blackfyre/spooder/openspec/specs/parametric-reference-parts/spec.md

# parametric-reference-parts Specification

## Purpose
Parametric solids of the reference printed parts (Aecert's hexapod and LilyGO's case shell), built from named dimensions, checked against their STL meshes and exported as STEP that opens in FreeCAD and solidcraft.

## Requirements

### Requirement: Parts built from named dimensions
Each converted part SHALL be generated by code from named, documented dimensions measured from its reference STL, and built from modelling features (sketches, extrusions, holes, chamfers, fillets), so that changing a dimension and rebuilding yields the changed part. A part SHALL NOT be produced by converting the mesh's triangles into a solid: part code SHALL NOT read files, and the build SHALL fail on a file in a parts folder that imports anything outside the stated allowlist or calls a file-reading or code-loading function. Each part SHALL be built in its reference STL's own coordinate frame. The reference files SHALL stay unchanged.

#### Scenario: A dimension changes
- **WHEN** a named dimension of a part is changed and the build is run in check mode
- **THEN** the part is rebuilt with that dimension, and the gates report its deviation from the STL

#### Scenario: A part file reads a mesh
- **WHEN** a file in a parts folder imports a module outside the allowlist, imports a mesh- or file-import function, or calls `open`
- **THEN** the build fails naming the part file, and writes no files

#### Scenario: Coordinate frame kept
- **WHEN** a built part is compared with its STL
- **THEN** both are compared in the STL's coordinates, without any alignment or transform

### Requirement: Parts discovered without a registry
The build SHALL find every part from its own file in a source's parts folder, with no shared list of parts. Each discovered part file SHALL declare exactly one part, except a mirrored pair; helper files, which the build does not discover, declare none. A mirrored pair SHALL be modelled once in one file that declares both sides, the second only by naming the first and the mirror plane, so that the build makes it as the mirror of the first; each side SHALL be checked against its own STL. The build SHALL fail on a discovered file declaring no part, more than one part (other than a mirrored pair), or a second side with its own model. Adding a part SHALL need only its part file, its committed STEP output, its source README's section and a changelog entry.

#### Scenario: A part file is added
- **WHEN** a new part file is placed in a source's parts folder
- **THEN** the next build checks and exports that part without any other file being edited

#### Scenario: A mirrored pair
- **WHEN** a part file declares a left and a right side, one the mirror of the other
- **THEN** the build checks each side against its own STL and exports each side

### Requirement: Gates against the reference STL
In check mode the build SHALL check each part and report every failure by part and gate. A part SHALL pass only when:
- it is one valid, closed solid;
- its volume lies within the stated volume tolerance of its STL's;
- the symmetric surface deviation, from points on the part's surface to the STL and from points on the STL to the part, has a maximum and a 95th percentile within the stated limits, where the points on each side include every vertex of that side's mesh subdivided to a stated maximum edge length as well as points sampled by area, and the documentation states the resulting bound on the unsampled deviation;
- each face of its bounding box lies within the stated tolerance of the STL's.

The tolerances SHALL be stated in the documentation with their justification against the STL's tessellation chord error. A part that cannot meet a gate with feature-based modelling SHALL have a documented, per-part exception naming the feature and the amount; the global tolerances SHALL NOT be loosened for it.

#### Scenario: A part fails a gate
- **WHEN** any part fails any gate
- **THEN** the build names the part, the gate and the measured value against its limit, exits non-zero, and writes no files

#### Scenario: Deviation measured both ways
- **WHEN** a part lacks a feature the STL has, or has a feature the STL lacks, standing more than the maximum deviation plus the stated sampling bound off the other surface, however small its area
- **THEN** the surface deviation gate fails

#### Scenario: Documented exception
- **WHEN** a part declares an exception for one gate
- **THEN** that part is checked against the exception's limit, the build prints the exception, and every other part keeps the global limits

### Requirement: STEP export written only after re-reading
When every part passes, the build SHALL write each part as STEP into a staging folder, re-read each file there as one solid with the built part's volume and bounding box, and only then replace the committed STEP folder as a whole, so that the folder never holds a mixture of old and new files; a run interrupted during the replacement SHALL leave the old files complete, and the next build SHALL restore them before anything else. STEP files of parts that no longer exist SHALL be removed. An unchanged part SHALL write an unchanged file.

#### Scenario: Export succeeds
- **WHEN** all gates pass and every staged STEP re-reads correctly
- **THEN** the STEP folder holds exactly one file per current part

#### Scenario: Re-read fails
- **WHEN** a staged STEP does not re-read as one solid with matching volume
- **THEN** the build reports it and the committed STEP folder is left as it was

#### Scenario: Replacement fails
- **WHEN** replacing the committed STEP folder with the staged one fails part way
- **THEN** the committed STEP folder holds either all the old files or all the new ones, or is restored with all the old files by the next build

### Requirement: Import checks in FreeCAD and solidcraft
The build SHALL check that each committed STEP imports as one closed solid, with volume within the stated tolerance of the built part's, in FreeCAD run headless and in solidcraft-cli. Each import check SHALL report its result per part, with the tool's version. When a tool is not installed, its check SHALL report `SKIPPED` with the reason, and the build's summary SHALL say which checks were skipped; it SHALL NOT report a pass. A failed import check SHALL fail the build. The tool versions last checked SHALL be recorded in the documentation.

#### Scenario: Tool present
- **WHEN** FreeCAD or solidcraft-cli is installed and a STEP imports as one solid with matching volume
- **THEN** the check reports a pass for that part with the tool's version

#### Scenario: Tool absent
- **WHEN** FreeCAD or solidcraft-cli is not installed, as on CI
- **THEN** the check reports `SKIPPED` naming the missing tool, and the summary lists it as skipped, not passed

#### Scenario: Import mismatch
- **WHEN** a STEP imports as more than one solid, or as an open shell, or with a volume outside tolerance
- **THEN** the build fails naming the part, the tool and the measured value

### Requirement: Documentation of the parametric parts
The parametric parts folder SHALL carry a README stating how a part is added, the part file's contract, the gates and their tolerances, the import checks with the tool versions checked, and how to run the build. Each source SHALL carry a README stating its source repository, the reference commit, its licence (for Aecert's parts: that upstream states no licence, said plainly, and beside it that the author knows about Spooder's derived models and has raised no concerns, stated as informal and not a licence), and a parts table per group, each part with its STL, its STEP file and any gate exception.

#### Scenario: A part is listed
- **WHEN** a part's file exists in a source's parts folder
- **THEN** that source's README lists the part with its STL and STEP file

#### Scenario: An exception is documented
- **WHEN** a part declares a gate exception
- **THEN** the source README names the feature responsible and the amount by which it exceeds the global limit

#### Scenario: Author's awareness stated
- **WHEN** the Aecert source README states that upstream gives no licence
- **THEN** it states beside it that the author knows about Spooder's derived models and has raised no concerns, and that this is informal and grants no licence

### Requirement: The frame group
The Aecert source SHALL include the frame group: Frame Top, Frame Bottom, Servo Mount, Bearing Axle Mount and Hubcap, each passing the gates and exported as STEP.

#### Scenario: Frame group built
- **WHEN** the build is run
- **THEN** it checks and exports the five frame parts, each against its STL in `hardware/aecert-hexapod-v1/stl/`

#### Scenario: A frame part is missing
- **WHEN** any of the five frame parts is not declared in the Aecert source's parts folder
- **THEN** the unit tests fail naming the missing part

### Requirement: The coxa group
The Aecert source SHALL include the coxa group: Coxa Horn Connector, Coxa Horn Side, Coxa Bearing Connector and Coxa Bearing Side, each modelled from features with named, sourced dimensions in its STL's own coordinates, each passing the gates under the global limits (or a documented per-part exception where the STL's own chord error exceeds 0.15 mm, or for a named feature that feature-based modelling cannot match, with its size), and each exported as STEP that passes the FreeCAD and solidcraft import checks where the tool is installed. The source README SHALL compare the built parts with the coxa link geometry that `hardware/aecert-hexapod-v1/README.md` records (the tongues' insert holes 21.5 mm from the coxa axis, the 8.05 mm ring, the ears 30.10 mm either side of the 28.5 mm hole pair's middle, the 68.25 × 48 mm side plates), giving for each value the recorded value and the model's, and state each disagreement. The unit tests SHALL check that the four coxa parts are declared and that the model's values in that comparison match the built solids.

#### Scenario: Coxa group built
- **WHEN** the build is run
- **THEN** it checks and exports the four coxa parts, each against its STL in `hardware/aecert-hexapod-v1/stl/`, and each STEP file passes the FreeCAD and solidcraft import checks where the tool is installed, and reports `SKIPPED` where it is not

#### Scenario: A coxa part is missing
- **WHEN** any of the four coxa parts is not declared in the Aecert source's parts folder
- **THEN** the unit tests fail naming the missing part

#### Scenario: Coxa comparison matches the built parts
- **WHEN** the unit tests build the four coxa parts
- **THEN** each value of the recorded coxa link geometry, measured on the built solids, matches the model's value that the source README's coxa comparison states to 0.01 mm, the comparison's recorded values match those in `hardware/aecert-hexapod-v1/README.md`, each difference above 0.05 mm is marked as a disagreement and no other is, and a part changed so that a compared value moves fails the test

#### Scenario: Recorded coxa geometry compared
- **WHEN** a value of the coxa link geometry recorded in `hardware/aecert-hexapod-v1/README.md` differs from the built part's by more than 0.05 mm
- **THEN** the source README marks it as a disagreement, with the recorded value, the model's value and the part

### Requirement: The femur group
The Aecert source SHALL include the femur group: Femur Horn Side, Femur Bearing Side and Femur Support, each built from features in its STL's own coordinates, passing the gates (with only documented per-part exceptions) and exported as STEP. The femur's axis-to-axis length, the distance between the two bore axes of each femur side plate, SHALL be one named constant from which both side plates place their bores, and the unit tests SHALL check it against the bore axes found on the built solids.

#### Scenario: Femur group built
- **WHEN** the build is run
- **THEN** it checks and exports Femur Horn Side, Femur Bearing Side and Femur Support, each against its STL in `hardware/aecert-hexapod-v1/stl/`, and each STEP file passes the FreeCAD and solidcraft import checks where the tool is installed, and reports `SKIPPED` where it is not

#### Scenario: A femur part is missing
- **WHEN** any of the three femur parts is not declared in the Aecert source's parts folder
- **THEN** the unit tests fail naming the missing part

#### Scenario: Axis-to-axis length checked
- **WHEN** the unit tests build Femur Horn Side and Femur Bearing Side
- **THEN** each side's two bore axes, found from the solid's cylindrical faces, lie the named axis-to-axis length apart, and a bore placed elsewhere fails the test

#### Scenario: Axis-to-axis length changed
- **WHEN** the unit tests rebuild Femur Horn Side and Femur Bearing Side with the named axis-to-axis length changed
- **THEN** both sides' bore axes lie the changed length apart, and a side that does not place its bores from the named length fails the test

### Requirement: The feet group
The Aecert source SHALL include the feet group: Foot Left, Foot Right, Foot Shaft and Foot Tip, each built from named dimensions in its STL's coordinates, passing the gates (the global limits, or a documented per-part exception) and exported as STEP. The serpentine flexure in Foot Left and Foot Right SHALL be modelled from named dimensions of its path and beam widths, shared by both feet, so that changing one and rebuilding changes the spring of both. Foot Right SHALL be built from Foot Left's model, not modelled separately: since its STL is Foot Left's mirror image moved 1.069 mm along y, which a mirror plane cannot express, Foot Right SHALL be a part file of its own whose build mirrors Foot Left's solid and moves it, rather than the second side of a mirrored pair.

#### Scenario: Feet group built
- **WHEN** the build is run
- **THEN** it checks and exports Foot Left, Foot Right, Foot Shaft and Foot Tip, each against its STL in `hardware/aecert-hexapod-v1/stl/`, and each STEP file imports as one closed solid in FreeCAD and solidcraft

#### Scenario: A foot part is missing
- **WHEN** any of the four foot parts is not declared in the Aecert source's parts folder
- **THEN** the unit tests fail naming the missing part

#### Scenario: The flexure is retuned
- **WHEN** a flexure beam width in the shared foot model is raised by 0.3 mm and both feet are rebuilt
- **THEN** Foot Left and Foot Right both differ from their unchanged builds, and each fails its volume or surface deviation gate against its STL

#### Scenario: A foot STL's chord error is too coarse
- **WHEN** a foot part's STL chord error, as `chord_error.measure` gives it, exceeds 0.15 mm
- **THEN** that part declares a `deviation_max` exception naming the feature, with the limit at the chord error plus 0.05 mm rounded up to 0.01 mm, and the source README's row for it gives the feature, the limit and the amount over the global limit

#### Scenario: A foot feature is freeform
- **WHEN** a foot part has a freeform feature that feature-based modelling cannot match
- **THEN** that part declares an exception for the failing gate only, whose reason starts with "freeform" and whose limit exceeds the global limit, and the source README's row for it gives the feature, the limit and the amount over the global limit

#### Scenario: Other foot parts keep the global limits
- **WHEN** a foot part's chord error is at most 0.15 mm and it has no freeform feature
- **THEN** it declares no exception
