blackfyre/spooder/openspec/specs/gamepad-control/spec.md

# gamepad-control Specification

## Purpose
How the gamepad bridge turns a Bluetooth gamepad's input into the commands it sends the robot.

## Requirements

### Requirement: Stick modes
The bridge SHALL offer two stick modes, steer and crab, toggled by `b` (one toggle per press) and kept across a controller reconnect like the other settings. Steer SHALL be the default. This requirement supersedes the stick rows of the input mapping table.
- In steer mode, left stick Y SHALL set the forward or backward translate, left stick X SHALL steer, and the translate's sideways part SHALL be zero. While the left stick points backward by more than 10 %, the robot SHALL reverse and steering SHALL be mirrored as a car's is: steering left while reversing turns the body clockwise. Between 0 and 10 % backward there SHALL be no reverse and no mirroring, so that a stick held sideways turns the body on the spot without flipping direction.
- In crab mode, the left stick SHALL set the translate vector and the right stick X the rotate amount, as before.
- In both modes, right stick X SHALL add to the rotate amount, and the sum SHALL be clamped to −100..100. A stick pushed right SHALL turn the body clockwise, and left anticlockwise.
- The status screen SHALL show the stick mode.

#### Scenario: Steering while walking
- **WHEN** steer mode is on and the left stick points forward and to the left
- **THEN** the command carries a forward translate with no sideways part and a rotate amount that turns the body anticlockwise

#### Scenario: Steering while reversing
- **WHEN** steer mode is on and the left stick points backward and to the left
- **THEN** the command carries a backward translate and a rotate amount that turns the body clockwise

#### Scenario: Crab mode keeps the old layout
- **WHEN** crab mode is on and the left stick points to the right
- **THEN** the command carries a sideways translate and no rotation

### Requirement: Supported controllers
The bridge SHALL accept one gamepad at a time through Bluepad32, including Bluetooth Classic gamepads such as DualShock 4, DualSense, Switch Pro and 8BitDo pads. A second gamepad SHALL be refused while one is connected.

#### Scenario: Second gamepad
- **WHEN** a gamepad is connected and another tries to connect
- **THEN** the second gamepad is refused and the first keeps control

### Requirement: Input mapping
The bridge SHALL map gamepad input to the desired movement state as follows. Button names are Bluepad32's.

| Input | Effect |
|---|---|
| Left stick | Translate vector, scaled to −100..100 per axis, magnitude clamped to 100 |
| Right stick X | Rotate amount, −100..100; right stick Y unused |
| `miscHome` (press) | Toggle requested mode between Stand and Walk |
| `y` (press) | Toggle Sleep. Leaving Sleep returns to the mode requested before it |
| `miscBack` + `miscHome` held 1 s | Toggle Calibrate. Leaving it returns to Stand |
| `r1` / `l1` (press) | Next / previous gait, wrapping around |
| D-pad up / down (press) | Body height +10 / −10, within 0..100 |
| D-pad right / left (press) | Speed +10 / −10, within 0..100 |
| `x` (press) | Toggle stride mode between dynamic and fixed |
| `thumbL` + `thumbR` held 1 s | Fault-clear request |

Toggles and steps SHALL act once per press. Holding a button SHALL NOT repeat it.

#### Scenario: Gait selection wraps
- **WHEN** the last gait is selected and `r1` is pressed
- **THEN** the first gait is selected

#### Scenario: Calibrate needs a deliberate hold
- **WHEN** `miscBack` and `miscHome` are pressed together and released after 0.5 s
- **THEN** Calibrate is not toggled

### Requirement: Stick dead zone
Stick deflections within a radial dead zone of 8 % of full scale SHALL be reported as zero. Outside the dead zone, output SHALL rise continuously from zero, with no jump at the edge.

#### Scenario: Drifting stick
- **WHEN** the left stick rests at 5 % deflection
- **THEN** the translate vector is zero

#### Scenario: Continuous beyond the dead zone
- **WHEN** the left stick moves from 7 % to 10 % deflection
- **THEN** the translate magnitude rises from zero without a step

### Requirement: Controller connection
While no gamepad is connected, the bridge SHALL request Sleep with zero translate and rotate, and report that no controller is connected. When a gamepad connects, the requested mode SHALL start as Stand, and the height, speed, gait and stride settings SHALL be kept from before.

#### Scenario: Gamepad disconnects while walking
- **WHEN** the gamepad disconnects while the robot is walking
- **THEN** the bridge's next command frame requests Sleep with zero input

#### Scenario: Reconnect
- **WHEN** a gamepad reconnects
- **THEN** the requested mode is Stand and the previous height, speed and gait are kept

### Requirement: Bridge emergency-stop button
The bridge's GPIO35 button SHALL toggle emergency stop. While emergency stop is active, the bridge SHALL signal it in every command frame and show it on the screen.

#### Scenario: Emergency stop from the bridge
- **WHEN** the GPIO35 button is pressed
- **THEN** every subsequent command frame signals emergency stop until the button is pressed again

### Requirement: Rumble feedback
The bridge SHALL rumble the connected gamepad when a protection fault newly latches on the robot, when its own emergency stop switches on or off, when the robot link is lost or regained while a gamepad is connected, and when a gesture request is not acted on within 0.6 s, with a distinct pattern per event. Faults and stops present when the gamepad connects SHALL NOT rumble. A more important event SHALL replace a lighter rumble in progress, a lighter event during a more important rumble SHALL play after it, and the same event SHALL NOT repeat within 1 s.

#### Scenario: Fault while driving
- **WHEN** the robot latches an overcurrent fault while the gamepad drives it
- **THEN** the gamepad rumbles long and strong once

#### Scenario: Existing fault on connect
- **WHEN** a gamepad connects while a fault is already latched
- **THEN** the gamepad does not rumble for it

#### Scenario: Refused gesture
- **WHEN** a gesture is requested while the robot walks
- **THEN** the gamepad gives a light tap about 0.6 s later
