blackfyre/spooder/.archify/architecture-spooder-system-20261018-171500/spooder-system.html

Dark

Style

Visual identitySto cycle

ClassicStable technical default Signal FlowMotion-forward presentation BlueprintEngineering review EditorialPublication and launch notes

Live Present

Export

Export diagramPortable, clean outputs

E

Share Route Share Card1200×630 PNG Reach Share Card1200×630 PNG Copy diagramPNG to clipboard

Image PNGLossless image JPEGCompact image WebPModern image

Vector & motion SVG · AutoMatches host theme SVG · LightAlways light SVG · DarkAlways dark WebM6s motion

# Spooder: robot, gamepad bridge, desktop tools and virtual robot

Diagram guide Explore this system ×

Inspecting compiled semantics

01 Find any nodeSearch labels, responsibilities, kinds, and stable IDs. / 02 Trace a routeAsk how two semantic nodes connect in authored direction. R 03 See the whole systemOpen Semantic Radar with a live viewport and stable nodes. M 04 Compare semantic kindsCount roles, reveal their traffic, and compare direct authored links. L 05 Enter Presentation StageGive the live diagram the viewport without changing export. F

E ExportT ThemeS Style0 Reset+ Zoom in- Zoom outEsc Close

Find Archify useful? A star on GitHub helpsStar ↗ (https://github.com/tt-a1i/archify)

Find a node ×

⌕ /

No matching nodes

Semantic passport

Verified source

Authored reach

Upstream0 Downstream0

× Copy link Relations

Path Click where the path starts Find start Copy link Clear

Click two nodes on the diagram

← ▶ Journey → Overview

Click a start, then an end. Paths follow the arrows.

Semantic lens Compare system roles ×

Choose up to two semantic kinds. One reveals its real traffic; two compare only direct authored relationships.

Choose a kind to inspect its nodes and touching relationships.

Copy link Clear

Semantic radar Building overview Open radar ×

Click nodeDrag to pan

Semantic radar needs more MAP space.

Notes & index

ROUTE MAP LENS 100%

### How to read

- Built and host-tested at 1c5d910; bring-up on hardware in progress
- Tagged "planned": suspended sensor work
- Bridge: Bluetooth in normal mode, WiFi only in setup mode
- Virtual robot: the Servo 2040's robot_tick on the host, for desktop-sim and e2e

### Safety rules

- Input, then protection, every 20 ms tick
- E-stop from either link latches; clear only from the source in control
- Both links claiming control: conflict, robot sleeps
- Calibration only in Calibrate, ±30° of defaults, 60°/s; coxas shown from centre

### Link protocol v2

- Commands 50 Hz, telemetry 10 Hz, CRC-16 frames
- Pose 10 Hz, USB only: command, servo angle and pulse per joint
- Calibration sets resent until a report confirms them
- Golden vectors shared by the C++ and Go tests
