blackfyre/spooder/.archify/architecture-spooder-planned-20261017-061917/spooder-planned.html

Dark

Style

Visual identitySto cycle

ClassicStable technical default Signal FlowMotion-forward presentation BlueprintEngineering review EditorialPublication and launch notes

Live Present

Export

Export diagramPortable, clean outputs

E

Share Route Share Card1200×630 PNG Reach Share Card1200×630 PNG Copy diagramPNG to clipboard

Image PNGLossless image JPEGCompact image WebPModern image

Vector & motion SVG · AutoMatches host theme SVG · LightAlways light SVG · DarkAlways dark WebM6s motion

# Spooder: built firmware and planned bridge and sensors

Diagram guide Explore this system ×

Inspecting compiled semantics

01 Find any nodeSearch labels, responsibilities, kinds, and stable IDs. / 02 Trace a routeAsk how two semantic nodes connect in authored direction. R 03 See the whole systemOpen Semantic Radar with a live viewport and stable nodes. M 04 Compare semantic kindsCount roles, reveal their traffic, and compare direct authored links. L 05 Enter Presentation StageGive the live diagram the viewport without changing export. F

E ExportT ThemeS Style0 Reset+ Zoom in- Zoom outEsc Close

Find Archify useful? A star on GitHub helpsStar ↗ (https://github.com/tt-a1i/archify)

Find a node ×

⌕ /

No matching nodes

Semantic passport

Verified source

Authored reach

Upstream0 Downstream0

× Copy link Relations

Path Click where the path starts Find start Copy link Clear

Click two nodes on the diagram

← ▶ Journey → Overview

Click a start, then an end. Paths follow the arrows.

Semantic lens Compare system roles ×

Choose up to two semantic kinds. One reveals its real traffic; two compare only direct authored relationships.

Choose a kind to inspect its nodes and touching relationships.

Copy link Clear

Semantic radar Building overview Open radar ×

Click nodeDrag to pan

Semantic radar needs more MAP space.

Notes & index

ROUTE MAP LENS 100%

### How to read

- Tagged "planned" and dashed: designed in OpenSpec, not built yet
- Everything else is built and host-tested at commit 61f6b99

### Protection rules

- Output only after 500 ms of valid supply
- Overcurrent, brown-out, overvoltage: output cut at once
- Sustained current, undervoltage: Sleep
- After any fault nothing moves until a new request

### Planned link and sensors

- Bridge replaces the serial hook; frames carry desired state, not events
- Robot sleeps if no valid frame arrives for 1 s
- Sensors read on core 1, handed to core 0 by seqlock; telemetry only for now
