blackfyre/spooder/openspec/specs/static-checks/spec.md

# static-checks Specification

## Purpose
Static checks of Spooder's own C++ and Go: a formatting check of the C++, clang-tidy on the hardware-free core, and staticcheck on the desktop calibrator, all with pinned tools and part of the verification gates.

## Requirements

### Requirement: C++ formatting check
The repository SHALL have a `.clang-format` at its root, and `mise run lint` SHALL fail when any C++ source or header, tracked or untracked but not git-ignored, in Spooder's own directories (`core/`, `firmware/servo2040/src/`, `firmware/bridge/main/`, `test/`, `tools/virtual-robot/`, `tools/bridge-screenshots/`) differs from its clang-format output, naming each such file. The check SHALL NOT cover `external/`, `managed_components/`, the generated fonts in `firmware/bridge/main/fonts/`, `test/golden/` or `core/movement/calibration_defaults.cpp`, and SHALL NOT modify any file.

#### Scenario: Unformatted file
- **WHEN** a C++ file in a checked directory is not in clang-format's layout
- **THEN** `mise run lint` exits non-zero and names the file, and the file is unchanged

#### Scenario: New file not yet staged
- **WHEN** an untracked, not git-ignored C++ file in a checked directory is not in clang-format's layout
- **THEN** `mise run lint` exits non-zero and names the file

#### Scenario: Excluded files
- **WHEN** a file under `external/`, `managed_components/`, `firmware/bridge/main/fonts/` or `test/golden/`, or `core/movement/calibration_defaults.cpp`, is not in clang-format's layout
- **THEN** `mise run lint` does not report it

#### Scenario: Exported calibration stays valid
- **WHEN** the desktop calibrator exports `core/movement/calibration_defaults.cpp`
- **THEN** `mise run lint` still passes without reformatting the export

### Requirement: Static analysis of the core
`mise run lint` SHALL run clang-tidy, with the checks configured in a root `.clang-tidy`, on every `core/` source file in the host compile database, reporting findings in `core/` headers too. The check set SHALL include `bugprone-*` and narrowing conversions, and every enabled check's finding SHALL fail the task. A finding SHALL be fixed, or suppressed at the line or in the configuration with a comment giving the reason.

#### Scenario: New finding
- **WHEN** a change to `core/` introduces a finding of an enabled check, such as a narrowing conversion from `float` to `int`
- **THEN** `mise run lint` exits non-zero and reports the file, line and check

#### Scenario: Finding in a core header
- **WHEN** a header in `core/` included by an analysed source contains a finding of an enabled check
- **THEN** `mise run lint` exits non-zero and reports the header, line and check

#### Scenario: Every core source analysed
- **WHEN** `mise run lint` runs
- **THEN** clang-tidy analyses every source listed in the `native` environment's `build_src_filter`, from a compile database written in that run

#### Scenario: Suppressed finding
- **WHEN** a finding is suppressed with `NOLINT` or `NOLINTNEXTLINE` naming the check
- **THEN** the suppression carries a comment giving the reason

### Requirement: Static analysis of the desktop calibrator
`mise run desktop-test` SHALL run staticcheck on every package of `desktop/`, after `gofmt` and `go vet` and before `go test`, and SHALL fail on any finding. staticcheck SHALL be pinned by a `tool` directive in `desktop/go.mod`, with its modules' checksums in `desktop/go.sum`.

#### Scenario: Go finding
- **WHEN** a desktop package has a staticcheck finding
- **THEN** `mise run desktop-test` exits non-zero and reports it

#### Scenario: Pinned analyser
- **WHEN** `mise run desktop-test` runs on a clean checkout
- **THEN** it runs the staticcheck version recorded in `desktop/go.mod` and `desktop/go.sum`, without resolving any other version

### Requirement: Pinned C++ tools
clang-format and clang-tidy SHALL be pinned to exact versions in `mise.toml`, and `mise run lint` SHALL use those versions.

#### Scenario: Tool versions
- **WHEN** `mise run lint` runs after `mise install`
- **THEN** it uses the clang-format and clang-tidy versions pinned in `mise.toml`

### Requirement: Checks in the gates
`mise run lint` SHALL be one of the verification gates listed in the root `CLAUDE.md`, and CI SHALL run it, and `mise run desktop-test` with staticcheck, on every push to `main` and `deliver/*` and on every pull request.

#### Scenario: CI
- **WHEN** a commit with an unformatted C++ file, a clang-tidy finding in `core/` or a staticcheck finding in `desktop/` is pushed to a `deliver/*` branch
- **THEN** the CI run fails
