blackfyre/spooder/openspec/changes/firmware-build-identity/proposal.md

## Why

Nothing the robot or the bridge prints says which build is running. A board flashed from an old checkout, from the other side of a protocol change, or with uncommitted edits looks the same as a current one; the only sign of a mismatched pair is a link that looks lost. Each firmware should name its build where the operator already looks: the robot's USB console and the bridge's console and screen.

## What Changes
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
