blackfyre/spooder/openspec/changes/harden-host-tests/design.md

# Design

## Context

The host tests are PlatformIO's `native` env in the root `platformio.ini` (`test_build_src = yes`, `src_dir = core`), run by `mise run test` with `pio test -e native` and then the bridge build-check test. `build_src_filter` lists the 25 `core/` sources one by one; today it matches `find core -name '*.cpp'` exactly. CI runs `mise run test` on `ubuntu-24.04`, whose GCC 13 ships the ASan
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
