blackfyre/spooder/docs/images/charts-light.png

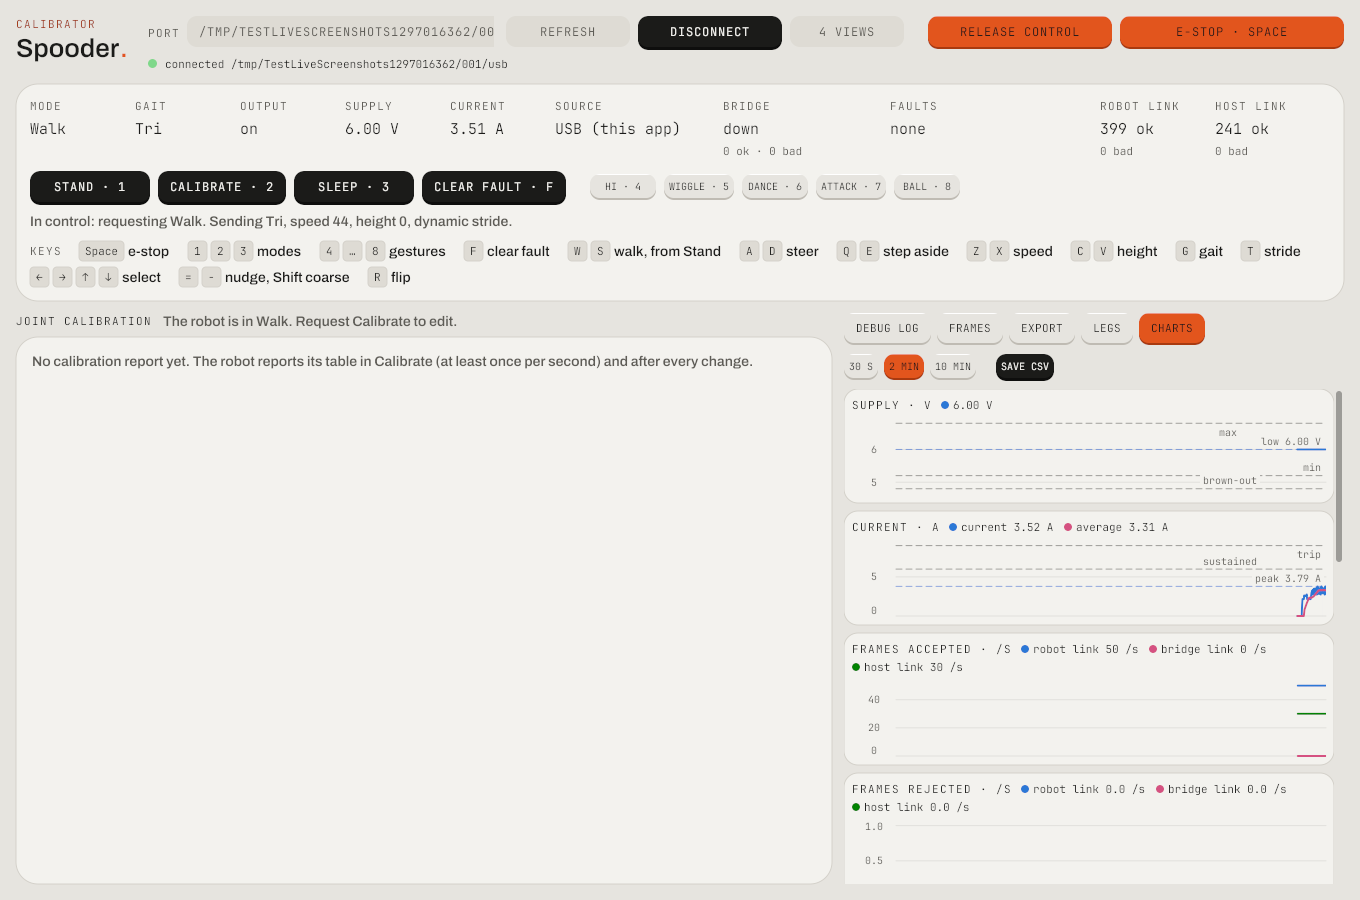
docs/images/charts-light.png
