blackfyre/spooder/docs/images/estop-light.png

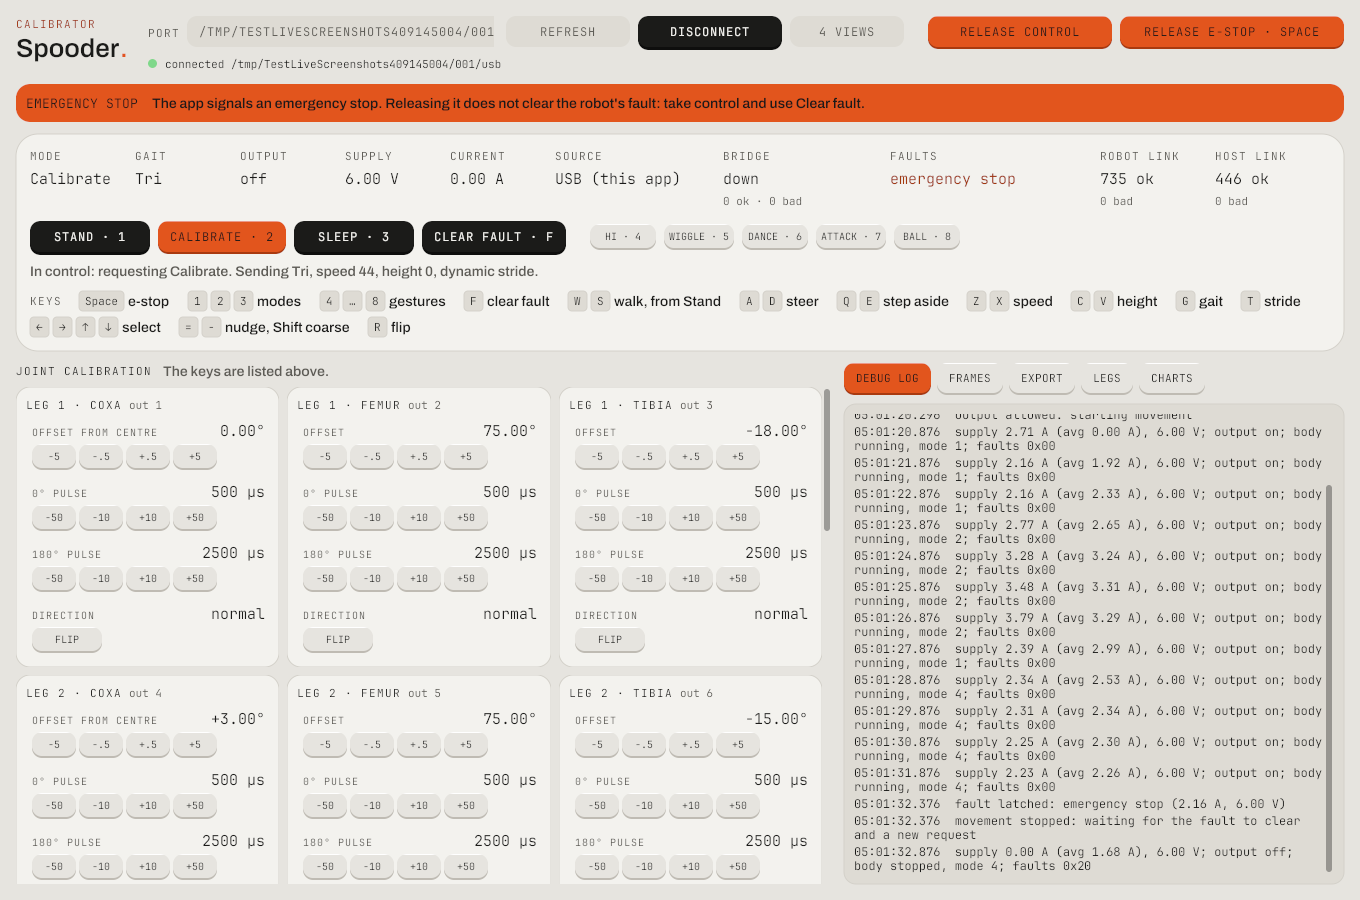
docs/images/estop-light.png
