blackfyre/spooder/docs/images/four-views-light.png

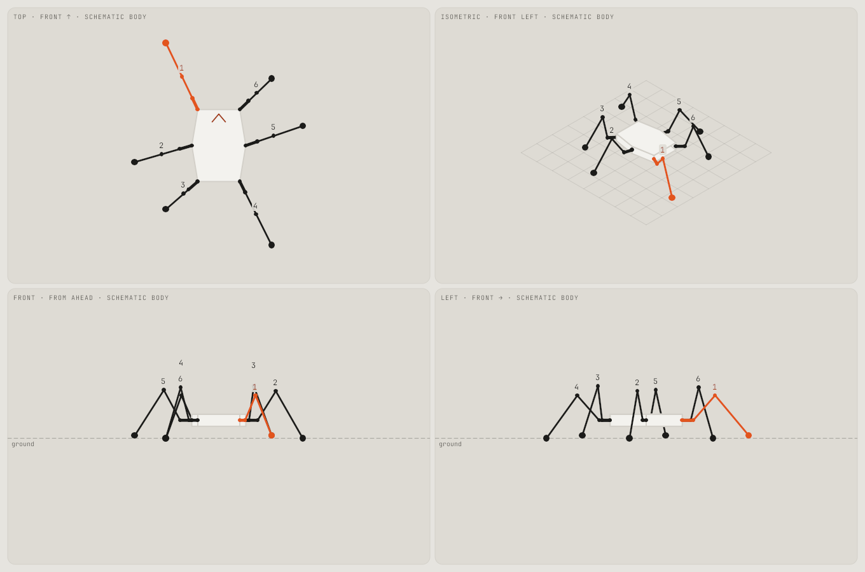
docs/images/four-views-light.png
