blackfyre/spooder/docs/images/walking-legs-light.png

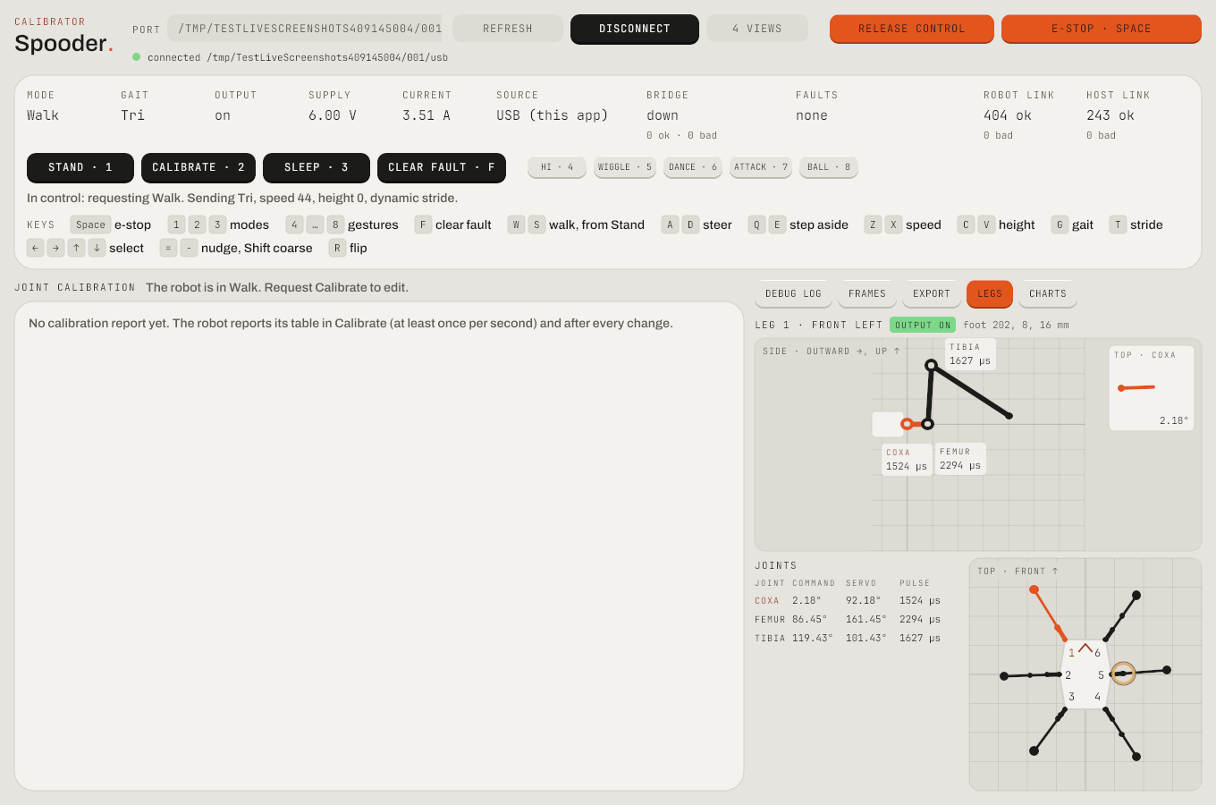
docs/images/walking-legs-light.png
