blackfyre/spooder/hardware/pimoroni-servo2040/servo-2040-drawing.png

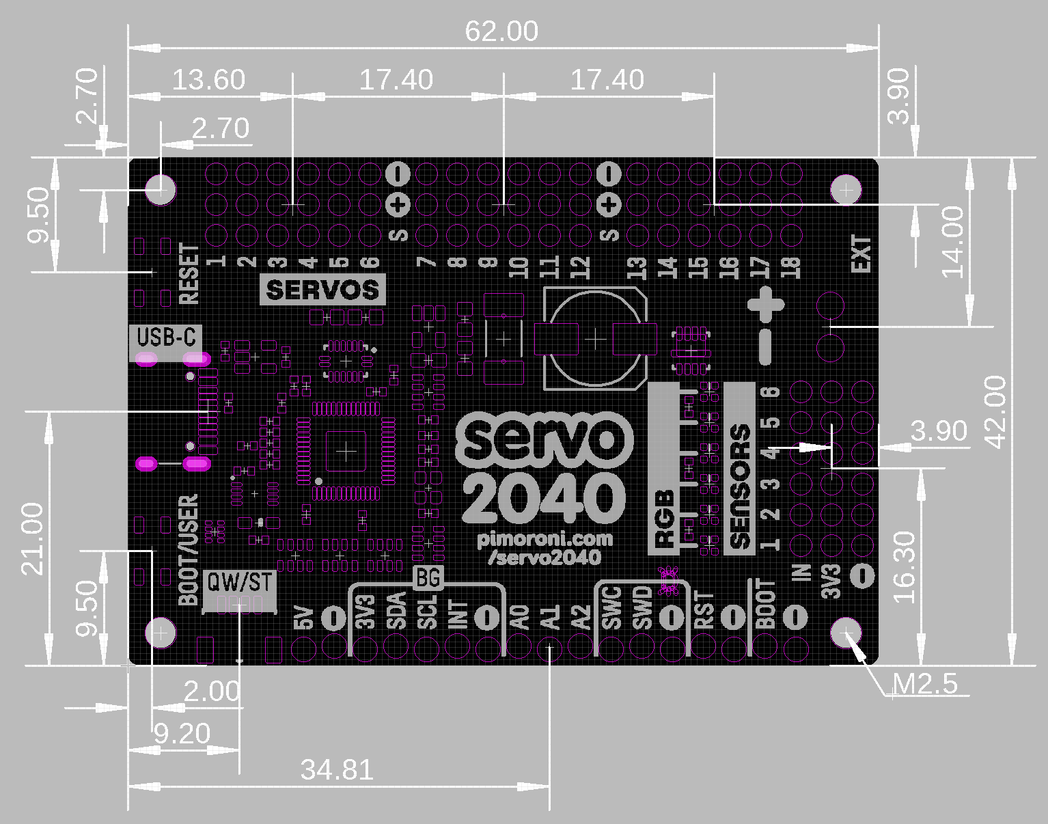
hardware/pimoroni-servo2040/servo-2040-drawing.png
