blackfyre/spooder/hardware/spooder-electronics-mount/images/closed.png

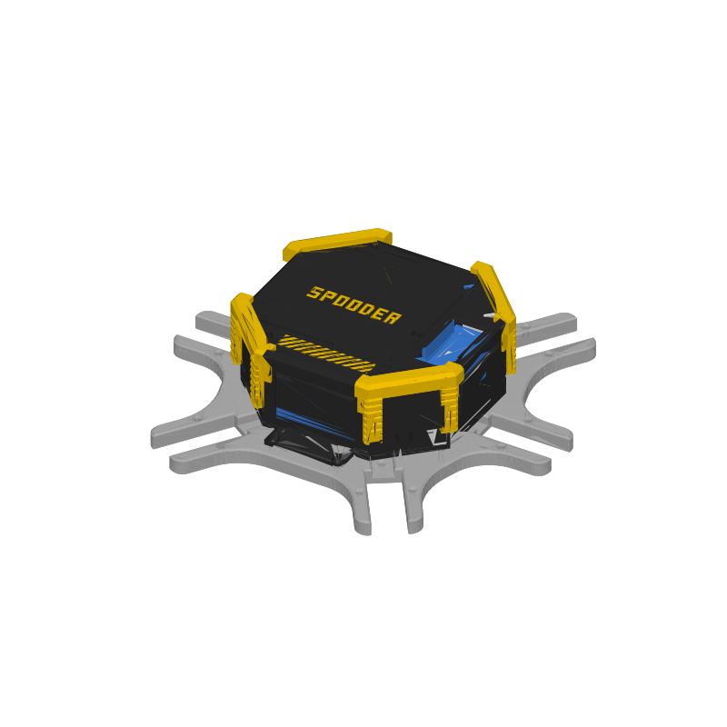
hardware/spooder-electronics-mount/images/closed.png
