blackfyre/spooder/hardware/spooder-electronics-mount/images/top.png

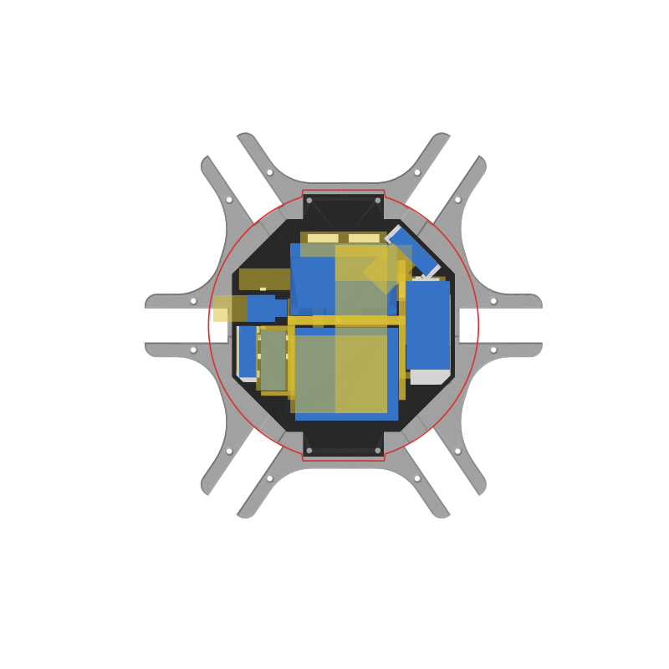
hardware/spooder-electronics-mount/images/top.png
