blackfyre/spooder/openspec/changes/parametric-femur-parts/tasks.md

# Tasks

## 1. Femur group

- [x] 1.1 Measure Femur Horn Side and Femur Bearing Side with trimesh (sections, probes, circle fits) and model them in `aecert-hexapod-v1/parts/femur_horn_side.py` and `femur_bearing_side.py`, with the shared outline, slots, middle hole and `AXIS_TO_AXIS` (110.000 mm, citing the 108 in `hardware/aecert-hexapod-v1/README.md`; design: "The axis-to-axis length") in `parts/_femur.py`. Verify `uv run --locked --quiet --script build.py --check` passes both against their STLs, and `build.py --chord-error` prints each one's chord error (an exception declared for any above 0.15 mm).
- [x] 1.2 Measure and model Femur Support in `aecert-hexapod-v1/parts/femur_support.py`, its widening outline from features, with an exception for that gate only if features cannot meet it (design: "Exceptions"). Verify `build.py --check` passes it (with any declared exception printed) and `build.py --chord-error` prints its chord error.
- [x] 1.3 Add `hardware/parametric-reference-parts/test_femur.py`: the three femur part files declare exactly the three femur parts, failing naming a missing one; each side's two bore axes, found from the built solid's cylindrical faces, lie `AXIS_TO_AXIS` apart to 0.01 mm; rebuilt with `AXIS_TO_AXIS` raised by 1 mm, both sides' axes lie the raised length apart (design: "The axis-to-axis length"). Verify `build.py --test` passes, and, with each temporary edit reverted after its run, fails when one side's second bore is offset by 0.5 mm from `AXIS_TO_AXIS`, fails when one side places its second bore at a literal 110.0 instead of `AXIS_TO_AXIS`, and fails naming Femur Support when its part file's declaration is renamed.
- [x] 1.4 Export the three parts to `aecert-hexapod-v1/step/` and commit them with their part files. Verify, locally with FreeCAD and solidcraft-cli installed, `mise run cad-reference` passes with every FreeCAD and solidcraft import check `PASS` for the three femur parts (on CI, where they are absent, the checks report `SKIPPED`), and a second run leaves `git status` clean.

## 2. Documentation

- [ ] 2.1 Add the femur group's section to `aecert-hexapod-v1/README.md` (the parts table with part file, STL, STEP, measured volume, maximum deviation, 95th percentile and exception; the axis-to-axis length and its difference from `hardware/aecert-hexapod-v1/README.md`'s 108; each exception's feature and amount over the global limit), remove the femur line from "Groups still to model", and add one line to `CHANGELOG.md` under Unreleased. Verify every femur part declared in `parts/` and every femur file in `step/` appears in the femur table, `grep -c 'Femur' CHANGELOG.md` rises by exactly one line, and `openspec validate parametric-femur-parts` passes.
