blackfyre/spooder/openspec/changes/parametric-coxa-parts/tasks.md

# Tasks

## 1. Coxa group

- [x] 1.1 Measure each coxa STL's chord error with `uv run --locked --quiet --script build.py --chord-error`, and record it per part for the source README; plan a per-part exception (limit: the chord error plus 0.05 mm) for any part above 0.15 mm. Verify the command prints a chord error for each of the four coxa parts and the recorded values match its output.
- [x] 1.2 Model Coxa Horn Side and Coxa Bearing Side in `aecert-hexapod-v1/parts/` (`coxa_horn_side.py`, `coxa_bearing_side.py`, shared shapes in `_coxa.py`), each from named constants measured with trimesh (sections, probes, circle fits), each comment giving its source, in the STL's own coordinates, each declaring one part. Verify `uv run --locked --quiet --script build.py --check` passes both under the global limits, or under an exception that names its feature and size and that the source README records.
- [x] 1.3 Model Coxa Horn Connector and Coxa Bearing Connector the same way (`coxa_horn_connector.py`, `coxa_bearing_connector.py`). Verify `uv run --locked --quiet --script build.py --check` passes all four coxa parts and the five frame parts, and `git diff --name-only main` lists no file of the shared tooling (`build.py`, `discovery.py`, `gates.py`, `export.py`, `import_check.py`, `freecad_import.py`, `test_build.py`, `../README.md`).
- [x] 1.4 Add `hardware/parametric-reference-parts/test_coxa.py` (design: "Checking the recorded coxa link geometry"): the four coxa part files declare exactly the four coxa parts with their STLs, one assertion per part whose message names it; and, on the built solids, each tongue's insert hole distance from the coxa axis (21.5 mm), the ring's height (8.05 mm) and the hole's height in it (4.025 mm), each ear hole's distance from the middle of the side plate's hole pair (30.10 mm) and the pair's spacing (28.5 mm), and the side plates' outline (68.25 × 48 mm), each found from the solid's faces and compared to 0.01 mm with the model's value in the coxa comparison table of `aecert-hexapod-v1/README.md`; the table's recorded column checked against the recorded values held as named constants in `test_coxa.py` (each citing `hardware/aecert-hexapod-v1/README.md`), and its `disagrees` marker present exactly where the two differ by more than 0.05 mm. Write that table (recorded value, model's value, part, `disagrees`) in the README's coxa section. Verify `uv run --locked --quiet --script build.py --test` passes, and, with each temporary edit reverted after its run, fails when a connector's insert hole is moved 0.5 mm along the tongue, fails when one model value in the table is changed by 0.1 mm, fails when one recorded value in the table is changed by 0.1 mm, fails when a `disagrees` marker is removed or added against the 0.05 mm threshold, and fails naming Coxa Bearing Side when its part file's declaration is renamed.
- [x] 1.5 Export the four parts with `mise run cad-reference` and commit the part files with `step/Coxa Horn Connector.step`, `step/Coxa Horn Side.step`, `step/Coxa Bearing Connector.step` and `step/Coxa Bearing Side.step`. Verify, locally with FreeCAD and solidcraft-cli installed, `mise run cad-reference` passes with every FreeCAD and solidcraft import check of the coxa parts reporting `PASS` (on CI, where they are absent, the checks report `SKIPPED`), and a second run leaves `git status --porcelain` empty.

## 2. Documentation

- [ ] 2.1 In `aecert-hexapod-v1/README.md`: add, beside the sentence that upstream states no licence, that the author knows about Spooder's derived models and has raised no concerns (informal, not a licence); complete the "Coxa group" section with the frame section's table (part file, STL, STEP, volume, maximum deviation, 95th percentile, exception) from the `--check` run, the chord errors and any exception with its feature and amount, beside the comparison table from 1.4; remove the coxa line from "Groups still to model". Add one line to `CHANGELOG.md` under Unreleased. Verify `grep -c '^| Coxa ' aecert-hexapod-v1/README.md` prints 4, `sed -n '/^## Groups still to model/,$p' aecert-hexapod-v1/README.md | grep -c 'Coxa'` prints 0, `grep 'upstream states no licence' aecert-hexapod-v1/README.md | grep 'no concerns' | grep -c 'grants no licence'` prints 1 (the awareness on the licence line, stated as granting no licence), `git diff main -- CHANGELOG.md | grep -c '^+- '` prints 1, and `openspec validate parametric-coxa-parts` passes.
