blackfyre/spooder/hardware/aecert-hexapod-v1/stl/All Parts.3mf

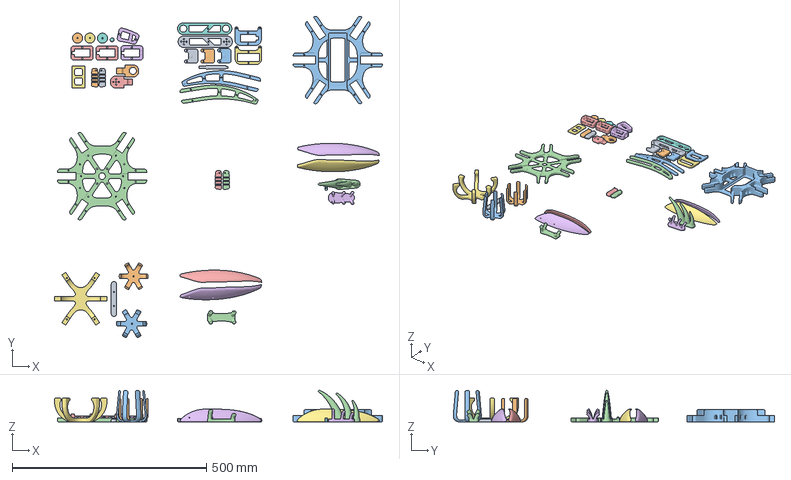
[picture p31: CAD file, 2026-10-22]
hardware/aecert-hexapod-v1/stl/All Parts.3mf
844.9 x 827.6 x 81.2 mm
Bearing Axle Mount.stl x 3
Coxa Bearing Connector.stl
Coxa Bearing Side.stl
Spikes.stl
Coxa Horn Connector.stl
Armor Attachment Base.stl
Coxa Horn Side.stl
Femur Bearing Side.stl
Femur Horn Side.stl
Hubcap.stl x 3
Tibia Right.stl
Tibia Left.stl
Servo Mount.stl x 3
Tibia Support.stl
Femur Support.stl
Foot Tip.stl
Foot Left.stl x 2
Foot Right.stl x 2
Frame Bottom.stl
Frame Top.stl
Foot Shaft.stl
Armor Plate Left.stl
Armor Plate Right.stl
Attachment Peg.stl
Cup Holder Mount.stl
Cup Holder.stl
Cup Holder V2.stl
Armor Attachment Base V2.stl
Armor Plate Left V2.stl
Armor Plate Right V2.stl
Roll Cage - Screws.stl
