blackfyre/spooder/hardware/parametric-reference-parts/aecert-hexapod-v1/step/Foot Shaft.step

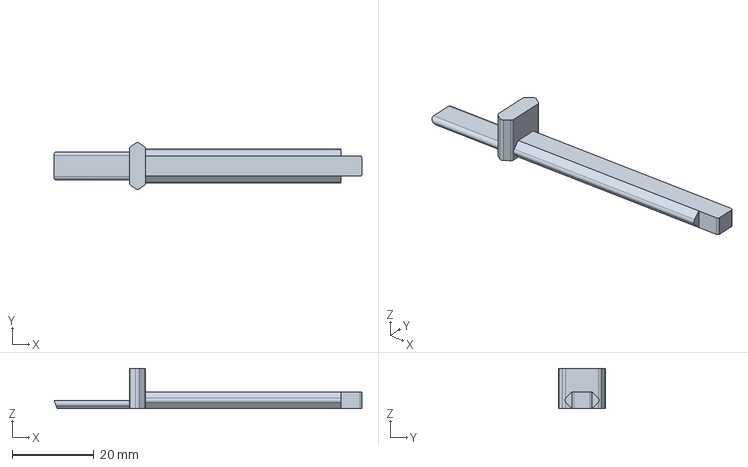
[picture p32: CAD file, 2026-11-11]
hardware/parametric-reference-parts/aecert-hexapod-v1/step/Foot Shaft.step
75.3 x 11.4 x 9.79 mm
