blackfyre/spooder/hardware/spooder-electronics-mount/step/cover.step

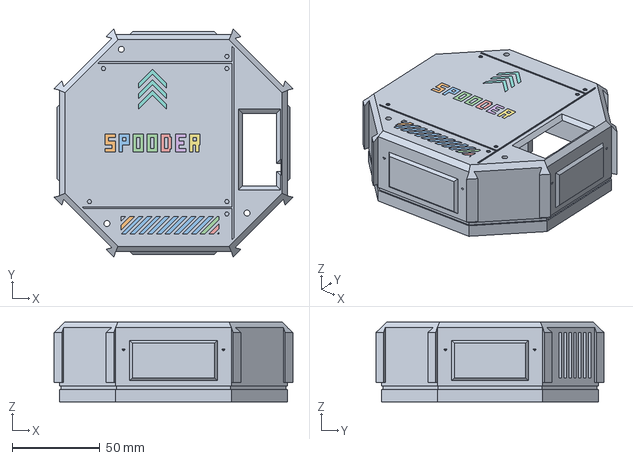
[picture p33: CAD file, 2026-10-24]
hardware/spooder-electronics-mount/step/cover.step
136.5 x 130.5 x 45.6 mm
