blackfyre/spooder/hardware/aecert-hexapod-v1/stl/Leg Parts B.stl

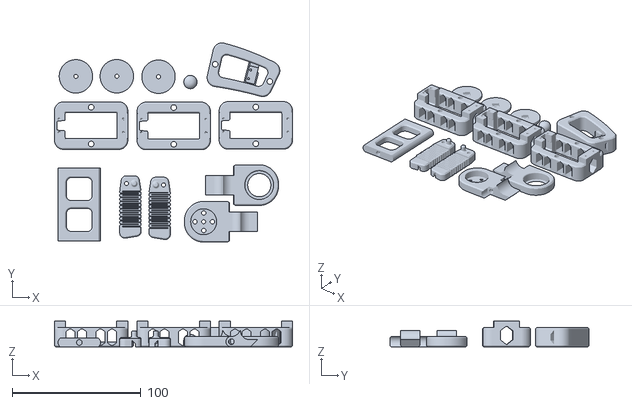
[picture p34: CAD file, 2026-10-22]
hardware/aecert-hexapod-v1/stl/Leg Parts B.stl
185.0 x 154.8 x 20.0
