blackfyre/spooder/hardware/parametric-reference-parts/aecert-hexapod-v1/step/Foot Right.step

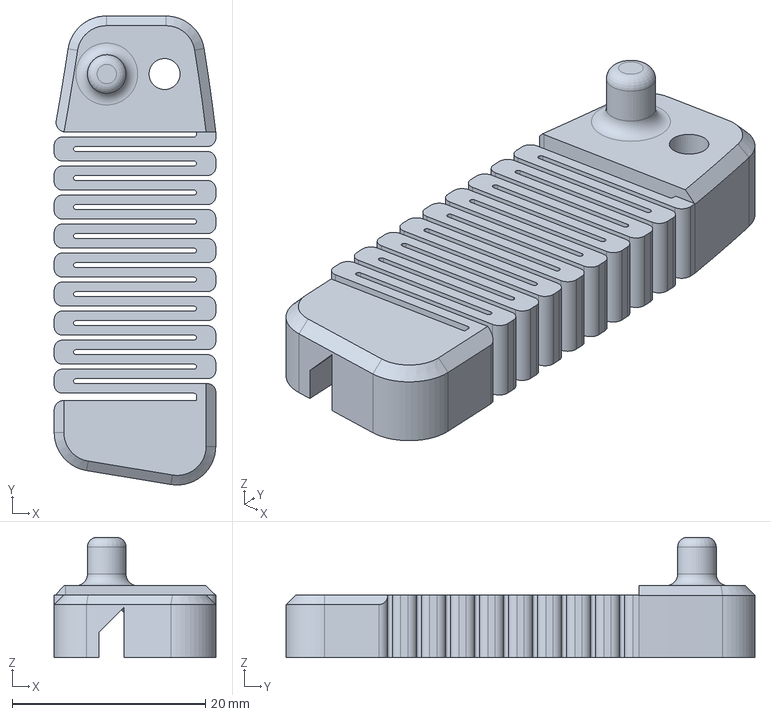
[picture p35: CAD file, 2026-11-11]
hardware/parametric-reference-parts/aecert-hexapod-v1/step/Foot Right.step
16.7 x 48.5 x 12.4 mm
