blackfyre/spooder/hardware/spooder-electronics-mount/step/bumper.step

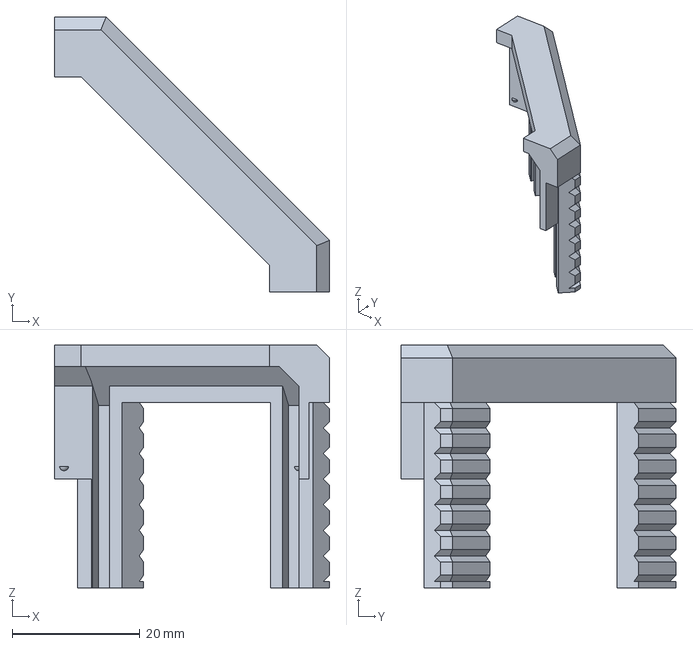
[picture p36: CAD file, 2026-10-24]
hardware/spooder-electronics-mount/step/bumper.step
43.0 x 43.0 x 37.9 mm
