blackfyre/spooder/hardware/spooder-electronics-mount/step/t-display-holder.step

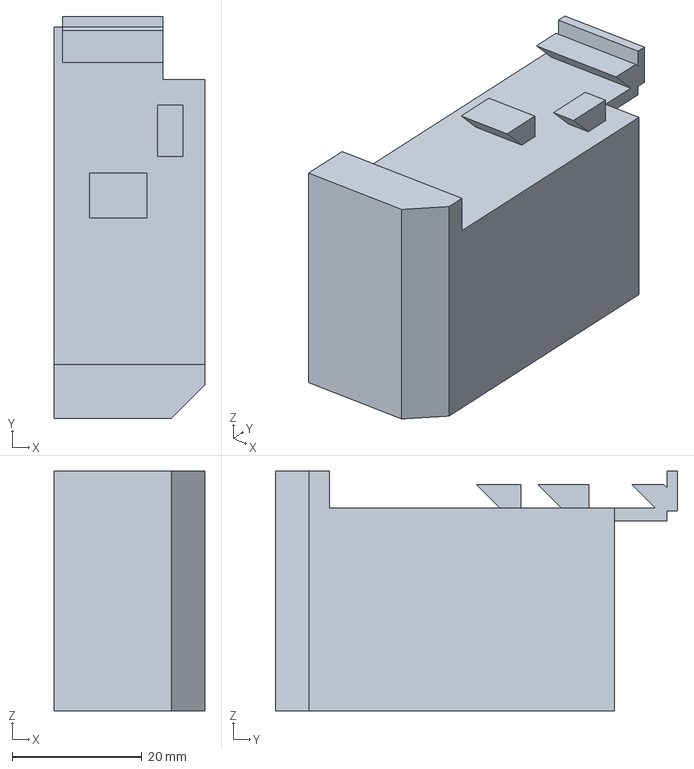
[picture p37: CAD file, 2026-10-24]
hardware/spooder-electronics-mount/step/t-display-holder.step
23.3 x 62.0 x 37.0 mm
