blackfyre/spooder/hardware/parametric-reference-parts/aecert-hexapod-v1/step/Foot Tip.step

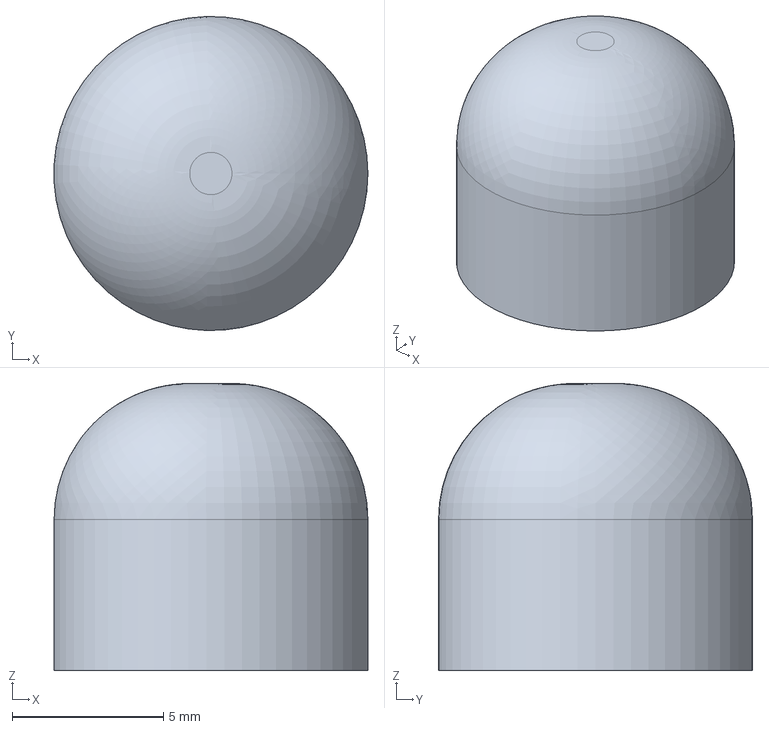
[picture p38: CAD file, 2026-11-11]
hardware/parametric-reference-parts/aecert-hexapod-v1/step/Foot Tip.step
10.4 x 10.4 x 9.50 mm
