blackfyre/spooder/hardware/spooder-electronics-mount/step/exhaust-fan-holder-right.step

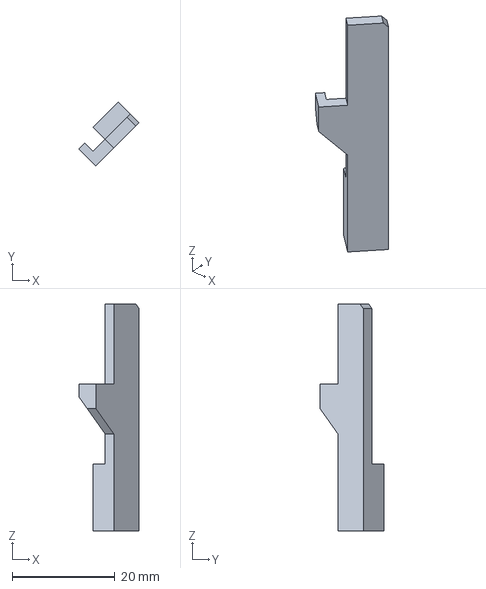
[picture p39: CAD file, 2026-10-24]
hardware/spooder-electronics-mount/step/exhaust-fan-holder-right.step
11.7 x 12.4 x 44.2 mm
