blackfyre/spooder/hardware/parametric-reference-parts/aecert-hexapod-v1/step/Femur Support.step

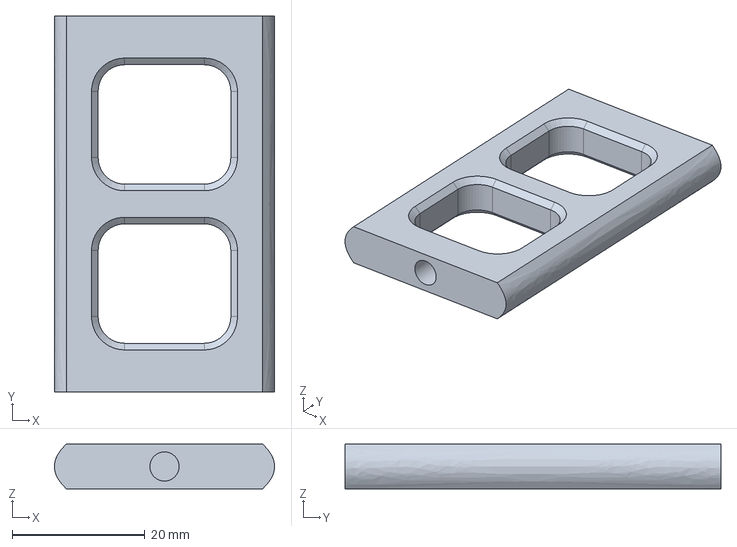
[picture p40: CAD file, 2026-11-11]
hardware/parametric-reference-parts/aecert-hexapod-v1/step/Femur Support.step
33.2 x 56.7 x 6.77 mm
