blackfyre/spooder/hardware/spooder-electronics-mount/step/exhaust-fan-holder-left.step

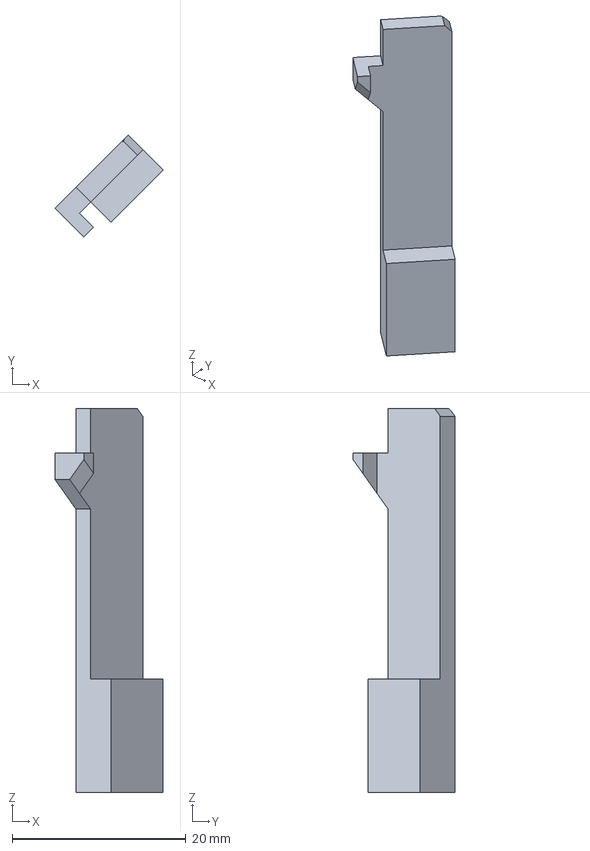
[picture p41: CAD file, 2026-10-24]
hardware/spooder-electronics-mount/step/exhaust-fan-holder-left.step
12.4 x 11.7 x 44.2 mm
