blackfyre/spooder/hardware/parametric-reference-parts/aecert-hexapod-v1/step/Femur Bearing Side.step

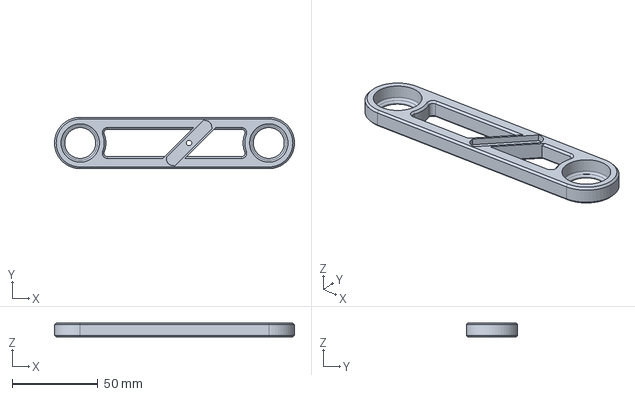
[picture p42: CAD file, 2026-11-11]
hardware/parametric-reference-parts/aecert-hexapod-v1/step/Femur Bearing Side.step
140.0 x 30.0 x 8.35 mm
