blackfyre/spooder/hardware/spooder-electronics-mount/step/intake-fan-holder.step

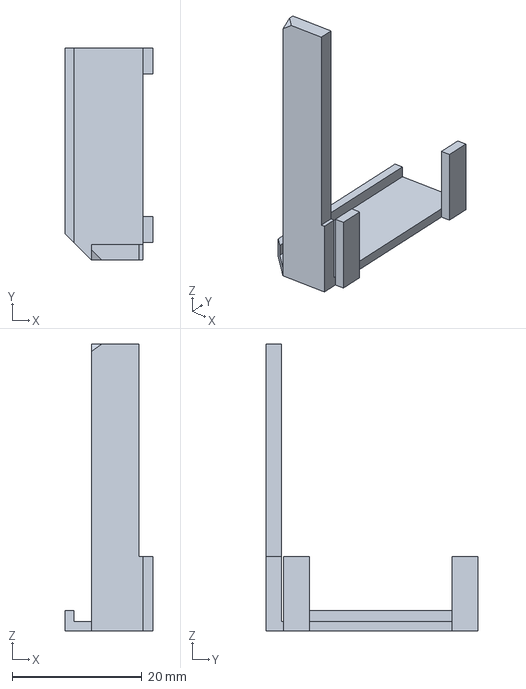
[picture p43: CAD file, 2026-10-24]
hardware/spooder-electronics-mount/step/intake-fan-holder.step
13.5 x 32.7 x 44.2 mm
