blackfyre/spooder/hardware/spooder-electronics-mount/step/imu-pad.step

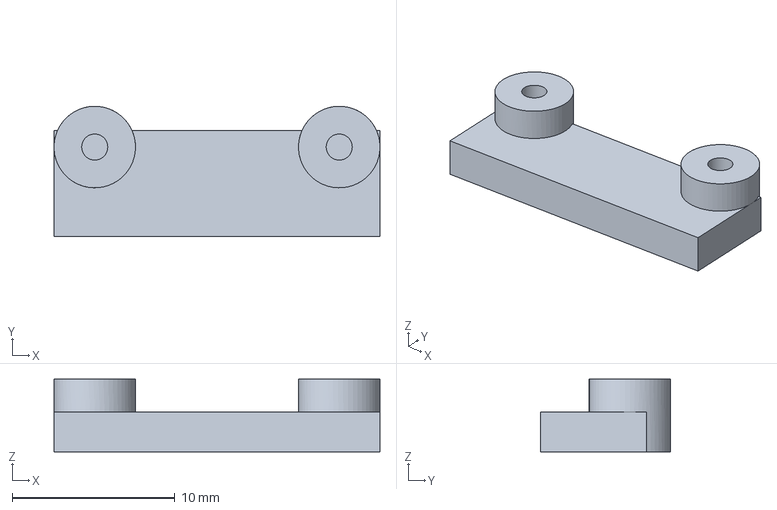
[picture p45: CAD file, 2026-10-24]
hardware/spooder-electronics-mount/step/imu-pad.step
20.0 x 8.00 x 4.45 mm
