blackfyre/spooder/hardware/spooder-electronics-mount/step/lm2596-standoff.step

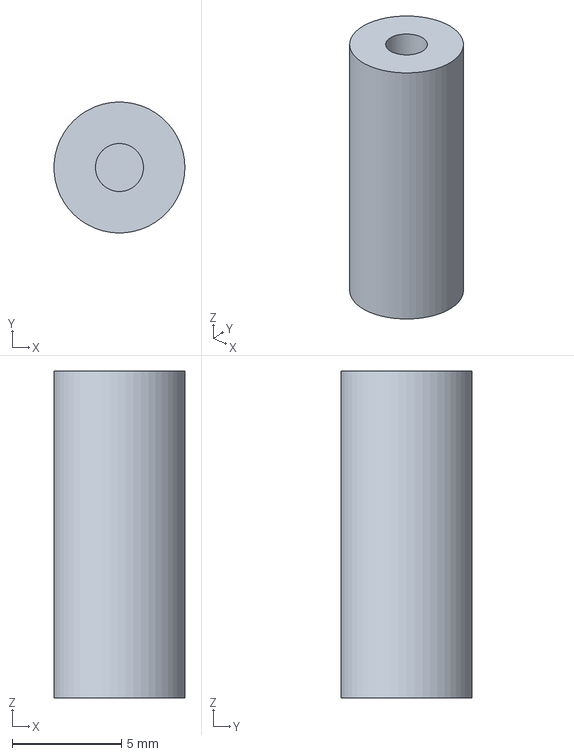
[picture p47: CAD file, 2026-10-24]
hardware/spooder-electronics-mount/step/lm2596-standoff.step
5.99 x 6.00 x 15.0 mm
