blackfyre/spooder/hardware/parametric-reference-parts/aecert-hexapod-v1/step/Coxa Bearing Connector.step

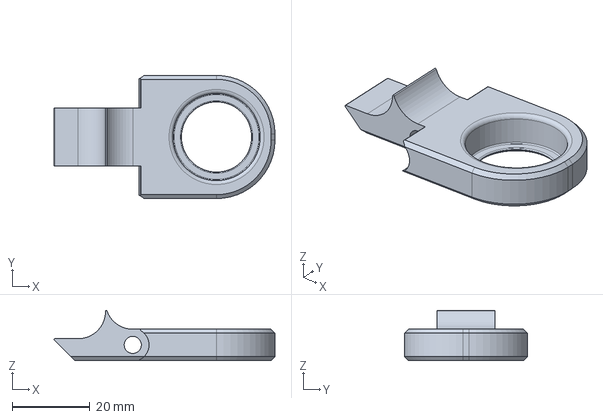
[picture p48: CAD file, 2026-11-11]
hardware/parametric-reference-parts/aecert-hexapod-v1/step/Coxa Bearing Connector.step
56.7 x 31.6 x 12.9 mm
