blackfyre/spooder/hardware/spooder-electronics-mount/step/deck.step

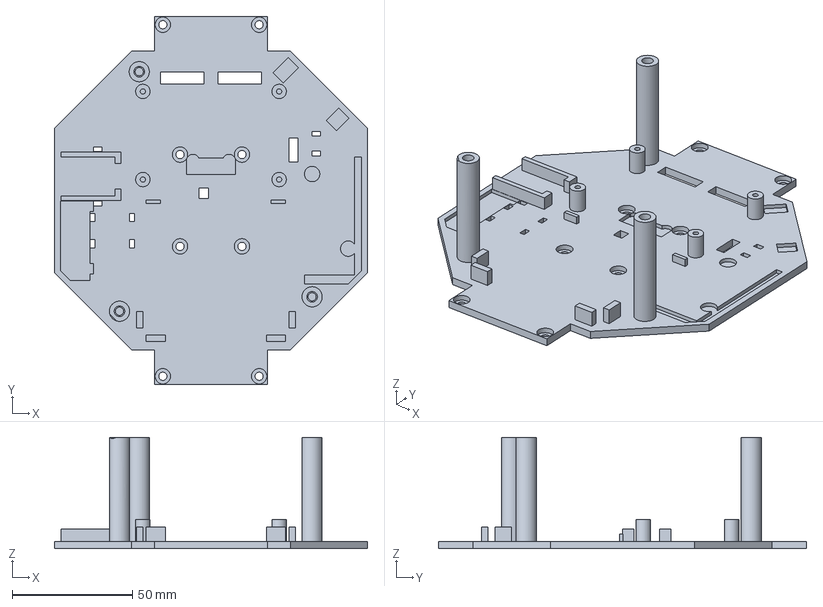
[picture p49: CAD file, 2026-10-24]
hardware/spooder-electronics-mount/step/deck.step
130.0 x 153.0 x 46.2 mm
