blackfyre/spooder/hardware/spooder-electronics-mount/step/spacer.step

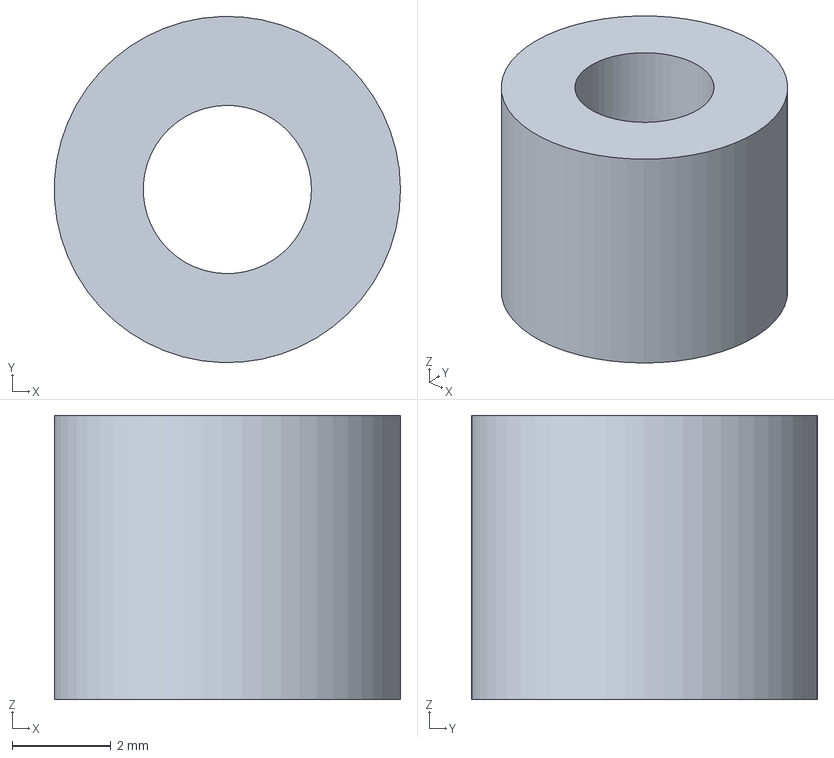
[picture p51: CAD file, 2026-10-24]
hardware/spooder-electronics-mount/step/spacer.step
6.99 x 7.00 x 5.75 mm
