blackfyre/spooder/hardware/parametric-reference-parts/aecert-hexapod-v1/step/Coxa Bearing Side.step

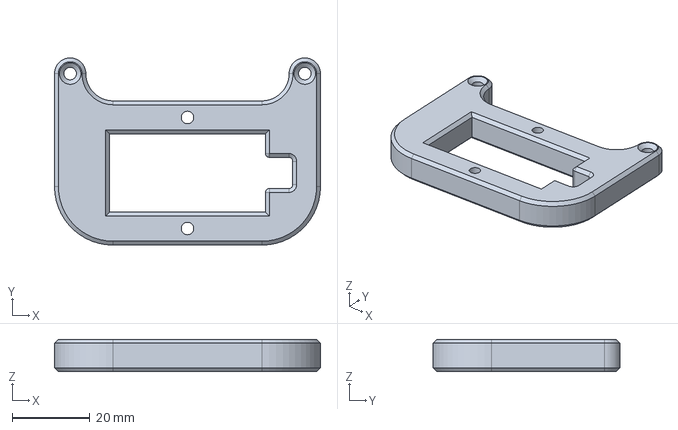
[picture p52: CAD file, 2026-11-11]
hardware/parametric-reference-parts/aecert-hexapod-v1/step/Coxa Bearing Side.step
68.2 x 48.0 x 8.30 mm
