blackfyre/spooder/hardware/parametric-reference-parts/aecert-hexapod-v1/step/Bearing Axle Mount.step

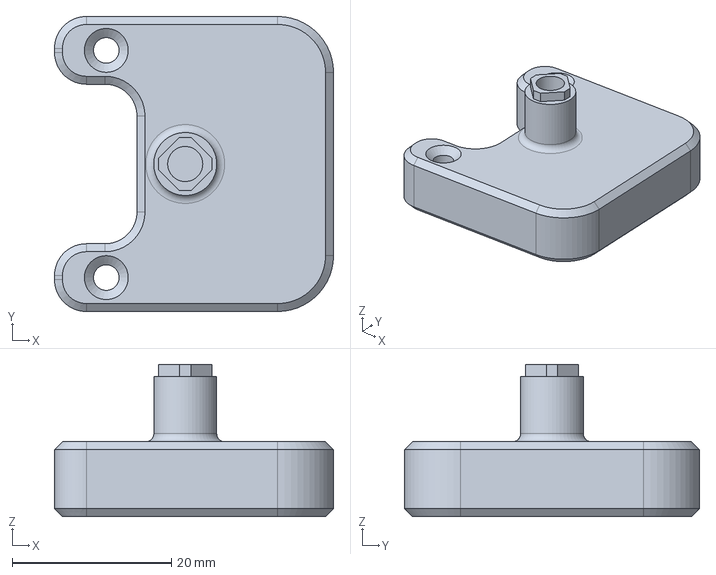
[picture p53: CAD file, 2026-11-10]
hardware/parametric-reference-parts/aecert-hexapod-v1/step/Bearing Axle Mount.step
35.0 x 37.0 x 19.1 mm
