blackfyre/spooder/hardware/parametric-reference-parts/aecert-hexapod-v1/step/Frame Top.step

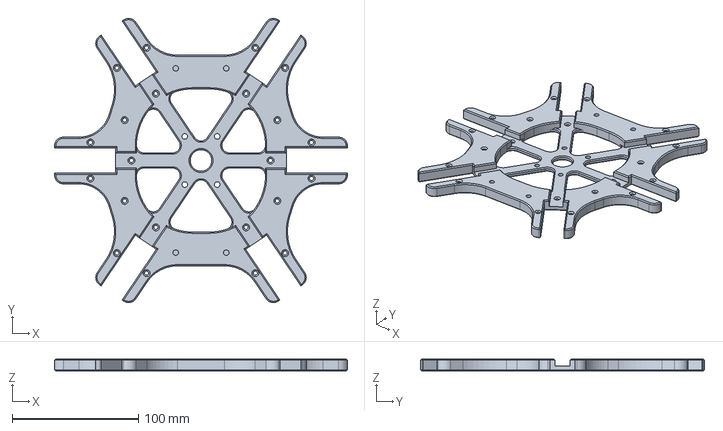
[picture p54: CAD file, 2026-11-10]
hardware/parametric-reference-parts/aecert-hexapod-v1/step/Frame Top.step
232.2 x 225.2 x 9.75 mm
