blackfyre/spooder/hardware/parametric-reference-parts/aecert-hexapod-v1/step/Hubcap.step

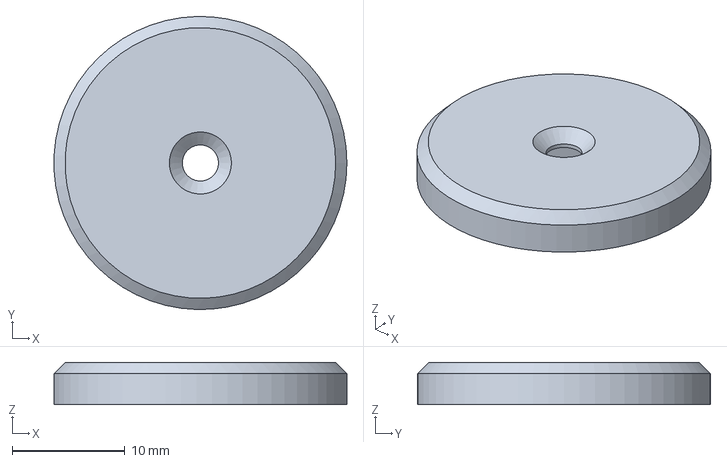
[picture p55: CAD file, 2026-11-10]
hardware/parametric-reference-parts/aecert-hexapod-v1/step/Hubcap.step
26.0 x 26.0 x 3.75 mm
