blackfyre/spooder/hardware/parametric-reference-parts/aecert-hexapod-v1/step/Frame Bottom.step

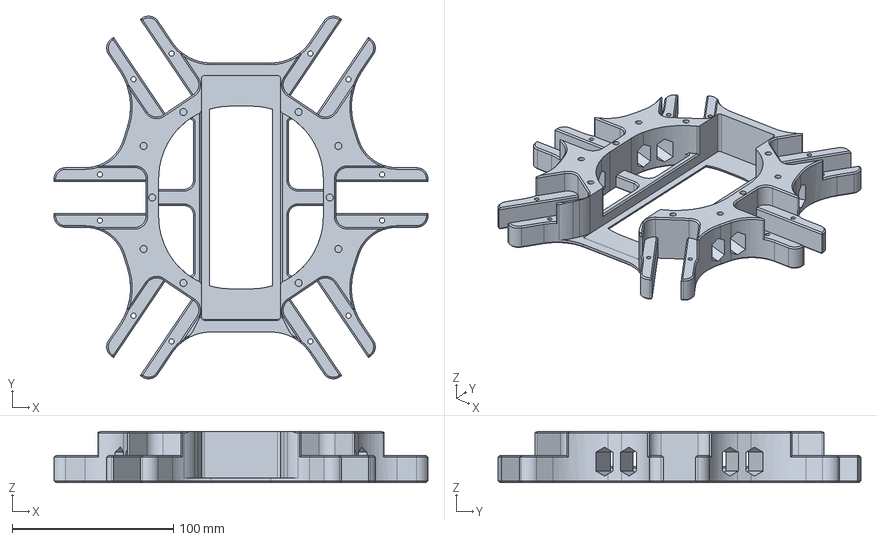
[picture p56: CAD file, 2026-11-10]
hardware/parametric-reference-parts/aecert-hexapod-v1/step/Frame Bottom.step
232.2 x 225.2 x 31.8 mm
