blackfyre/spooder/hardware/parametric-reference-parts/aecert-hexapod-v1/step/Servo Mount.step

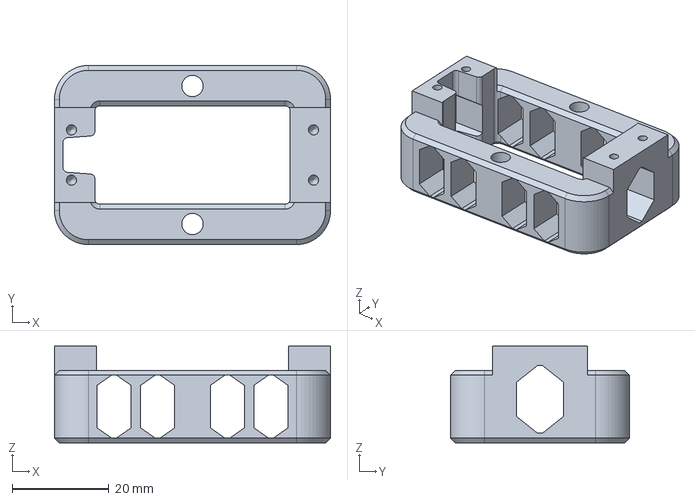
[picture p57: CAD file, 2026-11-10]
hardware/parametric-reference-parts/aecert-hexapod-v1/step/Servo Mount.step
57.0 x 37.0 x 20.0 mm
