blackfyre/spooder/(list of files, cad)

Other CAD files:
hardware/parametric-reference-parts/aecert-hexapod-v1/step/Foot Left.step
hardware/spooder-electronics-mount/print/bumper.stl
hardware/spooder-electronics-mount/print/cover.3mf
hardware/spooder-electronics-mount/print/deck.stl
hardware/spooder-electronics-mount/print/exhaust-fan-holder-left.stl
hardware/spooder-electronics-mount/print/exhaust-fan-holder-right.stl
hardware/spooder-electronics-mount/print/imu-pad.stl
hardware/spooder-electronics-mount/print/intake-fan-holder.stl
hardware/spooder-electronics-mount/print/lm2596-standoff.stl
hardware/spooder-electronics-mount/print/spacer.stl
hardware/spooder-electronics-mount/print/t-display-holder.stl
