blackfyre/spooder/openspec/changes/firmware-build-identity/tasks.md

## 1. Identity and banner text

- [x] 1.1 Add `cmake/build_identity.cmake` (script mode, the repository root and the output path as `-D` variables: `git describe --always --dirty --abbrev=12`, `unknown` on any failure, `\` and `"` escaped for the C++ literal, the generated source rewritten only when its content changes). Verify with `cmake -P` against disposable fixture repositories in a scratch directory, never the delivery branch: a clean fixture (no `-dirty`); the same after editing a tracked file (`-dirty`); the same after a new commit (the new hash); a directory that is not a checkout (`unknown`); `PATH` without `git` (`unknown`); a fixture with an annotated tag `v"1` (the generated source compiles with `c++ -c` and holds the escaped describe output); and two runs with no change between them (the file's modification time unchanged).
- [x] 1.2 Add `core/identity/build_identity.{h,cpp}` (`banner` and `fit`, the `ID` declaration) and list it in the root `platformio.ini`; verify with a new `test/test_build_identity` covering the banner form, an empty and a null id (`unknown`), non-printable bytes including 0xA5 (`?`), the 40-character cut and `fit` keeping the end (`..` followed by the last characters, including `-dirty`).

## 2. Robot and virtual robot

- [x] 2.1 In `core/robot/robot_tick`, take the identity in `init` (defaulting to `"unknown"`), add `Inputs::usbConnected`, and log the banner on the first tick (before the servo profile line) and on each tick where `usbConnected` is true after a false tick, as the first line of that tick. Verify with `test/test_robot_tick` via `mise run test`: banner then profile line on the first tick; one banner when connected from the first tick; none while connected for many ticks; one again after a false tick then a true tick; and the banner first when the same tick also logs another line (a latched fault).
- [x] 2.2 Wire the generated source into `firmware/servo2040/CMakeLists.txt` and pass the identity and `stdio_usb_connected()` from `main.cpp`. Verify, from a committed tree, that `mise run build` and `mise run build --serial` pass; that a second build with no change compiles no source (Ninja's output lists no `.obj`/`.o` step); that `strings build/servo2040/spooder.elf` shows the current describe output; and that after a temporary edit of a tracked file (restored afterwards) a rebuild without reconfiguring shows the `-dirty` identity and compiles only the generated source.
- [x] 2.3 Wire it into `tools/virtual-robot/CMakeLists.txt` and pass the identity and `board.usb.connected()` from its `main.cpp`. Add a desktop e2e test that opens the virtual robot's USB terminal and finds the `spooder robot: build ` line with an identity equal to `git describe --always --dirty --abbrev=12` of the checkout (which `mise run e2e` has just built from), after the banner's rules (bytes outside printable ASCII as `?`, cut at 40 characters), and finds it again after `unplug` and `plug`. Verify that `mise run virtual-robot` passes, the same no-change and dirty-tree rebuild checks as 2.2 hold, and `mise run e2e` passes.

## 3. Bridge

- [x] 3.1 Wire the generated source into `firmware/bridge/main/CMakeLists.txt` and add `build_identity.cpp` there; print `spooder bridge: build <id>` first in `setup()` and in `setup_mode_start`; have `display::setup` take the build line and queue `Build <fitted id>` before `Boot`. Verify, from a committed tree, that `mise run build-bridge` passes and the size check still passes; that a second build with no change compiles no source; and that after a temporary edit of a tracked file (restored afterwards) a rebuild puts the `-dirty` identity in the image (`strings` on the built `.elf`).

## 4. Documentation and gates

- [x] 4.1 Update the `spooder-hardware-check` skill (the robot banner on connect, the bridge console line and the start-up log line), `core/CLAUDE.md` (the new module) and `CHANGELOG.md` under Unreleased. Verify by reading them against the spec deltas.
- [x] 4.2 Run the gates: `mise run test`, `mise run build` with and without `--serial`, `mise run build-bridge`, `mise run desktop-test`, `mise run desktop-build` and `mise run e2e`. Verify that all pass.

## 5. On the boards

- [x] 5.1 Flash the robot (`mise run upload`), noting `git describe --always --dirty --abbrev=12` at build time. Verify that `mise run monitor`, opened after boot, shows `spooder robot: build <id>` with that identity (after the banner's `?` replacement and 40-character cut) as the first robot text after its own connection line, and again after closing it and reopening it more than a second later.
  - Done 2026-11-06: built from a clean worktree at 11ca2a0 (`git describe --always --abbrev=12`: `11ca2a01267e`) and flashed with `mise run upload`; `mise run monitor` showed `spooder robot: build 11ca2a01267e` as the first robot text after its connection line, and again when reopened 6 s later.
- [ ] 5.2 Flash the bridge (`mise run upload-bridge`), noting the identity at build time. Open `mise run monitor-bridge` before resetting the bridge; verify that the console shows `spooder bridge: build <id>` with that identity (after the same rules), that the first start-up log line on the screen is `Build <id>` (or `Build ..` and its end when longer than 22 characters), and that after a restart into setup mode the console shows the build line before `spooder bridge: setup mode (Bluetooth off)`.
