blackfyre/spooder/hardware/spooder-electronics-mount/images/print/bumper.png

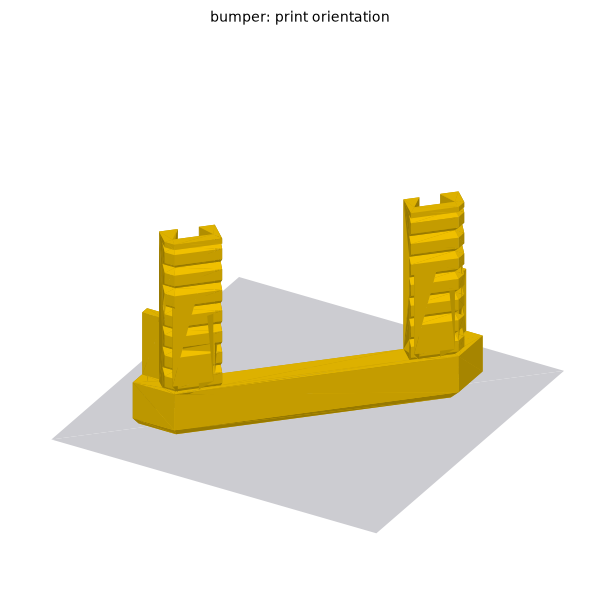
hardware/spooder-electronics-mount/images/print/bumper.png
