blackfyre/spooder/hardware/spooder-electronics-mount/images/print/cover.png

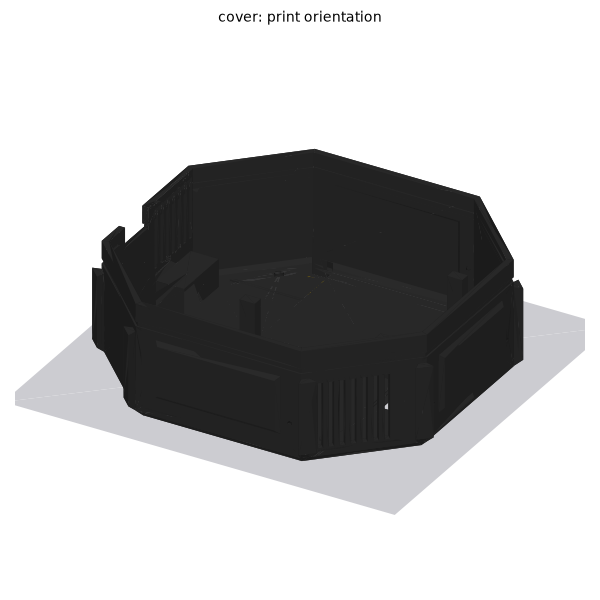
hardware/spooder-electronics-mount/images/print/cover.png
