blackfyre/spooder/hardware/spooder-electronics-mount/images/print/deck.png

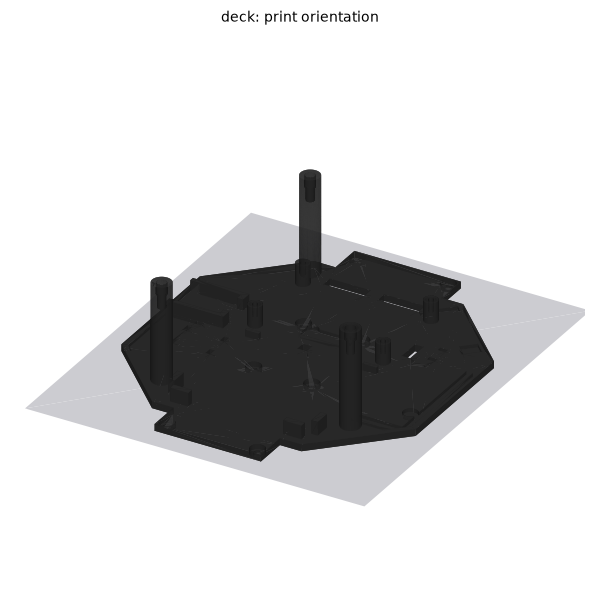
hardware/spooder-electronics-mount/images/print/deck.png
