blackfyre/spooder/hardware/spooder-electronics-mount/images/print/exhaust-fan-holder-left.png

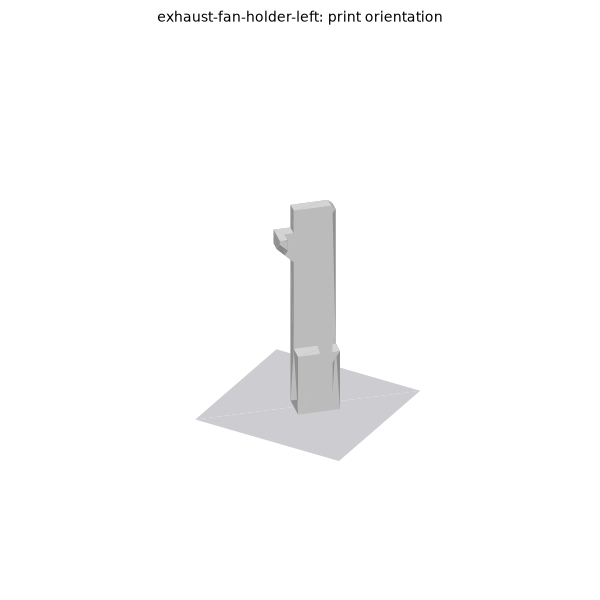
hardware/spooder-electronics-mount/images/print/exhaust-fan-holder-left.png
