blackfyre/spooder/hardware/spooder-electronics-mount/images/print/imu-pad.png

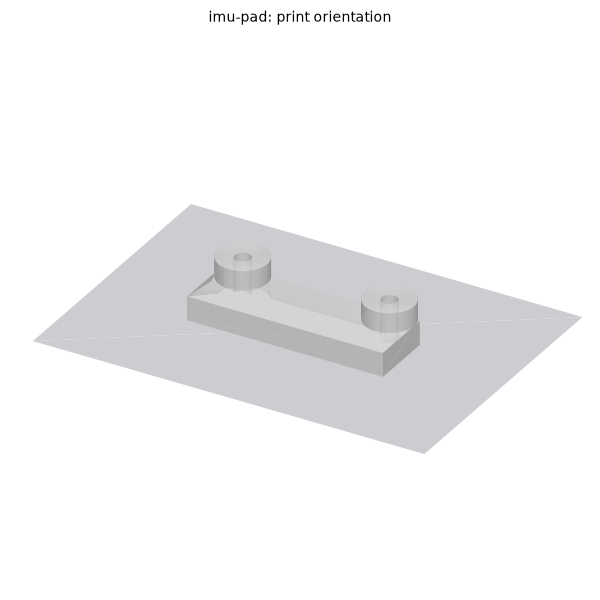
hardware/spooder-electronics-mount/images/print/imu-pad.png
