blackfyre/spooder/hardware/spooder-electronics-mount/images/print/intake-fan-holder.png

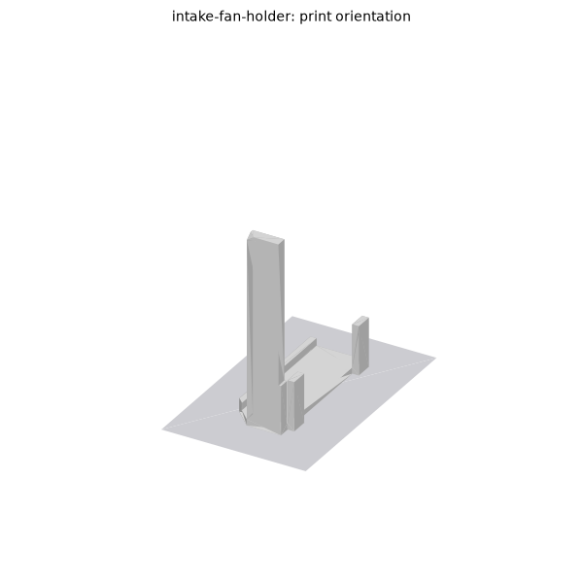
hardware/spooder-electronics-mount/images/print/intake-fan-holder.png
