blackfyre/spooder/hardware/spooder-electronics-mount/images/print/lm2596-standoff.png

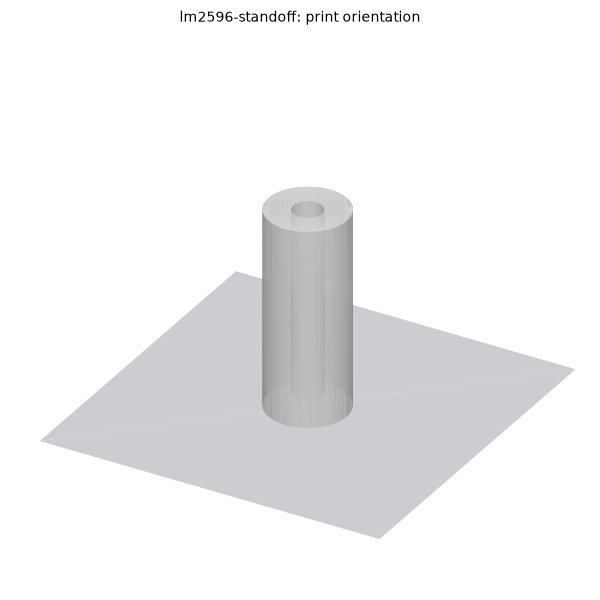
hardware/spooder-electronics-mount/images/print/lm2596-standoff.png
