blackfyre/spooder/hardware/spooder-electronics-mount/images/print/spacer.png

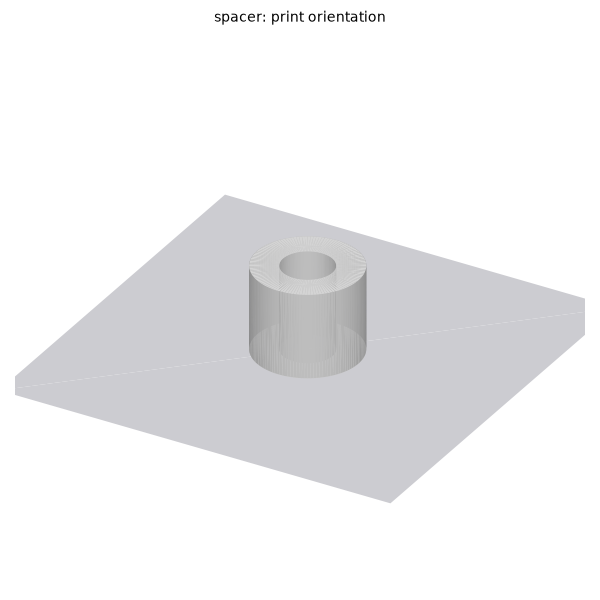
hardware/spooder-electronics-mount/images/print/spacer.png
