blackfyre/spooder/test/golden/gamepad_mapping.txt

# Spooder gamepad mapping: golden steps.
# Written by hand (add-handheld-controller, design D2), never generated.
# test/test_gamepad_mapping_golden runs core/gamepad_mapping over it, and
# desktop/handheld/internal/padmap its Go port, so the two stay in step.
# A mismatch is fixed in the code, not by editing an expected value to match.
#
# "reset <name>" starts a sequence with a fresh Mapper. Each step line is one
# pad sample and the desired state update() returns for it, fields separated
# by single spaces:
#   <t_ms> <connected> <axisX> <axisY> <axisRX> <axisRY> <buttons> <dpad> <misc>
#     = <mode> <translateX> <translateY> <rotate> <height> <speed> <gait>
#       <stride> <stickMode> <controllerConnected> <clearCounter>
#       <modeRequestCounter> <gesture> <gestureRequestCounter>
# (on one line). Axes are Bluepad32 units (Y negative for up). Buttons are
# '+'-joined names from A B X Y L1 R1 L2 R2 THUMB_L THUMB_R, the D-pad from
# UP DOWN RIGHT LEFT, misc from HOME BACK; '-' is none. Connected is 0 or 1.
# Mode is Stand, Walk, Sleep or Calibrate; stride Dynamic or Fixed; stick
# mode Steer or Crab; gesture the protocol GESTURE_* id.
# Lines starting with # are comments.

# Stand and Walk on Home, once per press; Sleep on Y returns to the mode
# requested before it; Home while sleeping changes only that mode.
reset modes
1000 1 0 0 0 0 - - - = Stand 0 0 0 0 44 1 Dynamic Steer 1 0 0 0 0
1020 1 0 0 0 0 - - HOME = Walk 0 0 0 0 44 1 Dynamic Steer 1 0 1 0 0
1040 1 0 0 0 0 - - HOME = Walk 0 0 0 0 44 1 Dynamic Steer 1 0 1 0 0
1060 1 0 0 0 0 - - - = Walk 0 0 0 0 44 1 Dynamic Steer 1 0 1 0 0
1080 1 0 0 0 0 - - HOME = Stand 0 0 0 0 44 1 Dynamic Steer 1 0 2 0 0
1100 1 0 0 0 0 - - - = Stand 0 0 0 0 44 1 Dynamic Steer 1 0 2 0 0
1120 1 0 0 0 0 - - HOME = Walk 0 0 0 0 44 1 Dynamic Steer 1 0 3 0 0
1140 1 0 0 0 0 - - - = Walk 0 0 0 0 44 1 Dynamic Steer 1 0 3 0 0
1160 1 0 0 0 0 Y - - = Sleep 0 0 0 0 44 1 Dynamic Steer 1 0 4 0 0
1180 1 0 0 0 0 Y - - = Sleep 0 0 0 0 44 1 Dynamic Steer 1 0 4 0 0
1200 1 0 0 0 0 - - - = Sleep 0 0 0 0 44 1 Dynamic Steer 1 0 4 0 0
1220 1 0 0 0 0 Y - - = Walk 0 0 0 0 44 1 Dynamic Steer 1 0 5 0 0
1240 1 0 0 0 0 - - - = Walk 0 0 0 0 44 1 Dynamic Steer 1 0 5 0 0
1260 1 0 0 0 0 Y - - = Sleep 0 0 0 0 44 1 Dynamic Steer 1 0 6 0 0
1280 1 0 0 0 0 - - - = Sleep 0 0 0 0 44 1 Dynamic Steer 1 0 6 0 0
1300 1 0 0 0 0 - - HOME = Sleep 0 0 0 0 44 1 Dynamic Steer 1 0 7 0 0
1320 1 0 0 0 0 - - - = Sleep 0 0 0 0 44 1 Dynamic Steer 1 0 7 0 0
1340 1 0 0 0 0 Y - - = Stand 0 0 0 0 44 1 Dynamic Steer 1 0 8 0 0
1360 1 0 0 0 0 - - - = Stand 0 0 0 0 44 1 Dynamic Steer 1 0 8 0 0

# Calibrate needs Back + Home held 1 s: released after 0.5 s it does not
# toggle; held on it toggles once. Y from Calibrate sleeps, leaving Sleep
# returns to Stand; Home leaves Calibrate for Stand.
reset calibrate_combo
1000 1 0 0 0 0 - - - = Stand 0 0 0 0 44 1 Dynamic Steer 1 0 0 0 0
1020 1 0 0 0 0 - - HOME+BACK = Stand 0 0 0 0 44 1 Dynamic Steer 1 0 0 0 0
1520 1 0 0 0 0 - - HOME+BACK = Stand 0 0 0 0 44 1 Dynamic Steer 1 0 0 0 0
1540 1 0 0 0 0 - - - = Stand 0 0 0 0 44 1 Dynamic Steer 1 0 0 0 0
1560 1 0 0 0 0 - - HOME+BACK = Stand 0 0 0 0 44 1 Dynamic Steer 1 0 0 0 0
2540 1 0 0 0 0 - - HOME+BACK = Stand 0 0 0 0 44 1 Dynamic Steer 1 0 0 0 0
2560 1 0 0 0 0 - - HOME+BACK = Calibrate 0 0 0 0 44 1 Dynamic Steer 1 0 1 0 0
2580 1 0 0 0 0 - - HOME+BACK = Calibrate 0 0 0 0 44 1 Dynamic Steer 1 0 1 0 0
3580 1 0 0 0 0 - - HOME+BACK = Calibrate 0 0 0 0 44 1 Dynamic Steer 1 0 1 0 0
3600 1 0 0 0 0 - - - = Calibrate 0 0 0 0 44 1 Dynamic Steer 1 0 1 0 0
3620 1 0 0 0 0 Y - - = Sleep 0 0 0 0 44 1 Dynamic Steer 1 0 2 0 0
3640 1 0 0 0 0 - - - = Sleep 0 0 0 0 44 1 Dynamic Steer 1 0 2 0 0
3660 1 0 0 0 0 Y - - = Stand 0 0 0 0 44 1 Dynamic Steer 1 0 3 0 0
3680 1 0 0 0 0 - - - = Stand 0 0 0 0 44 1 Dynamic Steer 1 0 3 0 0
3700 1 0 0 0 0 - - HOME+BACK = Stand 0 0 0 0 44 1 Dynamic Steer 1 0 3 0 0
4700 1 0 0 0 0 - - HOME+BACK = Calibrate 0 0 0 0 44 1 Dynamic Steer 1 0 4 0 0
4720 1 0 0 0 0 - - - = Calibrate 0 0 0 0 44 1 Dynamic Steer 1 0 4 0 0
4740 1 0 0 0 0 - - HOME = Stand 0 0 0 0 44 1 Dynamic Steer 1 0 5 0 0
4760 1 0 0 0 0 - - - = Stand 0 0 0 0 44 1 Dynamic Steer 1 0 5 0 0

# Fault clear needs both thumbs held 1 s, once per hold; 0.5 s does nothing,
# nor does one thumb.
reset clear_combo
1000 1 0 0 0 0 - - - = Stand 0 0 0 0 44 1 Dynamic Steer 1 0 0 0 0
1020 1 0 0 0 0 THUMB_L+THUMB_R - - = Stand 0 0 0 0 44 1 Dynamic Steer 1 0 0 0 0
1520 1 0 0 0 0 THUMB_L+THUMB_R - - = Stand 0 0 0 0 44 1 Dynamic Steer 1 0 0 0 0
1540 1 0 0 0 0 - - - = Stand 0 0 0 0 44 1 Dynamic Steer 1 0 0 0 0
1560 1 0 0 0 0 THUMB_L+THUMB_R - - = Stand 0 0 0 0 44 1 Dynamic Steer 1 0 0 0 0
2540 1 0 0 0 0 THUMB_L+THUMB_R - - = Stand 0 0 0 0 44 1 Dynamic Steer 1 0 0 0 0
2560 1 0 0 0 0 THUMB_L+THUMB_R - - = Stand 0 0 0 0 44 1 Dynamic Steer 1 1 0 0 0
2580 1 0 0 0 0 THUMB_L+THUMB_R - - = Stand 0 0 0 0 44 1 Dynamic Steer 1 1 0 0 0
3580 1 0 0 0 0 THUMB_L+THUMB_R - - = Stand 0 0 0 0 44 1 Dynamic Steer 1 1 0 0 0
3600 1 0 0 0 0 - - - = Stand 0 0 0 0 44 1 Dynamic Steer 1 1 0 0 0
3620 1 0 0 0 0 THUMB_L - - = Stand 0 0 0 0 44 1 Dynamic Steer 1 1 0 0 0
4620 1 0 0 0 0 THUMB_L - - = Stand 0 0 0 0 44 1 Dynamic Steer 1 1 0 0 0
4640 1 0 0 0 0 - - - = Stand 0 0 0 0 44 1 Dynamic Steer 1 1 0 0 0

# Dials step once per press within 0..100; gait wraps both ways; X toggles
# the stride mode and B the stick mode.
reset dials_and_gait
1000 1 0 0 0 0 - - - = Stand 0 0 0 0 44 1 Dynamic Steer 1 0 0 0 0
1020 1 0 0 0 0 - DOWN - = Stand 0 0 0 0 44 1 Dynamic Steer 1 0 0 0 0
1040 1 0 0 0 0 - - - = Stand 0 0 0 0 44 1 Dynamic Steer 1 0 0 0 0
1060 1 0 0 0 0 - UP - = Stand 0 0 0 10 44 1 Dynamic Steer 1 0 0 0 0
1080 1 0 0 0 0 - UP - = Stand 0 0 0 10 44 1 Dynamic Steer 1 0 0 0 0
1100 1 0 0 0 0 - - - = Stand 0 0 0 10 44 1 Dynamic Steer 1 0 0 0 0
1120 1 0 0 0 0 - UP - = Stand 0 0 0 20 44 1 Dynamic Steer 1 0 0 0 0
1140 1 0 0 0 0 - - - = Stand 0 0 0 20 44 1 Dynamic Steer 1 0 0 0 0
1160 1 0 0 0 0 - DOWN - = Stand 0 0 0 10 44 1 Dynamic Steer 1 0 0 0 0
1180 1 0 0 0 0 - - - = Stand 0 0 0 10 44 1 Dynamic Steer 1 0 0 0 0
1200 1 0 0 0 0 - RIGHT - = Stand 0 0 0 10 54 1 Dynamic Steer 1 0 0 0 0
1220 1 0 0 0 0 - - - = Stand 0 0 0 10 54 1 Dynamic Steer 1 0 0 0 0
1240 1 0 0 0 0 - RIGHT - = Stand 0 0 0 10 64 1 Dynamic Steer 1 0 0 0 0
1260 1 0 0 0 0 - - - = Stand 0 0 0 10 64 1 Dynamic Steer 1 0 0 0 0
1280 1 0 0 0 0 - RIGHT - = Stand 0 0 0 10 74 1 Dynamic Steer 1 0 0 0 0
1300 1 0 0 0 0 - - - = Stand 0 0 0 10 74 1 Dynamic Steer 1 0 0 0 0
1320 1 0 0 0 0 - RIGHT - = Stand 0 0 0 10 84 1 Dynamic Steer 1 0 0 0 0
1340 1 0 0 0 0 - - - = Stand 0 0 0 10 84 1 Dynamic Steer 1 0 0 0 0
1360 1 0 0 0 0 - RIGHT - = Stand 0 0 0 10 94 1 Dynamic Steer 1 0 0 0 0
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
1300 0 0 -512 0 0 - - - = Sleep 0 0 0 10 54 2 Fixed Crab 0 0 1 0 0
1320 1 0 -512 0 0 Y - - = Stand 0 100 0 10 54 2 Fixed Crab 1 0 1 0 0
1340 1 0 -512 0 0 Y - - = Stand 0 100 0 10 54 2 Fixed Crab 1 0 1 0 0
1360 1 0 0 0 0 - - - = Stand 0 0 0 10 54 2 Fixed Crab 1 0 1 0 0
1380 1 0 0 0 0 Y - - = Sleep 0 0 0 10 54 2 Fixed Crab 1 0 2 0 0
1400 1 0 0 0 0 - - - = Sleep 0 0 0 10 54 2 Fixed Crab 1 0 2 0 0
