blackfyre/spooder/test/golden/protocol_v3.txt

# Spooder link protocol version 3: golden frames.
# Generated from the C++ encoder by test/test_protocol_golden; regenerate with
# SPOODER_WRITE_GOLDEN=1 mise run test after a deliberate protocol change.
#
# One frame per line, fields separated by single spaces:
#   <name> <frame bytes as lowercase hex, no separators> <field>=<value> ...
# Values are decimal. The header fields (version, type, seq) come first, then
# the payload fields in payload order; report joints are joint<i>.<field>.
# A line whose only field is "rejected" is a frame a decoder must discard.
# Lines starting with # are comments.
command_walk a50301000e02003200322c00000100000000009029 version=3 type=command seq=0 mode=2 translateX=0 translateY=50 rotate=0 height=50 speed=44 gait=0 stride=0 flags=1 clearCounter=0 modeRequestCounter=0 gesture=0 gestureRequestCounter=0
command_extremes_seq_wrap a50301ff0e04807f9cff640501ffffffffff007ebc version=3 type=command seq=255 mode=4 translateX=-128 translateY=127 rotate=-100 height=255 speed=100 gait=5 stride=1 flags=255 clearCounter=255 modeRequestCounter=255 gesture=255 gestureRequestCounter=255
command_stand_gesture_wiggle a50301110e000000001e2c00000100040209001ccb version=3 type=command seq=17 mode=0 translateX=0 translateY=0 rotate=0 height=30 speed=44 gait=0 stride=0 flags=1 clearCounter=0 modeRequestCounter=4 gesture=2 gestureRequestCounter=9
command_estop_no_controller a50301000e0300000000000000020100000000a708 version=3 type=command seq=0 mode=3 translateX=0 translateY=0 rotate=0 height=0 speed=0 gait=0 stride=0 flags=2 clearCounter=1 modeRequestCounter=0 gesture=0 gestureRequestCounter=0
telemetry_calibrate_usb a50302072004000100007c174605e803020000000000000000000200000000000000000000ecb4 version=3 type=telemetry seq=7 bodyMode=4 gait=0 outputsOn=1 faults=0 voltageMv=6012 currentMa=1350 validFrames=1000 discardedFrames=2 sensorsAvailable=0 tofMm=0 tofStatus=0 pitchCentideg=0 rollCentideg=0 flags=2 gesture=0 bridgeValidFrames=0 bridgeDiscardedFrames=0
telemetry_conflict a50302802003000020000000000000000000000000000000000001000000000000000000003aea version=3 type=telemetry seq=128 bodyMode=3 gait=0 outputsOn=0 faults=32 voltageMv=0 currentMa=0 validFrames=0 discardedFrames=0 sensorsAvailable=0 tofMm=0 tofStatus=0 pitchCentideg=0 rollCentideg=0 flags=1 gesture=0 bridgeValidFrames=0 bridgeDiscardedFrames=0
telemetry_extremes a50302ff20ffff01ffffffffffffffffffffffffffff0080ff7fffffffffffff0000000000395b version=3 type=telemetry seq=255 bodyMode=255 gait=255 outputsOn=1 faults=65535 voltageMv=65535 currentMa=65535 validFrames=65535 discardedFrames=65535 sensorsAvailable=255 tofMm=65535 tofStatus=255 pitchCentideg=-32768 rollCentideg=32767 flags=255 gesture=255 bridgeValidFrames=65535 bridgeDiscardedFrames=65535
telemetry_perform_say_hi a503021e200500010000a217340800000000000000000000000004010000000000000000009838 version=3 type=telemetry seq=30 bodyMode=5 gait=0 outputsOn=1 faults=0 voltageMv=6050 currentMa=2100 validFrames=0 discardedFrames=0 sensorsAvailable=0 tofMm=0 tofStatus=0 pitchCentideg=0 rollCentideg=0 flags=4 gesture=1 bridgeValidFrames=0 bridgeDiscardedFrames=0
telemetry_usb_bridge_link_up a503021f200100010000ac170000a401000000000000000000000a00470c02000000000000d53e version=3 type=telemetry seq=31 bodyMode=1 gait=0 outputsOn=1 faults=0 voltageMv=6060 currentMa=0 validFrames=420 discardedFrames=0 sensorsAvailable=0 tofMm=0 tofStatus=0 pitchCentideg=0 rollCentideg=0 flags=10 gesture=0 bridgeValidFrames=3143 bridgeDiscardedFrames=2
telemetry_bench_simulation a5030228200201014000701770082c03030000000000000000002000b70401000000000000ce88 version=3 type=telemetry seq=40 bodyMode=2 gait=1 outputsOn=1 faults=64 voltageMv=6000 currentMa=2160 validFrames=812 discardedFrames=3 sensorsAvailable=0 tofMm=0 tofStatus=0 pitchCentideg=0 rollCentideg=0 flags=32 gesture=0 bridgeValidFrames=1207 bridgeDiscardedFrames=1
calibration_set_default_joint0 a50303010901002823f401c40900aa72 version=3 type=calibration_set seq=1 requestId=1 joint=0 offsetCentideg=9000 pulse0Us=500 pulse180Us=2500 flags=0
calibration_set_reversed_joint17 a503032a09c8116ef66009580201c42a version=3 type=calibration_set seq=42 requestId=200 joint=17 offsetCentideg=-2450 pulse0Us=2400 pulse180Us=600 flags=1
calibration_set_extremes a50303ff09ffff00800000ffffff0d60 version=3 type=calibration_set seq=255 requestId=255 joint=255 offsetCentideg=-32768 pulse0Us=0 pulse180Us=65535 flags=255
calibration_report_defaults a50304008000032823f401c409004c1df401c40900f8f8f401c409005424f401c409004c1df401c4090024faf401c409005424f401c409004c1df401c40900f8f8f401c40900fc21f401c40900401ff401c40900d8f5f401c409003421f401c40900c422f401c40900c0f9f401c409005424f401c409003421f401c40900a0f6f401c4090005c3 version=3 type=calibration_report seq=0 lastRequestId=0 result=3 joint0.offsetCentideg=9000 joint0.pulse0Us=500 joint0.pulse180Us=2500 joint0.flags=0 joint1.offsetCentideg=7500 joint1.pulse0Us=500 joint1.pulse180Us=2500 joint1.flags=0 joint2.offsetCentideg=-1800 joint2.pulse0Us=500 joint2.pulse180Us=2500 joint2.flags=0 joint3.offsetCentideg=9300 joint3.pulse0Us=500 joint3.pulse180Us=2500 joint3.flags=0 joint4.offsetCentideg=7500 joint4.pulse0Us=500 joint4.pulse180Us=2500 joint4.flags=0 joint5.offsetCentideg=-1500 joint5.pulse0Us=500 joint5.pulse180Us=2500 joint5.flags=0 joint6.offsetCentideg=9300 joint6.pulse0Us=500 joint6.pulse180Us=2500 joint6.flags=0 joint7.offsetCentideg=7500 joint7.pulse0Us=500 joint7.pulse180Us=2500 joint7.flags=0 joint8.offsetCentideg=-1800 joint8.pulse0Us=500 joint8.pulse180Us=2500 joint8.flags=0 joint9.offsetCentideg=8700 joint9.pulse0Us=500 joint9.pulse180Us=2500 joint9.flags=0 joint10.offsetCentideg=8000 joint10.pulse0Us=500 joint10.pulse180Us=2500 joint10.flags=0 joint11.offsetCentideg=-2600 joint11.pulse0Us=500 joint11.pulse180Us=2500 joint11.flags=0 joint12.offsetCentideg=8500 joint12.pulse0Us=500 joint12.pulse180Us=2500 joint12.flags=0 joint13.offsetCentideg=8900 joint13.pulse0Us=500 joint13.pulse180Us=2500 joint13.flags=0 joint14.offsetCentideg=-1600 joint14.pulse0Us=500 joint14.pulse180Us=2500 joint14.flags=0 joint15.offsetCentideg=9300 joint15.pulse0Us=500 joint15.pulse180Us=2500 joint15.flags=0 joint16.offsetCentideg=8500 joint16.pulse0Us=500 joint16.pulse180Us=2500 joint16.flags=0 joint17.offsetCentideg=-2400 joint17.pulse0Us=500 joint17.pulse180Us=2500 joint17.flags=0
calibration_report_clamped a50304098011012823f401c409000429f401c40900f8f8f401c409005424f401c40900521c920962020124faf401c409005424f401c409004c1df401c40900f8f8f401c40900fc21f401c40900401ff401c40900d8f5f401c409003421f401c40900c422f401c40900c0f9f401c409005424f401c409003421f401c40900a0f6f401c4090068fd version=3 type=calibration_report seq=9 lastRequestId=17 result=1 joint0.offsetCentideg=9000 joint0.pulse0Us=500 joint0.pulse180Us=2500 joint0.flags=0 joint1.offsetCentideg=10500 joint1.pulse0Us=500 joint1.pulse180Us=2500 joint1.flags=0 joint2.offsetCentideg=-1800 joint2.pulse0Us=500 joint2.pulse180Us=2500 joint2.flags=0 joint3.offsetCentideg=9300 joint3.pulse0Us=500 joint3.pulse180Us=2500 joint3.flags=0 joint4.offsetCentideg=7250 joint4.pulse0Us=2450 joint4.pulse180Us=610 joint4.flags=1 joint5.offsetCentideg=-1500 joint5.pulse0Us=500 joint5.pulse180Us=2500 joint5.flags=0 joint6.offsetCentideg=9300 joint6.pulse0Us=500 joint6.pulse180Us=2500 joint6.flags=0 joint7.offsetCentideg=7500 joint7.pulse0Us=500 joint7.pulse180Us=2500 joint7.flags=0 joint8.offsetCentideg=-1800 joint8.pulse0Us=500 joint8.pulse180Us=2500 joint8.flags=0 joint9.offsetCentideg=8700 joint9.pulse0Us=500 joint9.pulse180Us=2500 joint9.flags=0 joint10.offsetCentideg=8000 joint10.pulse0Us=500 joint10.pulse180Us=2500 joint10.flags=0 joint11.offsetCentideg=-2600 joint11.pulse0Us=500 joint11.pulse180Us=2500 joint11.flags=0 joint12.offsetCentideg=8500 joint12.pulse0Us=500 joint12.pulse180Us=2500 joint12.flags=0 joint13.offsetCentideg=8900 joint13.pulse0Us=500 joint13.pulse180Us=2500 joint13.flags=0 joint14.offsetCentideg=-1600 joint14.pulse0Us=500 joint14.pulse180Us=2500 joint14.flags=0 joint15.offsetCentideg=9300 joint15.pulse0Us=500 joint15.pulse180Us=2500 joint15.flags=0 joint16.offsetCentideg=8500 joint16.pulse0Us=500 joint16.pulse180Us=2500 joint16.flags=0 joint17.offsetCentideg=-2400 joint17.pulse0Us=500 joint17.pulse180Us=2500 joint17.flags=0
calibration_report_rejected_seq_wrap a50304008012022823f401c409000429f401c40900f8f8f401c409005424f401c40900521c920962020124faf401c409005424f401c409004c1df401c40900f8f8f401c40900fc21f401c40900401ff401c40900d8f5f401c409003421f401c40900c422f401c40900c0f9f401c409005424f401c409003421f401c40900a0f6f401c409002290 version=3 type=calibration_report seq=0 lastRequestId=18 result=2 joint0.offsetCentideg=9000 joint0.pulse0Us=500 joint0.pulse180Us=2500 joint0.flags=0 joint1.offsetCentideg=10500 joint1.pulse0Us=500 joint1.pulse180Us=2500 joint1.flags=0 joint2.offsetCentideg=-1800 joint2.pulse0Us=500 joint2.pulse180Us=2500 joint2.flags=0 joint3.offsetCentideg=9300 joint3.pulse0Us=500 joint3.pulse180Us=2500 joint3.flags=0 joint4.offsetCentideg=7250 joint4.pulse0Us=2450 joint4.pulse180Us=610 joint4.flags=1 joint5.offsetCentideg=-1500 joint5.pulse0Us=500 joint5.pulse180Us=2500 joint5.flags=0 joint6.offsetCentideg=9300 joint6.pulse0Us=500 joint6.pulse180Us=2500 joint6.flags=0 joint7.offsetCentideg=7500 joint7.pulse0Us=500 joint7.pulse180Us=2500 joint7.flags=0 joint8.offsetCentideg=-1800 joint8.pulse0Us=500 joint8.pulse180Us=2500 joint8.flags=0 joint9.offsetCentideg=8700 joint9.pulse0Us=500 joint9.pulse180Us=2500 joint9.flags=0 joint10.offsetCentideg=8000 joint10.pulse0Us=500 joint10.pulse180Us=2500 joint10.flags=0 joint11.offsetCentideg=-2600 joint11.pulse0Us=500 joint11.pulse180Us=2500 joint11.flags=0 joint12.offsetCentideg=8500 joint12.pulse0Us=500 joint12.pulse180Us=2500 joint12.flags=0 joint13.offsetCentideg=8900 joint13.pulse0Us=500 joint13.pulse180Us=2500 joint13.flags=0 joint14.offsetCentideg=-1600 joint14.pulse0Us=500 joint14.pulse180Us=2500 joint14.flags=0 joint15.offsetCentideg=9300 joint15.pulse0Us=500 joint15.pulse180Us=2500 joint15.flags=0 joint16.offsetCentideg=8500 joint16.pulse0Us=500 joint16.pulse180Us=2500 joint16.flags=0 joint17.offsetCentideg=-2400 joint17.pulse0Us=500 joint17.pulse180Us=2500 joint17.flags=0
calibration_report_extremes a50304ff80ffffff7f0000ffffff00800000ffffffff7f0000ffffff00800000ffffffff7f0000ffffff00800000ffffffff7f0000ffffff00800000ffffffff7f0000ffffff00800000ffffffff7f0000ffffff00800000ffffffff7f0000ffffff00800000ffffffff7f0000ffffff00800000ffffffff7f0000ffffff00800000ffffff3d25 version=3 type=calibration_report seq=255 lastRequestId=255 result=255 joint0.offsetCentideg=32767 joint0.pulse0Us=0 joint0.pulse180Us=65535 joint0.flags=255 joint1.offsetCentideg=-32768 joint1.pulse0Us=0 joint1.pulse180Us=65535 joint1.flags=255 joint2.offsetCentideg=32767 joint2.pulse0Us=0 joint2.pulse180Us=65535 joint2.flags=255 joint3.offsetCentideg=-32768 joint3.pulse0Us=0 joint3.pulse180Us=65535 joint3.flags=255 joint4.offsetCentideg=32767 joint4.pulse0Us=0 joint4.pulse180Us=65535 joint4.flags=255 joint5.offsetCentideg=-32768 joint5.pulse0Us=0 joint5.pulse180Us=65535 joint5.flags=255 joint6.offsetCentideg=32767 joint6.pulse0Us=0 joint6.pulse180Us=65535 joint6.flags=255 joint7.offsetCentideg=-32768 joint7.pulse0Us=0 joint7.pulse180Us=65535 joint7.flags=255 joint8.offsetCentideg=32767 joint8.pulse0Us=0 joint8.pulse180Us=65535 joint8.flags=255 joint9.offsetCentideg=-32768 joint9.pulse0Us=0 joint9.pulse180Us=65535 joint9.flags=255 joint10.offsetCentideg=32767 joint10.pulse0Us=0 joint10.pulse180Us=65535 joint10.flags=255 joint11.offsetCentideg=-32768 joint11.pulse0Us=0 joint11.pulse180Us=65535 joint11.flags=255 joint12.offsetCentideg=32767 joint12.pulse0Us=0 joint12.pulse180Us=65535 joint12.flags=255 joint13.offsetCentideg=-32768 joint13.pulse0Us=0 joint13.pulse180Us=65535 joint13.flags=255 joint14.offsetCentideg=32767 joint14.pulse0Us=0 joint14.pulse180Us=65535 joint14.flags=255 joint15.offsetCentideg=-32768 joint15.pulse0Us=0 joint15.pulse180Us=65535 joint15.flags=255 joint16.offsetCentideg=32767 joint16.pulse0Us=0 joint16.pulse180Us=65535 joint16.flags=255 joint17.offsetCentideg=-32768 joint17.pulse0Us=0 joint17.pulse180Us=65535 joint17.flags=255
reject_version_2_command a50201030c0100000000000000010000000a72 rejected
reject_bad_crc_calibration_set a50303040905036400f401c4090051da rejected
pose_calibration_outputs_on a50305036e010000002823dc05282374401d092823201c140500005424fd05282374401d0928234c1d350500005424fd05282374401d092823201c14050000fc21bb0528236842550928230019bb0400003421a4052823ec45b9092823e81c2a0500005424fd0528235c448c092823c819d104957e version=3 type=pose seq=3 flags=1 joint0.commandedCentideg=0 joint0.servoCentideg=9000 joint0.pulseUs=1500 joint1.commandedCentideg=9000 joint1.servoCentideg=16500 joint1.pulseUs=2333 joint2.commandedCentideg=9000 joint2.servoCentideg=7200 joint2.pulseUs=1300 joint3.commandedCentideg=0 joint3.servoCentideg=9300 joint3.pulseUs=1533 joint4.commandedCentideg=9000 joint4.servoCentideg=16500 joint4.pulseUs=2333 joint5.commandedCentideg=9000 joint5.servoCentideg=7500 joint5.pulseUs=1333 joint6.commandedCentideg=0 joint6.servoCentideg=9300 joint6.pulseUs=1533 joint7.commandedCentideg=9000 joint7.servoCentideg=16500 joint7.pulseUs=2333 joint8.commandedCentideg=9000 joint8.servoCentideg=7200 joint8.pulseUs=1300 joint9.commandedCentideg=0 joint9.servoCentideg=8700 joint9.pulseUs=1467 joint10.commandedCentideg=9000 joint10.servoCentideg=17000 joint10.pulseUs=2389 joint11.commandedCentideg=9000 joint11.servoCentideg=6400 joint11.pulseUs=1211 joint12.commandedCentideg=0 joint12.servoCentideg=8500 joint12.pulseUs=1444 joint13.commandedCentideg=9000 joint13.servoCentideg=17900 joint13.pulseUs=2489 joint14.commandedCentideg=9000 joint14.servoCentideg=7400 joint14.pulseUs=1322 joint15.commandedCentideg=0 joint15.servoCentideg=9300 joint15.pulseUs=1533 joint16.commandedCentideg=9000 joint16.servoCentideg=17500 joint16.pulseUs=2444 joint17.commandedCentideg=9000 joint17.servoCentideg=6600 joint17.pulseUs=1233
pose_output_off_legs_unset a50305c86e00002efbceffdc052dfbd1ffdd052cfbd4ffde052bfbd7ffdf052afbdaffe00529fbddffe10528fbe0ffe20527fbe3ffe30526fbe6ffe40525fbe9ffe50524fbecffe60523fbefffe705000000000000000000000000000000000000000000000000000000000000000000000000151a version=3 type=pose seq=200 flags=0 joint0.commandedCentideg=-1234 joint0.servoCentideg=-50 joint0.pulseUs=1500 joint1.commandedCentideg=-1235 joint1.servoCentideg=-47 joint1.pulseUs=1501 joint2.commandedCentideg=-1236 joint2.servoCentideg=-44 joint2.pulseUs=1502 joint3.commandedCentideg=-1237 joint3.servoCentideg=-41 joint3.pulseUs=1503 joint4.commandedCentideg=-1238 joint4.servoCentideg=-38 joint4.pulseUs=1504 joint5.commandedCentideg=-1239 joint5.servoCentideg=-35 joint5.pulseUs=1505 joint6.commandedCentideg=-1240 joint6.servoCentideg=-32 joint6.pulseUs=1506 joint7.commandedCentideg=-1241 joint7.servoCentideg=-29 joint7.pulseUs=1507 joint8.commandedCentideg=-1242 joint8.servoCentideg=-26 joint8.pulseUs=1508 joint9.commandedCentideg=-1243 joint9.servoCentideg=-23 joint9.pulseUs=1509 joint10.commandedCentideg=-1244 joint10.servoCentideg=-20 joint10.pulseUs=1510 joint11.commandedCentideg=-1245 joint11.servoCentideg=-17 joint11.pulseUs=1511 joint12.commandedCentideg=0 joint12.servoCentideg=0 joint12.pulseUs=0 joint13.commandedCentideg=0 joint13.servoCentideg=0 joint13.pulseUs=0 joint14.commandedCentideg=0 joint14.servoCentideg=0 joint14.pulseUs=0 joint15.commandedCentideg=0 joint15.servoCentideg=0 joint15.pulseUs=0 joint16.commandedCentideg=0 joint16.servoCentideg=0 joint16.pulseUs=0 joint17.commandedCentideg=0 joint17.servoCentideg=0 joint17.pulseUs=0
pose_extremes a50305ff6eff00ff7f0080ffff0080ff7fffffff7f0080ffff0080ff7fffffff7f0080ffff0080ff7fffffff7f0080ffff0080ff7fffffff7f0080ffff0080ff7fffffff7f0080ffff0080ff7fffffff7f0080ffff0080ff7fffffff7f0080ffff0080ff7fffffff7f0080ffff0080ff7fffffc256 version=3 type=pose seq=255 flags=255 joint0.commandedCentideg=32767 joint0.servoCentideg=-32768 joint0.pulseUs=65535 joint1.commandedCentideg=-32768 joint1.servoCentideg=32767 joint1.pulseUs=65535 joint2.commandedCentideg=32767 joint2.servoCentideg=-32768 joint2.pulseUs=65535 joint3.commandedCentideg=-32768 joint3.servoCentideg=32767 joint3.pulseUs=65535 joint4.commandedCentideg=32767 joint4.servoCentideg=-32768 joint4.pulseUs=65535 joint5.commandedCentideg=-32768 joint5.servoCentideg=32767 joint5.pulseUs=65535 joint6.commandedCentideg=32767 joint6.servoCentideg=-32768 joint6.pulseUs=65535 joint7.commandedCentideg=-32768 joint7.servoCentideg=32767 joint7.pulseUs=65535 joint8.commandedCentideg=32767 joint8.servoCentideg=-32768 joint8.pulseUs=65535 joint9.commandedCentideg=-32768 joint9.servoCentideg=32767 joint9.pulseUs=65535 joint10.commandedCentideg=32767 joint10.servoCentideg=-32768 joint10.pulseUs=65535 joint11.commandedCentideg=-32768 joint11.servoCentideg=32767 joint11.pulseUs=65535 joint12.commandedCentideg=32767 joint12.servoCentideg=-32768 joint12.pulseUs=65535 joint13.commandedCentideg=-32768 joint13.servoCentideg=32767 joint13.pulseUs=65535 joint14.commandedCentideg=32767 joint14.servoCentideg=-32768 joint14.pulseUs=65535 joint15.commandedCentideg=-32768 joint15.servoCentideg=32767 joint15.pulseUs=65535 joint16.commandedCentideg=32767 joint16.servoCentideg=-32768 joint16.pulseUs=65535 joint17.commandedCentideg=-32768 joint17.servoCentideg=32767 joint17.pulseUs=65535
reject_bad_crc_pose a50305066e0000000000000000000000000000000000000000000000000000000000000000000000000000000000000000000000000000000000000000000000000000000000000000000000000000000000000000000000000000000000000000000000000000000000000000000000000000d064 rejected
diagnostics_governed_walk a5030604189c01000050195a144c09282370175014901ac0120101ad01cba6 version=3 type=diagnostics seq=4 motionSharePermille=412 backstopTicks=0 tickMaxUs=6480 tickMeanUs=5210 averageCurrentMa=2380 tripCurrentMa=9000 sustainedCurrentMa=6000 minMv=5200 maxMv=6800 brownoutMv=4800 budgetDegPerS=257 ratedDegPerS=429
diagnostics_idle_backstop_count a503066318e8032500760772060000282370175014901ac0120101ad011877 version=3 type=diagnostics seq=99 motionSharePermille=1000 backstopTicks=37 tickMaxUs=1910 tickMeanUs=1650 averageCurrentMa=0 tripCurrentMa=9000 sustainedCurrentMa=6000 minMv=5200 maxMv=6800 brownoutMv=4800 budgetDegPerS=257 ratedDegPerS=429
diagnostics_extremes a50306ff18ffffffffffffffffffffffffffffffffffffffffffffffffc003 version=3 type=diagnostics seq=255 motionSharePermille=65535 backstopTicks=65535 tickMaxUs=65535 tickMeanUs=65535 averageCurrentMa=65535 tripCurrentMa=65535 sustainedCurrentMa=65535 minMv=65535 maxMv=65535 brownoutMv=65535 budgetDegPerS=65535 ratedDegPerS=65535
reject_bad_crc_diagnostics a50306071800000000000000000000000000000000000000000000000015dc rejected
