blackfyre/spooder/docs/images/calibrator-light.png

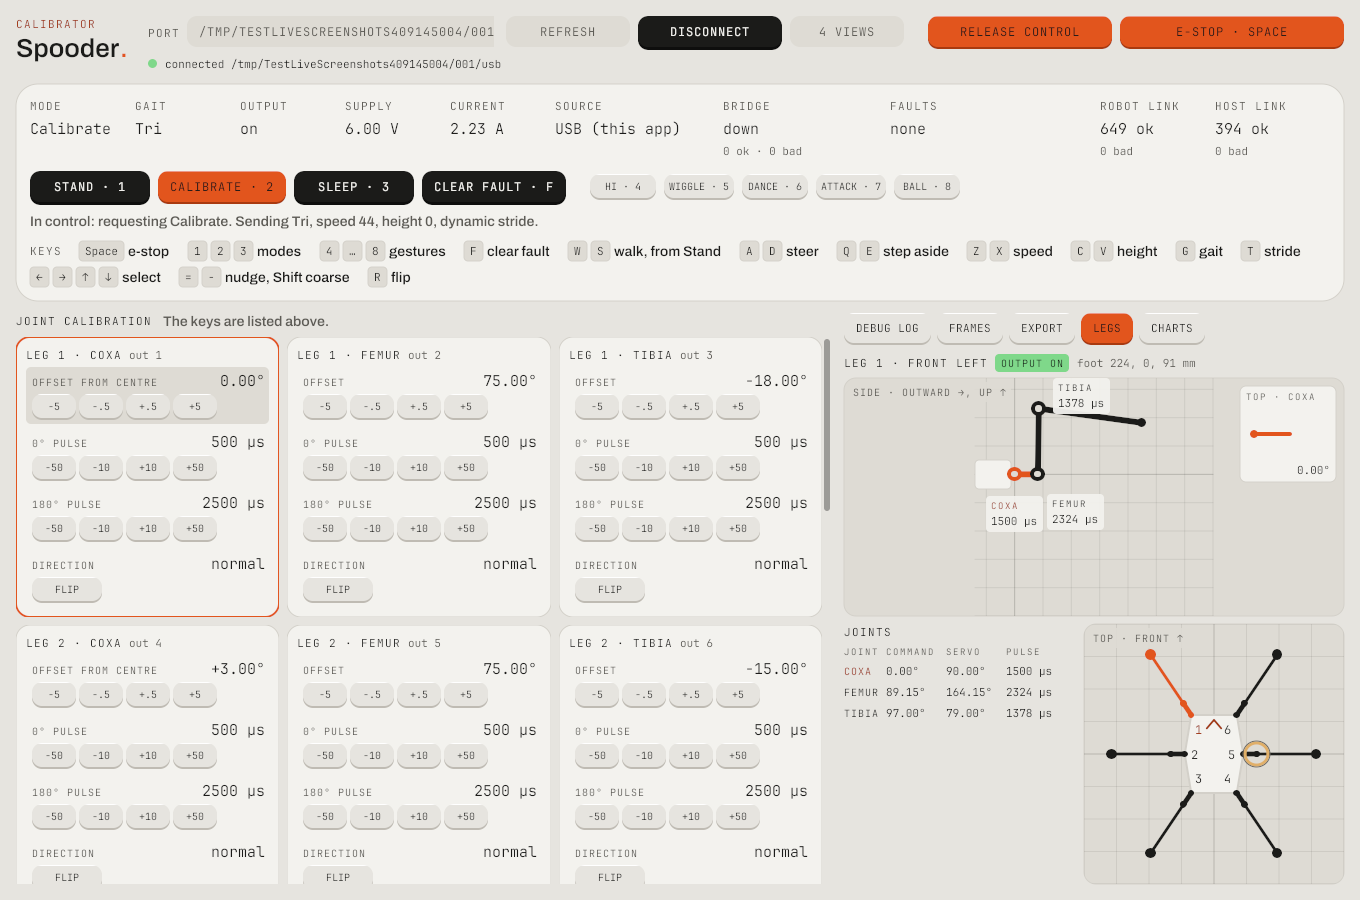
docs/images/calibrator-light.png
