blackfyre/spooder/CHANGELOG.md

# Changelog

All notable changes to Spooder are recorded here. The format follows [Keep a Changelog](https://keepachangelog.com/en/1.1.0/). The project has no releases yet; changes collect under **Unreleased**.

## [Unreleased]

### Added

- **Bill of materials and wiring docs.** `docs/bom.md` lists the electronics, power train, controllers, printed parts and hardware totals; `docs/wiring.md` gives the power and signal diagrams, the bridge link, the J6 header and the servo outputs.
- **Parametric feet.** `hardware/parametric-reference-parts/aecert-hexapod-v1/` adds Aecert's feet group: Foot Left, Foot Right, Foot Shaft and Foot Tip, each within the global gates against its STL and exported as STEP. The serpentine flexure is built from named dimensions of its path and beam widths (`parts/_feet.py`), shared by both feet; Foot Right is Foot Left's solid mirrored and moved 1.069 mm along y, as its STL is. `test_feet.py` checks the group, the retuned flexure and the feet's exceptions (none is needed).
- **Handheld network check.** The pak starts only on a network named `spooder-drive-` and four hex digits, the bridge's WiFi drive: the bridge's setup network and other networks in 192.168.4.0/24 no longer pass its address check. While it drives, it reads the network once a second with the signal level; off the network it started on it sends no command frame (the bridge's lapse sleeps the robot), its link chip reads `OFF NETWORK` and the robot panel (on the driving view, its title) names the network to rejoin. Back on it, it sends again with Sleep requested and the held controls masked, as after a suspend. Only the pak changes.
- **Front-pair attack.** The body braces over four planted feet, raises the front legs and strikes twice under the selected servo profile's joint speed budget, with an animated handheld preview. Host tests check travel and world-frame support at both height extremes.
- **Dance gesture.** An eight-beat routine at 120 BPM rolls, nods, twists and bounces over planted feet, then taps a front foot and straightens; the handheld preview follows the same script.

- **Gesture body poses.** The player keeps planted feet fixed through eased yaw, pitch and roll, with path-based foot speed limits and per-keyframe speed overrides.
- **Ball.** The body comes down until its underside is 3 mm above the ground, rests on its frame as the feet lift 8 mm off the ground, draws its feet 18 mm in towards the body (6 mm short of the first fold that leaves a femur's travel with the default calibration, 24 mm) and holds in Perform; any other request but Sleep first unfolds it (feet out, down, then the body up into Stand), and Sleep and safety interruptions still pre-empt at once (Sleep from the ball lifts the body 21.8 mm onto its feet at the rest pose, where every Sleep ends, before output stops). Its heights follow the underside (`body_geometry::UNDERSIDE_Z`) and the standing height, so it is right at every body height. The gesture support test now knows where the floor is: a pose with a foot or the underside through the floor, or with the underside off the floor and fewer than three feet on it, fails, as the provisional ball did. The handheld's gesture overlay animates all five gestures.

- **Handheld sound feedback.** The pak plays short generated tones (about -12 dBFS, through SDL's core audio: no new dependency) for a fault latched, the e-stop set and released, the link lost and regained, a gesture refused or accepted, and a leave; each at most once a second, safety tones before confirmations. `Select` + `B` switches the sound off and on (a `SOUND OFF` header chip while off), kept for the next run as the file `sound-off` in the pak's folder. Only the pak changes.
- **Bridge screen pages.** The bridge's status screen is graphical, in the Blackfyre dark palette with Archivo and JetBrains Mono, and has three pages switched by a short press of the left button: drive (mode chip, voltage and current with bars, height and speed, stride, stick and output), power (the last 60 s of voltage and current as 10 Hz traces, with the window's lowest voltage and highest current) and link (frames per second each side accepts and rejects, telemetry age, source, gamepad and its battery). The e-stop, every latched fault and a lost link show in a status strip on every page. Only the bridge needs flashing.
- **Held extremes.** The bridge's drive page marks the recent peak current and lowest voltage on their bars, and the desktop calibrator's current and supply charts draw them as named lines: held 3 s after they were reached, then easing back to the reading at 2 A/s or 0.5 V/s. On the bridge, a current beating the held peak by more than 0.1 A, or a voltage sagging 0.05 V below the held low, turns its value amber for a second.
- **Bridge screenshots.** `mise run bridge-screenshots` renders the bridge screen's pages and states to `docs/images/bridge-*.png` with the bridge's own drawing code on the host; the readme shows them.
- **Robot on the Pimoroni Servo 2040.** A pico-sdk firmware running a 20 ms control tick: link input, power protection, supervisor, calibration, body state machine, servo output on GPIO0–17, the status LEDs and telemetry.
- **Movement core.** The upstream inverse kinematics, Bézier foot paths and gait table (tri, wave, ripple, bi, quad, hop), ported to a non-blocking, hardware-free state machine (Initialise, Stand, Walk, Sleep, Calibrate) on a fixed 5 ms grid, with host tests.
- **Power protection.** Overcurrent, sustained overload, brown-out, low and high voltage, and the emergency stop. Faults latch and cut servo output at once. Clearing a fault never restarts motion; a new mode request must follow. Limits are set at build time for the fitted servos and supply.
- **Status LEDs.** The six WS2812 LEDs show the operating state and faults.
- **Gamepad bridge on the TTGO T-Display.**
  - Bluepad32 pairs one gamepad, mapped to modes, gaits, height, speed and stride.
  - Commands go to the robot over UART every 20 ms.
  - The screen shows the robot's telemetry, after a boot logo and start-up log.
  - The right button toggles the emergency stop.
- **Link protocol, version 2.** CRC-16 framed command, telemetry, calibration set and calibration report frames, and a pose frame for the USB host at 10 Hz. Golden vectors pin the format for every implementation.
- **USB link and source arbitration.** A computer can speak the link protocol on the robot's USB port alongside the debug text. The robot follows whichever link reports a connected controller, and sleeps on a conflict. `mise run build --serial` keeps the USB serial keys for bring-up without the bridge.
- **Live joint calibration.**
  - Per joint: an offset, the pulses for 0° and 180°, and the direction.
  - Changes are accepted only in Calibrate with output allowed, clamped (offset within ±30° of the default, pulses 400–2600 µs at least 1000 µs apart) and applied at no more than 60°/s.
  - They are held in RAM, confirmed by the robot's reports, and exported as the complete `calibration_defaults.cpp`.
- **Bridge setup mode.** Holding the left button during the boot logo starts a WiFi access point, joined with a QR code shown on the screen, and a captive portal in the Blackfyre look. Through it, a phone controls the robot's mode and calibrates its joints. Bluetooth and WiFi never run together.
- **WiFi drive on the bridge.** A latching switch from the bridge's GPIO32 to ground selects the drive mode at boot: open (or not fitted) keeps Bluetooth drive, closed starts WiFi drive, a WPA2 access point (`spooder-drive-XXXX`, its own password, channel 1, one station) through which one handheld drives the robot with link-protocol command frames in UDP datagrams to port 52040. The bridge still sends its own command frames every 20 ms, and keeps the link's safety rules for the handheld: exactly one valid version 3 command frame per datagram, at most 8 datagrams per 20 ms window, one sender at a time, a sequence rule that ends the session on a jump, no controller (so the robot sleeps) 150 ms after the last valid frame, its own fault-clear, mode- and gesture-request counters advanced on each change of the handheld's, Sleep until a session's first mode request, and the handheld's e-stop flag ORed with the GPIO35 button and kept through a lapse. While a session is live, the robot's frames go back to the handheld unchanged, one per datagram, without retries; a full 8-frame relay buffer drops and counts new frames, nothing is relayed without a live session, and no frame received during one session reaches the next session's sender. The screen shows the drive mode, the handheld's state, the network and its password, and `SWITCH MOVED: RESTART` when the switch no longer matches the running mode. Setup mode is entered from either drive mode and returns to the one the switch selects; Bluetooth and WiFi still never run together. No protocol change: only the bridge needs flashing.
- **WiFi drive probe.** `spooder-wifi-probe` (`mise run desktop-build`, `build/desktop/spooder-wifi-probe`) stands in for a handheld from a laptop joined to the WiFi drive network: command frames at 50 Hz with one mode request, the e-stop flag and its clear, one fault clear, a pause and a flood, and a per-second summary of the robot frames relayed back, with an error count.
- **Handheld controller.** A NextUI tool pak, `Spooder.pak` (copied to `Tools/tg5040/` on the SD card), turns a TrimUI Smart Pro into Spooder's driving controller through the bridge's WiFi drive. It is a nested Go module, `desktop/handheld/`, with gabagool v2.26.6 (patched with a power-button hook, `mise run handheld-fork`) and go-sdl2 v0.4.40, reusing the calibrator's link protocol and names.
  - **Driving:** the gamepad's mapping, ported line for line to Go and kept in step with `core/gamepad_mapping` by a new golden file (`test/golden/gamepad_mapping.txt`, which a new host test runs over the C++); Start stands for `Home`, L2 and R2 beyond half travel for the trigger buttons, Select + Start toggles the emergency stop, Select + Y held 1 s clears faults and Select + X switches to the driving view. A run and a return from suspend start in Sleep; there is no Calibrate. Command frames go in UDP datagrams to 192.168.4.1:52040 every 20 ms from one socket, after a 150 ms start-up wait; only datagrams from the bridge holding exactly one valid robot frame are taken; the bridge's other datagrams are counted as invalid and dropped, and the connected socket never delivers another sender's.
  - **Drive screen,** in the Blackfyre dark look (panels, chips, keycaps, one orange): the robot's mode, gait, output, faults by name, gesture, voltage and current (stale after 500 ms without telemetry), what the pak requests, and the WiFi link's quality: the signal, frames per type and second, invalid datagrams, lost and late frames by sequence number, and the time since the last frame (the signal from `/proc/net/wireless`, or from `iw dev wlan0 link` on the TrimUI, whose driver has no such file, sampled once a second; the header's signal chip carries a dot in the ok tone from -67 dBm, the warning tone from -80 dBm, orange below, muted while unknown). A second page, the driving view, draws the robot from its pose frames as a chase camera behind it sees it, looking forward and 45° down in perspective over a ground grid, with the body mode, output, supply and faults beside it. While the robot reports bench simulation, a SIM chip leads the header on both pages and the output reads as simulated.
  - **Leaving safely:** Menu, a short Power press and a 2 s hold first request Sleep and wait for two newer telemetry frames in a row reporting Sleep or output off, or 3 s, before the pak exits, suspends or powers off.
  - **Joining and power saving:** the pak checks for a 192.168.4.x address on `wlan0`, renews the lease once, and otherwise asks the user to join `spooder-drive-XXXX` in NextUI's WiFi settings; it turns WiFi power saving off for its run and restores it however it exits, in the binary and in `launch.sh`.
  - **Build:** `mise run handheld-test`, `mise run handheld-build` (desktop Linux, `--addr`) and `mise run handheld-package` (arm64 under rootless Podman in a pinned Debian bullseye image, checked for at most GLIBC 2.31, zipped to `build/handheld/Spooder.pak.zip`); CI tests and builds the amd64 binary. The calibrator's font files moved to the Gio-free `desktop/internal/ui/fonts/files`, which the drive screen shares. No protocol or firmware change.
- **Handheld gesture overlay.** While L2 is held beyond half travel, the handheld's drive screen shows a gesture overlay on either page: five tiles placed as the TrimUI's buttons (A, B, X, Y as a diamond, R2 beside it) with each gesture's name and keycap. Say hi and wiggle loop an animation drawn from the joint angles of the robot's own script; dance, attack and ball, which have no script yet, show a muted standing robot marked `NOT YET`. A request lights its tile for a moment, the gesture fresh telemetry reports playing stays lit, and `STAND FIRST` shows while the robot cannot start one. A new golden file, `test/golden/gestures.txt`, written by a new host test from `gesture::Player` and the inverse kinematics, feeds a generated Go table (`desktop/handheld/internal/gestures`), and a Go test keeps the two equal. `SPOODER_DRAW_TIMING=1` prints the longest draw and sampling gap each second. No protocol, firmware or control change.
- **Virtual bridge.** `virtual-robot --wifi-bridge [ADDR:]PORT` (default 127.0.0.1:52040) runs the bridge's own WiFi drive rules (`core/wifi_drive`) on UDP in place of the simulated bridge, relays the robot's frames to the locked handheld and reports each session's start and end with its longest tick interval; `mise run e2e` drives it with the handheld's run loop.
- **Desktop calibrator** (Go, Gio).
  - It observes or controls the robot over USB, with an e-stop on Space.
  - It shows telemetry, the joint editor with fine and coarse nudges, the debug log and decoded frames.
  - It exports the calibration into a checkout, with a diff and an atomic write.
  - It reconnects to the board by USB serial number.
- **Legs pane.** Forward kinematics of the reported pose, each joint's command, servo angle and pulse, rings at the servo limits, and a top view of all six legs with the front marked.
- **Readable robot console.** `mise run monitor` shows the robot's debug text with timestamps, decodes frames with `--frames`, and sends keys only with `--keys`.
- **Virtual robot.**
  - It runs the robot's own control tick natively, behind a pseudo-terminal that acts as the USB port, optionally with a bridge link or a simulated bridge.
  - Supply, current, load, e-stop and unplugging are simulated and can be driven from standard input.
  - `mise run desktop-sim` runs it together with the calibrator, and `mise run e2e` tests the calibrator against it.
- **Bridge image-size check.** Every build and upload checks the app against the factory partition of the custom partition table, and reports the headroom.
- **Robot image budget.** Every `mise run build`, up to date or not, and so every upload, checks the robot image against a 256 KiB flash budget and a 64 KiB static RAM budget, prints both uses (`flash 142.3 KiB of 256 KiB budget, 44 % free`) and fails when either is exceeded. Its logic is tested by `mise run test-robot-build`, which `mise run test` runs.
- **Warnings are errors.** Compiler warnings in Spooder's own sources (`core/`, `firmware/servo2040/src/`, `firmware/bridge/main/`, `test/`) fail the robot build, the bridge build and the host tests, each compiling them with `-Wall -Wextra -Werror`; warnings from the SDKs do not. The bridge's component re-enables the warnings ESP-IDF switches off and makes its non-fatal ones fatal. The warnings this surfaced are fixed in the code.
- **Toolchain.** mise provides every toolchain, and the SDKs are pinned git submodules. OpenSpec holds the specifications.
- **Calibrator icon.** A hexapod from above in the Blackfyre colours (`desktop/assets`), and `mise run desktop-install`, which installs a launcher and the icon for the current user on Linux.
- **Gestures.** A Perform body mode plays say hi and wiggle from Stand: keyframes of body shifts over planted feet and lifted legs, eased and rate-limited to 300 mm/s per foot, interrupted at once by Sleep, a stale command, the e-stop or a fault, and ended after the current keyframe by any other request. Triggered by L2 + a face button on the gamepad and by buttons or keys 4–8 in the desktop calibrator; the bridge screen, the calibrator and the console show the gesture playing.
- **Gamepad rumble.** The bridge rumbles the gamepad when a protection fault latches, its e-stop switches on or off, the robot link is lost or regained, or a gesture request does not play; one pattern per event, by priority, never repeating within a second.
- **Servo profiles and the joint speed budget.**
  - The build names the fitted servo model (`SPOODER_SERVO_PROFILE`, default `MG996R`). Its rated speed and the share usable under load (MG996R: 429°/s, 0.6) set a joint speed budget.
  - Movement slows its own clock, in 20 ms pieces, wherever full speed would turn a joint faster than the budget. Feet keep their paths, and motion stays independent of the tick length.
  - An output rate backstop never moves a joint faster than the servo's rated speed. It reports on the USB console when it engages.
- **Build identity.** Each firmware names its build: `git describe --always --dirty --abbrev=12` of the checkout at build time, or `unknown` without git (printable ASCII only, cut at 40 characters on the consoles). The robot prints `spooder robot: build <id>` on its USB console on its first tick and each time a USB host connects, the virtual robot the same on its USB terminal, and the bridge `spooder bridge: build <id>` on its console at boot (also in setup mode) with `Build <id>` as the first line of its start-up log. A new commit recompiles one file; no protocol change.
- **Project files.** An MIT licence, this changelog and an expanded readme.
- **Link parser fuzzing.** Go fuzz tests of the desktop's link decoder (`FuzzDecoder`) and of its split of the USB stream into frames and debug text (`FuzzSplitArbitrary`, `FuzzSplitInterleaved`), seeded from the golden frames: no panic, bounded buffers and lines, every byte accounted for, canonical re-encoding, and text never mixed with frames. `mise run desktop-test` replays their seeds and any saved failing inputs on every run; `mise run fuzz` fuzzes each with random inputs for a bounded time (`--time`, default 60 s). The first full run found no bug.
- **Hardened host tests.** `mise run test` builds and runs the `core/` host tests with AddressSanitizer and UndefinedBehaviorSanitizer (including float-to-integer overflow), so the first finding fails the run. Where the compiler cannot link the runtimes it warns and runs unsanitised, except under CI or with `SPOODER_REQUIRE_SANITIZERS=1`, where it fails. It also checks first that the native env's source list names exactly the `.cpp` files under `core/`. The first sanitised run found a stack-use-after-scope in the centre-of-gravity test, now fixed.
- **Static checks.** `mise run lint` checks the layout of Spooder's own C++ against a root `.clang-format` (Allman braces, two-space indent; the vendored code, the generated fonts, the golden files and the exported calibration excluded) and runs clang-tidy on `core/` (`bugprone-*` with narrowing conversions, and a few `performance-*` and `readability-*` checks), both pinned to 22.1.8 in `mise.toml`. `mise run desktop-test` runs staticcheck 2026.2.2, pinned by a `tool` directive in `desktop/go.mod`. Both are verification gates, and CI runs them. The one-off reformatting commit is listed in `.git-blame-ignore-revs`.
- **Bench simulation on the robot.** The Servo 2040 firmware can be driven end to end on USB alone, with no servo supply, while no servo moves. For up to 3 s after start-up (closing early once servo output switches on) LED 6 blinks white; a press of the USER button (GPIO23) then enters simulation if the button was seen released first, the servo supply has read below 1 V on every tick since start-up, servo output is off and a USB host has enumerated the board and not suspended it (a charger does not count). One press decides per boot; a refusal shows its reason on LED 6 for 3 s (red and amber: supply present; red and blue: no USB host) and on the console. Simulation lasts until restart and is held in RAM only. On entry servo output is forced off at the board boundary (`bench_sim::BenchBoard`, host-tested) and in `servo_output::forceOff` (sticky until restart), and every servo call goes to the servo model; protection evaluates the modelled supply (6.0 V at load 1), moved from the virtual robot into `core/robot/bench_model` and shared by both. A real supply above the brown-out voltage during simulation latches a new fault, the simulation supply fault (`SIMULATION_SUPPLY`, bit 6: cyan and red on all six LEDs, cleared only by a restart). Telemetry sets the new flag `TELEMETRY_SIMULATED` (bit 5) and reports the modelled output, voltage and current; the pose frame reports the modelled pulses and output; the golden vector `telemetry_bench_simulation` pins it. The bridge screen shows `SIM` and `OUT SIM` and names `SIM SUPPLY`; the desktop calibrator shows a bench simulation banner, the output as `on (sim)` and the fault as `supply in simulation`, and its console `SIM`. No protocol version change: older receivers ignore the flag and show the fault by number. Only the robot needs flashing for the mode; the bridge and the calibrator for its names.
- **Worktree setup.** `mise run worktree-init`, run inside a git worktree another tool created (such as Orca, whose setup command is `mise trust -q && mise run worktree-init`), clones its SDK submodules from the primary checkout and shares its `.pio-core`, as `mise run worktree-add` does for delivery worktrees. It is safe to repeat.

### Changed

- **One starting speed.** The speed dial every controller and the robot start at, 44, is one constant (`START_SPEED`, `core/movement/movement_command.h`) for the gamepad mapping, the portal, the bridge, the handheld controller and the virtual robot's simulated bridge; the Go copies are pinned to it at compile time. No behaviour changes.
- **Bench simulation waits for USB on LED 6.** During the 3 s window after start-up, LED 6 blinks amber slowly (on half of each second) until a computer has enumerated the board, about 1 s, and only then fast white: a press while it is amber is refused for no USB host, as before, so the white blink now marks when a press can enter. Only the robot changes; flash it.
- **Battery position.** The centre-of-gravity estimate places the battery at the centre of the cavity under the frame, which it fills (49.3 × 151.65 × 29.75 mm, measured from upstream's `Frame Bottom.stl` and `Frame Top.stl`): (0, −0.18, 1.13) mm in the body frame instead of the origin. With the battery the robot's estimated centre moves 0.02 mm back and 0.11 mm up; the support margins change by under 0.02 mm. The desktop's four-view window shows the new estimate. No firmware behaviour changes.
- **The pak's start screen in the Blackfyre look.** The join message and any other start-up error show on the pak's own start screen, drawn as the drive screen is (the `Spooder.` title, a panel with the message, the `A` RETRY and `B` QUIT keycaps), in place of gabagool's NextUI-styled message; while the start check runs it says so. `Menu` quits too. Every screen of the pak now follows the Blackfyre design system. Only the pak changes.
- **Weighed masses.** The centre-of-gravity estimate counts the body at 497 g instead of the estimated 420 g (the centre weighed 827 g with its six coxa servos, which the model counts at the coxa pivots with the legs), and each leg outward of the coxa servo (the coxa bracket, the femur and tibia servos and the links) at the weighed 303 g instead of the estimated 235 g, the links taking what the two servos leave in the earlier ratio (46, 70 and 77 g). The coxa servos stay at the coxa pivots, on the frame. The robot's estimated mass rises from 2160 g to 2645 g without the battery (827 + 6 × 303). The gesture tests pass unchanged; the desktop's four-view window shows the new estimate.
- **Wave is the starting gait.** The bridge's gamepad mapping, the setup portal, the handheld pak and the desktop calibrator's keyboard driving start in Wave instead of Tri. Wave keeps five or six feet down and spreads the weighed robot's load most evenly; in a static estimate the tripod needs 150–175 % of an MG996R's stall torque at the femurs. The robot starts in Wave too and runs in it with no source in control (`gait::START_GAIT`), so its telemetry, and the bridge screen, the pak and the calibrator, no longer show Tri while the body is stopped or before a controller is in control; the bridge's WiFi drive without a live handheld, its first frames, `spooder-wifi-probe`, the virtual robot's simulated bridge and the `--serial` keys start at Wave as well. The gait order is unchanged, so `L1` (or the previous gait) still reaches Tri. Flash the robot and the bridge and install the pak.
- **Supply bands on the pak and the bridge.** The supply voltage and current read green, amber or orange by band against the protection limits the robot reports in its diagnostics frames (the build's `power_limits.h`): amber within the brown-out-to-undervoltage gap of either voltage limit or from the sustained current, orange at or past undervoltage, overvoltage or the trip current (the Blackfyre palette's alarm colour; it has no red). On the pak: the robot panel's supply and current and the driving view's supply; on the bridge: the drive page's values (a held-extreme warning still turns a green value amber) and the power page's newest values and window extremes. One rule, `core/status/supply_band`, with a Go copy in the pak, both pinned by `test/golden/supply_bands.txt`. Without reported limits the values keep their old colours. The pak and the bridge need updating; the robot does not.
- **Handheld driving view and hint keys.** The pak's driving view names the gesture the robot plays (a GESTURE cell beside the body mode, which until now read only `Perform`), and the small keys beside each REQUESTED label press down while their control is held, as the footer's keycaps do (not while `Select` or `L2` turns the control to another function). Only the pak changes.
- **Documentation section.** The readme keeps the overview, features, a quick start and the status; the details move to `docs/`: getting started (toolchains, flashing, bench simulation, wiring), the gamepad's and the handheld's controls, the handheld controller (installing the pak, joining, its two pages with screenshots, leaving), the screenshots and development (the gates, the layout, regenerating the screenshots).
- **Measured leg mounts.** The coxa pivots are measured from upstream's frame STLs (`core/movement/body_geometry.h`, pinned for the desktop by `test/golden/body_geometry.txt`): (±97.50, 0) for the middle legs and (±60.41, ±89.56) for the corners, in place of the schematic (±90, 0) and (±70, ±120). The calibrator's legs pane and four views draw them, and the centre-of-gravity estimate, the gesture and gait stability tests use them: the support margins in `test/golden/centre_of_gravity.txt` shrink by 6–17 mm; the centre itself is unchanged. No firmware behaviour changes.
- **Measured underside.** The body's lowest point, the underside of the coxa links under the pivots (Coxa Horn Connector), lies 24.2 mm below the coxa pivots, measured from upstream's STLs (`body_geometry::UNDERSIDE_Z`, `hardware/aecert-hexapod-v1/README.md`; Frame Bottom's underside is at 15.75 mm); `test/golden/body_geometry.txt` gains an `underside` line, which the desktop's tests read. `centre_of_gravity::undersideGrounded` says when the body rests on it, and the gesture support test then counts the frame, not the feet, as the support. No firmware behaviour changes.
- The robot moved from the Arduino Nano RP2040 Connect (PCA9685 servo driver, Bluepad32 on its NINA module) to the Servo 2040, and the gamepad moved from the robot to the bridge.
- Coxa offsets are shown from the servo centre (stored value minus 90°) in the portal and the calibrator. The stored values, the link and the export are unchanged.
- Compiled defaults must let every servo reach the calibration pose: the IK angle there, plus the offset, within 0–180°.
- The overcurrent trip has two levels. Above the trip current (9 A) it latches only once the current has stayed there for `SPOODER_TRIP_PERSIST_MS` (60 ms), so the surge of all servos starting together passes; above the new ceiling, `SPOODER_CEILING_CURRENT_A` (13 A), one reading still cuts output at once. Limits files need both new constants.
- Servo output switches on two legs per tick (legs 1–2, then 3–4, then 5–6), so the servos' start surges no longer coincide: the 11.8 A measured with all 18 starting together drops to about a third. Switching off stays immediate.

- The desktop calibrator's top bar puts the ports, Refresh, Connect, the control toggle and the e-stop on one aligned row of equal-height buttons, with the link state beneath.
- While in control, the desktop calibrator shows its keyboard controls under the mode buttons.
- **Four-view window in the desktop calibrator.** "4 views" in the top bar opens a second window that draws the whole robot from the pose: top, front, left and isometric views. The body is a schematic plate, and the window shows the ground at the lowest foot, the selected leg, the servo limits and the leg numbers. The three orthographic views share one scale.
- **Charts in the desktop calibrator.** A charts tab keeps ten minutes of supply voltage, current, link frame rates, a mode/output/fault timeline, joint speeds against the servo budget, the selected leg's servo angles, the budget's motion share, the control tick's time and backstop hits. It has 30 s, 2 min and 10 min windows, a hover readout on every chart, and a CSV export.
- **CI and Dependabot.** GitHub Actions runs the verification gates (host tests, both robot builds, the bridge, the desktop tests, build and e2e) on a clean runner for every push to `main` and `deliver/*` and every pull request, and nightly with `govulncheck` (`mise run vulncheck`, against a shrink-only baseline of the four `golang.org/x/image` issues the desktop reaches). Dependabot proposes monthly, 7-day-old updates of the actions and Go modules, and security updates at once. `uv` is now pinned in `mise.toml` (PlatformIO installs through it).
- **Split `CLAUDE.md`.** The root file keeps what applies everywhere (toolchain, commands, gates, cross-cutting rules); each area has its own `CLAUDE.md` with its layout and rules (`core/`, `firmware/servo2040/`, `firmware/bridge/`, `desktop/`, `tools/`, `test/`), loaded when that area is worked on, and the delivery workflow is described in `.claude/workflows/README.md`.
- **Pose and diagnostics on the bridge link.** The robot sends the pose and diagnostics frames on the bridge link (UART1) as well as on USB, on the same ticks and at the same 10 Hz, with the same diagnostics values on both links. The bridge decodes and ignores them for now (its link page counts about 30 accepted frames per second instead of 10); a later change relays them to the handheld controller. No protocol change: only the robot needs flashing.
- **Review rules and risk tiers.** `REVIEW.md` sets how changes are reviewed here: failure per area, severity tags, evidence, a nit cap, skipped paths, known bug classes, a security lens. `tools/risk-tier.sh` sets a change's tier (low, medium, high) from the paths it touches. The delivery workflow follows both: capped, diff-only re-review rounds with every finding answered and pre-existing ones kept apart, a security review where input arrives, a human approval of the exact commit before a high-risk change merges, and the testing and revert command reported with each merge.
- **Delivery workflow.** `deliver-changes` (`.claude/workflows/`) delivers changes from a brief or an existing OpenSpec change through proposal, Codex reviews, task-group implementation, the touched areas' gates, archival and a serialised merge to `main`. `mise run worktree-add`/`worktree-remove` (`tools/worktree.sh`) give each change a worktree with the submodules cloned from the checkout and the bridge toolchain shared.
- **Hardware bill of materials.** `hardware/aecert-hexapod-v1/BOM.md`: bearings, inserts and screws derived from the printed parts, since upstream never published a list, with the confidence of each item.
- **MG996R model.** `hardware/mg996r/`, a STEP model of the servo (MIT).
- **Board reference files.** `hardware/lilygo-t-display/` (LilyGO's STEP model, case shell, schematic and KiCad/Eagle libraries, MIT) and `hardware/pimoroni-servo2040/` (Pimoroni's schematic and mechanical drawing, with the key dimensions).
- **Printed parts.** Aecert's Hexapod V1 STLs and whole-robot 3MF, at the upstream commit the movement code was ported from, in `hardware/aecert-hexapod-v1/`, with their source and the measured link lengths.
- **Electronics mount measurements.** `hardware/spooder-electronics-mount/measurements.py` holds the sizes the mount will be built from, each with its source: nominal sizes of the SZBK07, the LM2596, the fan, the IMU breakout, the Schottky diode and a seated servo plug, listed in the README's "Measure before printing" table; and the frame top's levels, inserts and open space, the Servo 2040's headers and terminal, and the T-Display's outline and bare spots, which `reference_check.py` re-derives from the reference files.
- **Electronics mount generator.** `hardware/spooder-electronics-mount/build.py` generates the mount's parts with build123d, checks them (one solid each, the legs' keep-clear region, the frame floor, the 256 mm bed, the deck's holes on the frame's inserts, overlaps, enclosure by the cover, reserved cable routes, frame clearance under ties and slots, overhangs and teardrops in each print orientation, screwdriver paths and the air channel) and only then writes each distinct part once as STL (the cover as 3MF) and STEP in the frame top's coordinates, re-reading the files in a staging folder before they replace the old ones. `mise run cad` checks and exports, `mise run cad-preview` renders the assembly.
- **Electronics mount deck and layout.** `hardware/spooder-electronics-mount/layout.py` places the held parts by their wiring and builds the deck: screwed to the frame top's eight inserts (with printed spacers at the four floor inserts), with stops for the SZBK07, standoffs for the Servo 2040 over the LSM6DSO's pad, screwed bosses for the LM2596, a cradle for the XT60 that takes plugging and unplugging, lead slots for the servo leads, tie holes (the Schottky diode's on the LM2596's output route), the end-stop wires' entry and the distance sensor's pass-through. Every cable run has a reserved route that reaches each terminal from its wire side; new checks cover route ends, the diode route's width and the sensor provisions, and the build now writes the deck and the spacer.
- **Parametric reference parts.** `hardware/parametric-reference-parts/` models the reference printed parts in build123d from named dimensions measured on their STLs, starting with Aecert's frame group (Frame Top, Frame Bottom, Servo Mount, Bearing Axle Mount, Hubcap), each in its STL's own coordinates. Parts are found from their own files in a source's `parts/` folder, with no registry, and part code may not read files or import mesh readers. Each part must be one valid closed solid within 0.5 % of its STL's volume, 0.20 mm maximum and 0.05 mm 95th-percentile surface deviation both ways, and 0.15 mm on each bounding-box face; only then is it written as STEP, re-read in a staging folder and published by replacing `step/` as a whole, then imported in FreeCAD and solidcraft-cli (`SKIPPED` where a tool is absent). `mise run cad-reference` runs the tests and the build; the README gives the part contract, how to add a part, the tolerances against the STLs' chord error and the versions checked.
- **Parametric coxa parts.** Aecert's coxa group (Coxa Horn Connector, Coxa Horn Side, Coxa Bearing Connector, Coxa Bearing Side) is modelled in `hardware/parametric-reference-parts/`, each within the global gates with no exception and exported as STEP; `test_coxa.py` checks the coxa link geometry that `hardware/aecert-hexapod-v1/README.md` records against the built solids (no value disagrees). The source README states that the author knows about Spooder's derived models and has raised no concerns, informally and granting no licence.
- **Parametric femur parts.** The femur group (Femur Horn Side, Femur Bearing Side, Femur Support) joins `hardware/parametric-reference-parts/aecert-hexapod-v1/`, each within the global gates without an exception and exported as STEP. Both side plates place their second bore from one named axis-to-axis length, 110.000 mm as the STLs have it (2 mm more than the 108 mm in `hardware/aecert-hexapod-v1/README.md`), which `test_femur.py` checks on the built solids' bore axes.
- **Electronics mount cover.** The mount's cover: a faceted shell styled as a rugged sci-fi case, printed lid-down, with 45° corner faces, a chamfered top edge, a groove round its walls, armour plates on its side walls, panel lines and bolt heads engraved in the lid, a bevelled window over the T-Display, a notch for the battery's plug, flush yellow inlays (the name, chevrons and hazard stripes) exported as a two-part 3MF, and three M3 screws into heat-set inserts in posts on the deck. Cooling: an inlet grille low in the left wall with an optional 30 mm intake fan position, an outlet grille high in the front-right corner face with a 30 mm exhaust fan position, both fans in holders on the deck, and a passive air channel over the SZBK07, under a lid closed above it that also holds it down. New checks cover the fans' seats and vents, the cover's lift-off, hold-down and closed lid, and air-channel runs turned towards a corner.
- **Electronics mount bumpers and holders.** Yellow PETG corner guards as bumpers, printed hollow so they give in a knock, that wrap each corner and slide down onto dovetail rails at the ends of its face, stopped by 45° wedges flush with the top chamfer and held by quarter-sphere detents that snap into dimples in the side walls, standing past the side walls and above the lid, and lifting off with the cover in place; one part fits all four corners. White holders that sit loose in pockets in the deck, kept there by what lies over them: standoffs for the LM2596 (now raised under the T-Display's holder), a pad for the LSM6DSO, the fans' holders, and the T-Display's holder, a portal over the LM2596 that bears on the board's bare spots, locates it with lips and pads, and is held down through the board by the lid. New checks cover the bumpers' reach, retention (the detents, and the rails when pulled off), stop, fit and removal, the holders staying in their pockets (through stacks of loose parts), and the holder's bearing on the board.
- **Electronics mount documentation.** The mount's README gives each printed file's part, copies, colour and print orientation (checked against the built parts by a test, and drawn on a build plate by `mise run cad-preview`), starting print settings, the hardware list with screw lengths, the assembly order, the cable routes and the cooling with the fans' supply. The hardware-check skill names the LM2596 as the logic buck that feeds both boards on their pins, states its dropout near an empty pack (which the power protection, watching the servo rail, does not cover) and adds the fans on its output. The printed-parts skill now matches the mount (PETG, the 256 mm bed, the parts' print orientations, the locked `uv` scripts, the staged export) and asks for every assumed bought-part size to be listed to measure; `REVIEW.md` reviews the mount's code (not its generated files) and lists the bug classes its reviews found more than once; the root `CLAUDE.md` names `mise run cad` and `mise run cad-preview`, and `mise run cad` as the mount's gate.
- **Electronics mount verification.** A review of the physical and assembly problems led to four fixes. The overhang check now rejects a narrow face held at only one end, and the exhaust lips (now sloped at 45°) and the T-Display holder's plate were changed to pass it. A block under the lid stops the intake fan lifting out over its lips upside down. The air channel check measures each grille's open area through the cover. The build rejects measured values that the layout cannot take, such as the SZBK07's terminals on its long ends.
- **Estimated centre of gravity.** The four-view window marks the robot's estimated centre of gravity in every view, with a line down to the ground, draws the support polygon of the feet on the ground in the top view, and shows the centre, the mass and the support margin (fine from 20 mm, a warning nearer the edge, a danger outside). A button fits the 2S 5000 mAh battery (284 g) in the centre body; the window opens without it. Apart from the servos and the battery, which are weighed, the masses are estimates (2.16 kg without the battery, 1.74 kg of it in the legs) on the schematic body, in one table in `core/movement/centre_of_gravity`, which the desktop's copy follows through golden vectors. The gesture tests check the estimate's margin too.
- **Diagnostics frame.** The robot sends its internals to the USB host at 10 Hz: the budget's motion share, backstop count, tick time, averaged current, its power limits and the servo profile's speeds. It is a new frame type of protocol version 3, so the bridge is unaffected.
- The desktop calibrator drives the robot from the keyboard while in control. W/S walk, A/D steer (as the bridge's car layout: on the spot without walking, mirrored when reversing) and Q/E step sideways. Z/X set the speed dial, C/V the height, G the gait and T the stride mode. Losing the window focus stops the input.
- The desktop calibrator's mode controls are on keys too: 1 Stand, 2 Calibrate, 3 Sleep, F Clear fault, only while in control.

- Walking and turning are superposed instead of shared: turning while walking keeps the full forward stride and follows an arc, with one common scale when a stroke would get too long or unreachable.
- The bridge steers like a car by default: left stick Y walks, left stick X steers, mirrored when reversing; `b` switches to the crab layout. The right stick turns the body the way it points (it was inverted). The screen shows the stick mode.

- The link protocol is version 3: the command frame carries a gesture request and its counter (14-byte payload), telemetry the gesture playing. Flash both boards together.

- Walking at higher speed dial settings is slower: as fast as the servos can follow, no faster.
- Feet are fitted to the servos' 0–180° travel outside Calibrate: a target that would take a joint past its end (with the calibration offsets) is moved just enough, continuously, so the joints agree with each other instead of one being clamped at its pulse limit.
- The speed dial and the stride mode are eased like translate and height, so changing either no longer moves every foot at once.
- The movement code costs much less on the RP2040: the stride's reach is solved exactly instead of searched, trigonometry and powers are gone from the foot paths, and phase tracking computes the stride only on a phase change.
- A leg entering its cycle part-way through a phase (entering Walk, a gait change) starts from where its foot is, instead of jumping onto the path (up to 45° in one tick in Bi and Ripple).
- Foot targets are valid only within the femur and tibia's reach from the femur joint, less 4 mm (295 mm), not 340 mm from the coxa pivot. Strides that would not reach shrink smoothly, for single motions too. At body height 100 they are shorter than before: 50–78% at the default dial.

- The desktop calibrator and the setup portal follow the Blackfyre design system's tokens: its exact colours (with `bf-ok` for the status green and the dark-panel shades in dark mode), 10 px buttons on raised edges (3 px under dark buttons, 2 px with a highlight under light and orange ones), 22 px panels and 14 px cards, the label, kicker and micro letter-spacing, and display titles ending in an orange full stop. The portal also gets 44 px touch targets, numbered section kickers, hairline-outlined panels with the panel shadow, and the accent focus ring. Text on the orange stays ink: the system's white reaches only 3.78:1.
- The desktop calibrator's debug log and frames pane are selectable across lines with the mouse (Shift+click extends) and copied with Ctrl+C (Cmd+C on macOS), which no longer lowers the height. They follow new lines only while their end is in view; scrolled up or holding a selection, the view stays on the same lines, also as the oldest are dropped.

- Telemetry on every link also reports the bridge link: up or down, whether a gamepad is on it, and its frame counts (reserved bytes, no version bump). The desktop calibrator shows it in a Bridge cell, and `mise run monitor --frames` on each telemetry line.

### Removed

- The Nano RP2040 Connect firmware (it remains in the history).

### Suspended

- I²C body sensing (VL6180X range, LSM6DSO IMU), until the sensor boards are found.

## 2024-02-09: prototype

The first iteration on Aecert's Hexapod V1: an Arduino build for the Nano RP2040 Connect with the upstream movement code, a Bluepad32 gamepad, an SH1107 display, IMU (IKS01A3) and range (VL6180X) sensor experiments, and a first walk.
