blackfyre/spooder/openspec/changes/add-bench-simulation/tasks.md

# Tasks

## 1. Shared model and protocol

- [x] 1.1 Move `sim::Servos`, `sim::Supply` and their constants from `tools/virtual-robot/src/sim.{h,cpp}` into `core/robot/bench_model.{h,cpp}` unchanged (D1), keep `sim::Bridge` in the virtual robot and point it at the moved types, and list the new source in the root `platformio.ini`. Verify `mise run test` (with its source-list check), `mise run virtual-robot` and `mise run e2e` pass, and that a new `test/test_bench_model` covers zero current with output off, the idle draw per powered servo, the moving draw and its cap, the load factor and a fixed current.
- [x] 1.2 Add `TELEMETRY_SIMULATED = 1u << 5` to `core/protocol/protocol.h` and `desktop/internal/protocol`, the protection fault `SIMULATION_SUPPLY = 1u << 6` (inhibiting) with `protection::step`'s defaulted `simulationSupply` parameter (D4), and the golden vector `telemetry_bench_simulation` (flags 32, faults 64, output on) regenerated with `SPOODER_WRITE_GOLDEN=1` (D6). Verify via `mise run test`: new `test/test_protection` cases (the fault latches at once and inhibits output, a clear keeps it while the condition is present, it clears after the condition goes and a clear arrives, other faults unchanged without the parameter), `test/test_protocol_golden` passing with the new vector and every existing line unchanged (`git diff` of `test/golden/protocol_v3.txt` adds one line), and the desktop's golden test passing via `mise run desktop-test`, with both decoders' assertions on the new vector checking every field other than the flags byte and faults (the older-receiver scenario: a decoder that does not know bit 5 reads the rest of the frame as before).

## 2. Bench simulation logic in the core

- [x] 2.1 Add `core/robot/bench_sim.{h,cpp}` with `Entry` and `step()` (D2): the 3 s window from the first tick, the press edge, the supply gate below 1.0 V on every tick since boot, the output gate closing the window, the USB gate at the press, one decision per boot, the refusal reason (supply before USB) shown for 3 s, Simulating latched for the boot and unaffected by USB, and the supply fault above the brown-out voltage in Simulating; list it in `platformio.ini`. Verify with a new `test/test_bench_sim` via `mise run test` covering each scenario of the `bench-simulation` spec's offer, entry, refusal, duration and supply-appearing requirements: a press at 2,980 ms and at 3,000 ms, a button held from the first tick (no entry) and released then pressed (entry), a supply reading of 0.99 V and of 1.0 V on one tick before the press, output on at 1 s then a press, USB not mounted and mounted but suspended, both gates failing (supply reason), a second press after a refusal (nothing), USB lost while Simulating (stays), a supply of 4.8 V and 4.9 V in Simulating with a 4.8 V brown-out limit, the refusal indication shown until exactly 3,000 ms after the press and then none (for a press at 1 s and at 2,980 ms, the latter outlasting the window), and a fresh `Entry` after a simulated session (the restart) starting in the window in live mode.
- [x] 2.2 Add `bench_sim::BenchBoard` (D3): `final` servo methods over protected real hooks, `enterSimulation()` setting the simulation flag and then calling the `realForceOff` hook once, and the servo methods routed to a `bench_model::Servos` from then on. Verify with a new case set in `test/test_bench_sim` via `mise run test`: a fake board derived from `BenchBoard` records `realForceOff` called exactly once, inside `enterSimulation()` and before any later hook call, and never before entry; it fails on any `realApply` or `realSetInhibited(false)` after entry while `robot_tick::tick` is driven through Stand, Walk, Calibrate with a calibration change, an emergency stop, a fault clear and a new request; before entry every call reaches the hooks unchanged; `servosOn()` and `servoPulses()` report the model's state, with legs switching on in groups of two.
- [x] 2.3 Wire `robot_tick::Inputs::bench` into the tick (D4, D5): `TELEMETRY_SIMULATED` in every telemetry frame while simulated, the supply fault passed to protection, the indication into `led_pattern::State::bench` with LED 5's window, refusal and simulation patterns and the cyan fault colour first in the priority list, `; SIMULATION` on the status line, and the entered and refused log lines. Verify via `mise run test` with new cases in `test/test_robot_tick` (the flag clear with `bench` zero and set in simulation, protection accepting the modelled supply 500 ms after entry and not before, the body starting only on the next new request after that, telemetry reporting the modelled reading and output on, the supply fault latching, stopping the body and surviving a clear, the status line and the two log lines printable ASCII) and `test/test_led_pattern` (each LED 5 pattern at both blink phases, the window pattern over a latched fault and the supply wait, the simulation pattern's normal half, the cyan fault before the emergency stop and replacing the simulation overlay on LED 5 at both phases, every pattern distinct from the existing ones), and `mise run lint`.
- [x] 2.4 Show the window as Waiting (`led_pattern::Bench::Waiting`, LED 5 amber on for 500 ms of each second) while no USB host is attached, and as Available (white) once one is (D5), with tests in `test_bench_sim` and `test_led_pattern`; update the docs and the skill

## 3. Robot firmware

- [x] 3.1 In `firmware/servo2040/src/main.cpp`: configure GPIO23 as an input with the pull-up, read it, the measured supply and `tud_mounted() && !tud_suspended()` each tick into `bench_sim::step` before the tick, derive `Board` from `BenchBoard` with the hooks forwarding to `servo_output`, call `enterSimulation()` on entry, feed the tick the model's reading in simulation, and start the working-time measurement before `bench_sim::step`; add `servo_output::forceOff()` (sticky: `apply()` returns at once and `setInhibited(false)` does nothing until restart), called only from the `realForceOff` hook (D2, D3, D4, D8). Verify `mise run build` passes its budget check with and without `--serial`, that `grep` finds `servo_output::apply` called only from the `realApply` hook and `servo_output::forceOff` only from the `realForceOff` hook, and that `grep` finds no `watchdog_hw->scratch` or flash write in `firmware/servo2040/src`.

## 4. Viewers

- [x] 4.1 Show simulation on the bridge screen (D7): `SIM` in the status strip in the warning tone, `OUT SIM` on the drive page, and the names `SIM SUPPLY` and `sim supply` for the new fault in `core/status/status_screen`. Verify with new cases in `test/test_status_screen` via `mise run test` (each scenario of this change's status-display delta, SIM beside each named fault and the source conflict with every line within its field width, pages without the flag unchanged), `mise run build-bridge` and `mise run bridge-screenshots` passing with the existing images unchanged.
- [x] 4.2 Show simulation in the desktop calibrator (D7): the banner, the output cell marked as simulated, the fault name `supply in simulation` in `session.FaultNames`, and `SIM` in the console's telemetry line. Verify with Go tests via `mise run desktop-test` (the banner and output text with the flag set and their absence without it, the fault named rather than `fault bit 6`, the console line), and that `mise run desktop-build` passes.

## 5. Documentation

- [x] 5.1 Update `firmware/servo2040/CLAUDE.md` (the USER button, the board boundary and `forceOff`), `core/CLAUDE.md` (`robot/bench_sim`, `robot/bench_model`), the `spooder-firmware-shape` skill (the board boundary in simulation), the `spooder-hardware-check` skill (entering simulation, the LED patterns, the refusal reasons and the 5.5 s supply drain, the supply fault), `Readme.md` and `CHANGELOG.md` under Unreleased. Verify by reading them against the spec deltas, and that `grep` finds GPIO23 in `firmware/servo2040/CLAUDE.md` and the hardware-check skill, and `TELEMETRY_SIMULATED` in the changelog.

## 6. Gates

- [x] 6.1 Run every gate from the worktree: `mise run lint`, `mise run test`, `mise run build` (with and without `--serial`), `mise run build-bridge`, `mise run desktop-test`, `mise run desktop-build` and `mise run e2e`. Verify all pass.

## 7. On the board

- [ ] 7.1 With the Servo 2040 on USB only (no servo supply), enumerated by a computer running the desktop calibrator: after LED 5 has turned from slow amber to blinking white (about 1 s after start-up), press USER. Verify the console logs `bench simulation: entered`, LED 5 shows violet half of each second, the calibrator shows the simulation banner, Stand and Walk move the leg view, and that an emergency stop, a fault clear and a new request behave as on a powered robot. Throughout, a logic analyser or oscilloscope on the servo signal pins, triggering on any rising edge and armed before the press, captures no edge from entry through Stand, Walk, a calibration change, the e-stop, the clear and the new request (with fewer than 18 channels, repeat the sequence per group of pins until all 18 are covered). Also verify that the diagnostics' longest tick working time stays below 20 ms during the window, at entry and while walking in simulation.
- [ ] 7.2 With the servo supply connected, restart and press USER in the window. Verify entry is refused with the supply reason on LED 5 and in the console; then disconnect the supply, press RESET at once and press USER: refused while the sense still reads 1 V or more; after waiting about 6 s, RESET and USER enter simulation. Also verify a press with only a USB charger (no host) is refused with the USB reason.
- [ ] 7.3 In simulation, walking, connect the 6 V servo supply. Verify the simulation supply fault latches (cyan and red on all six LEDs, LED 5 included, named on the console, the calibrator and the bridge screen), the body stops, no servo moves, and a fault clear leaves it latched until RESET.
- [ ] 7.4 In simulation, keeping the board on USB power, disconnect the host logically: deauthorise the device (`echo 0 > /sys/bus/usb/devices/<port>/authorized`), then authorise it again, and suspend it (runtime autosuspend or host sleep), then resume. Verify the robot stays in simulation (LED 5 violet) throughout and enters nothing new; record in design.md, with a console line added for the bench session or a debugger, whether TinyUSB reported each as unmount or suspend.
