blackfyre/spooder/openspec/changes/add-gestures/tasks.md

# Tasks

## 1. Part one: Perform mode, protocol 3, say hi and wiggle

- [x] 1.1 Add `Mode::Perform` and the keyframe gesture player to `core/movement/body`, with entry from a settled Stand, return to Stand, and interruption as in design D1; host tests
- [x] 1.2 Add protocol version 3 (gesture id and counter in the command, gesture in telemetry), counter baselines after a link gap in `link_receiver`, and regenerate the golden vectors deliberately (D4); host tests
- [x] 1.3 Move the Go protocol to version 3 against the golden vectors; session and telemetry show the gesture
- [x] 1.4 Script say hi and wiggle (translate sway only); host tests for reachability, servo range and stability (D2; stability against the schematic pivots until 2.1)
- [x] 1.5 Bridge: the L2 gesture layer (D5) with host tests; the screen shows the gesture
- [x] 1.6 Desktop: gesture buttons and keys 4–8 while in control; e2e test playing each gesture on the virtual robot
- [x] 1.7 Verify every gate (`mise run test`, both robot builds, `build-bridge`, `desktop-test`, `desktop-build`, `e2e`); flash both boards together and play both gestures on the supported robot

## 2. Part two: body geometry, dance, attack and ball

- [x] 2.1 Derive each leg's mount position and angle from the upstream STL files (or measurements) into `core/movement/body_geometry`, with a golden file the desktop legs pane reads (D3)
- [x] 2.2 Body pose (yaw, pitch, roll, translation) with planted feet in the player, interpolating the pose rather than the feet, with the rate limit along the pose path (D1); yaw replaces `twistMm`; host tests that planted feet stay put through a rotation and that the tick budget holds
- [x] 2.3 Measure the body's underside below the coxa pivots from upstream's STLs (its lowest point: the Coxa Horn Connectors and coxa side plates under the pivots, not `Frame Bottom.stl`, 15.75 mm higher) into `body_geometry.h` and `test/golden/body_geometry.txt` (D3); the support check counts a grounded body as supported
- [x] 2.4 Hold and unfold in the player and `body.cpp` (D1): ball holds in Perform, any request but Sleep unfolds first, Sleep goes straight to Sleep; host tests for leaving the ball by Walk, by Stand and by another gesture, and for Sleep from the hold with every intermediate target reachable and in range
- [x] 2.5 Script dance, attack (front pair, the strike's foot speed limit raised within the joint budget) and ball with its unfold (D6, D2); remove the stale comment in `gesture.cpp`; host tests for every keyframe at both height extremes, the support margin of attack's four planted feet, and the strike's duration under the selected servo profile
- [x] 2.6 Regenerate `test/golden/gestures.txt` (`SPOODER_WRITE_GOLDEN=1 mise run test`) and the handheld's gesture table (`go generate ./internal/gestures` in `desktop/handheld`); the handheld's gesture overlay shows the three animated, and its screenshot in `docs/images/handheld-gestures.png` is redrawn
- [ ] 2.7 Rehearse all five on the virtual robot; then on the supported robot, attack and ball last; before ball is rehearsed on the robot, measure the underside's height below the coxa pivots on the robot (the STLs give −24.2 mm by one reading of the femur shaft's place and −44.0 mm by the other, `hardware/aecert-hexapod-v1/README.md`; about −29.0 mm if the Coxa Horn Connector's wedge is fitted pointing down; and whether the coxa horn's screw head reaches lower is not modelled) and set `body_geometry::UNDERSIDE_Z` to it, which ball's heights follow
- [ ] 2.8 Update the skills, readme controls and changelog
