blackfyre/spooder/openspec/changes/add-handheld-controller/tasks.md

# Tasks

## 1. The mapping

- [x] 1.1 Add `test/golden/gamepad_mapping.txt` (design D2: input steps and the expected desired state after each, covering the gamepad-control scenarios, the dead-zone edge, the diagonal clamp, steer and crab with reverse mirroring, gait wrap, dial limits, both 1 s combos and a 0.5 s release, the gesture layer and a reconnect) and a host test `test/test_gamepad_mapping_golden` that runs `core/gamepad_mapping` over it; list it where `mise run test-sources` expects. Verify `mise run test` passes, and that changing one expected value in a scratch copy of the file makes the test fail.
- [x] 1.2 Create the nested module `desktop/handheld` (D1: `go.mod` with `replace github.com/blackfyre/spooder/desktop => ../`; gabagool and go-sdl2 join it in task 4.2) and `internal/padmap` (D2): the line-for-line port of `gamepad_mapping` and the handheld layer. Verify with `go test ./internal/padmap` in `desktop/handheld` that a package importing `desktop/internal/protocol` builds (else take D1's fallback and record it), that the port matches every step of `test/golden/gamepad_mapping.txt`, and that the handheld layer meets each scenario of the `handheld-controller` input-mapping requirement (Start in Sleep and Y then requesting Stand, Start, the L2 layer at 16383 and 16385, Select + Start toggling the e-stop with no mode change, Select + Y held 1 s and 0.5 s, Select released before Start and before Y with no mode request or Sleep toggle, at that moment or when the button is released, no Calibrate from any combination, SDL axis scaling at −32768, 0 and 32767).

## 2. Link, leaving and WiFi (hardware-free)

- [x] 2.1 Add `internal/udplink` (D3): one connected socket per run, the 150 ms start-up wait, command frames every 20 ms with rising sequence numbers, the receiver's validation, and the link-quality counts. Verify with `go test ./internal/udplink` against a loopback listener: no datagram in the first 150 ms; 45 to 55 datagrams in the next second, all from one source port, each one valid command frame with the sequence rising by one; each case of the received-frames requirement counted invalid (bad CRC, one extra byte, two frames, a command frame, a calibration set frame, and a valid frame from another socket dropped without reaching the receiver); the loss, late, wrap and gap-or-restart scenarios of the link-quality requirement (a jump from 14 to 200 after 500 ms of silence counts nothing, and the next frames count as in order); and the per-type freshness of the drive-screen requirement (telemetry 10, diagnostics 14, telemetry 13, telemetry 9 leaves telemetry 13 shown; telemetry 10, then 600 ms of pose and diagnostics only, then telemetry 140 shows telemetry 140).
- [x] 2.2 Add `internal/app` (D4, D5): the run loop without SDL (input in, frames out, the screen model), the leave state machine and its three actions. Verify with `go test ./internal/app` and a fake clock and link: Menu requests Sleep at once and completes on two newer telemetry frames in a row reporting Sleep, and on output off, but not on one, not on a Sleep frame older than the newest taken before the press, and not on a newer Sleep frame followed by a Walk frame; Y, Start and a stick during the wait leave Sleep requested, and Select + Start still toggles the e-stop; with no telemetry it completes at 3 s and not at 2.9 s; a second press during a leave is ignored; a short Power press runs the suspend action and returns to driving with Sleep requested, the fake runner showing power save restored to `on` before the suspend script and set `off` after it; a long press runs the power-off action after power save is restored; `ParseFlags` and `Start` without `--device` run no WiFi step and no address check and use `--addr`; the screen model marks the robot's values stale after 500 ms without telemetry and names faults.
- [x] 2.3 Add `internal/wlan` (D6, D7): the address check with one renewal, the join message's content, power-save read, off and restore, and the signal level (from `/proc/net/wireless`, or `iw dev wlan0 link` where it has none). Verify with `go test ./internal/wlan` and a fake runner and files: 192.168.4.2 runs no `udhcpc`; 192.168.0.23 runs `udhcpc -i wlan0 -n -q -t 5` once, then passes or yields the join message naming the current network; power save `on` is turned off and restored to `on`, `off` stays `off`; a missing `wlan0` line reads as unknown.

## 3. The virtual bridge

- [x] 3.1 Add `--wifi-bridge [ADDR:]PORT` to `tools/virtual-robot` (D10), built from `core/wifi_drive/handheld_controller`, `relay_queue` and `core/gamepad_mapping`, refusing `--bridge-pty`, `--stepped` and `--speed`, with the `estop` command ORed in and session start and end on standard output. Verify `mise run virtual-robot` builds with no warning in Spooder's sources, `mise run lint` passes, and `--wifi-bridge 0 --stepped` exits with an error naming the conflict.
- [x] 3.2 Add `desktop/handheld/e2e` (D11), skipped when the virtual robot is not built, and run it from `mise run e2e`. Verify `mise run e2e` passes with each scenario of the virtual-robot delta (drive to Stand with telemetry, pose and diagnostics received; Walk without a counter change stays Sleep; quiet for 200 ms ends the session and stops the relay; 500 datagrams sent at once and then silence end the session within 190 ms of the last one; a 1 s flood as fast as one socket can send leaves telemetry arriving at 8 to 12 frames a second, and the session end it is followed by reports a longest interval between tick starts of at most 40 ms (twice the tick, for host scheduling jitter; a 100 ms stall fails it); a second sender ignored) and, through `internal/app` started by `ParseFlags` and `Start` with `--addr`, Y standing the robot and Start walking it, Menu leaving only after Sleep is confirmed, and a new socket's session starting in Sleep.

## 4. The pak

- [x] 4.1 Add `desktop/handheld/third_party/gabagool-power-hook.patch` (D5: `Options.PowerButtonHook func(long bool)`, called instead of the suspend script and the power-off command when set) and `mise run handheld-fork` (download v2.26.6 with Go's checksum check, copy to `build/handheld/gabagool`, `git apply --check`, then apply). Verify the task runs twice in a row without error, that `grep` finds the hook in the patched `pkg/gabagool/internal/power.go`, and that `go vet ./...` in the patched copy passes.
- [x] 4.2 Add `desktop/handheld/cmd/spooder-handheld` (D4 to D7): flags `--device` and `--addr`, gabagool with `IsNextUI` and the hook only with `--device`, the SDL controller table, the drive screen, the join and leave messages, signal handling with power-save restore; and `desktop/handheld/pak/launch.sh` (D6). Add `mise run handheld-build` (amd64 to `build/handheld/amd64/spooder-handheld`), `mise run handheld-test` (gofmt, go vet, staticcheck, go test) and `desktop/handheld/scripts/check-deps.sh`; pin gabagool v2.26.6 and go-sdl2 v0.4.40 in the nested `go.mod`, with the replace to the patched gabagool, after reading their changelogs. Verify both tasks pass, and a Go test that runs `launch.sh` with `sh` and stub `iw` and binary on `PATH` shows power save restored to `on` after the stub binary exits 1 and after it is killed with SIGTERM.
- [x] 4.3 Add `desktop/handheld/build/Containerfile` and `mise run handheld-build-device` and `mise run handheld-package` (D8: bullseye arm64 by digest, Go 1.27.1 by checksum and checked against `mise.toml`, rootless Podman, `check-glibc.sh`, `libSDL2_gfx` in `lib/`, the zip). Verify `mise run handheld-package` produces `build/handheld/Spooder.pak.zip` holding `Spooder.pak/launch.sh`, `Spooder.pak/spooder-handheld` and `Spooder.pak/lib/libSDL2_gfx-1.0.so.0`; that `file` reports the binary as ARM aarch64; that `check-glibc.sh` passes on it, and, with a stub `readelf` on `PATH`, passes AArch64 with GLIBC_2.31 and fails AArch64 with GLIBC_2.34 and X86-64 with GLIBC_2.17; and that `mise run handheld-build-device` fails when the Go version in the Containerfile differs from `mise.toml`'s.
- [x] 4.4 Add a `handheld` job to `.github/workflows/ci.yml` (D12: the SDL2 packages, `handheld-test`, `handheld-build`; actions pinned by SHA as the other jobs) and make `e2e` depend on `handheld-fork`. Verify the workflow parses (`python -c "import yaml,sys; yaml.safe_load(open(sys.argv[1]))" .github/workflows/ci.yml`), every `uses:` line in it is pinned to a 40-character SHA, and `mise run e2e` passes from a clean `build/handheld`.
- [x] 4.5 Add the driving-view page (D2, D4): Select + X in the handheld layer, masked like Start and Y, and the drive screen's second page drawing the newest pose frame from a chase camera behind the robot, 45° down, in perspective, through `desktop/internal/legview`. Verify with `go test` in `desktop/handheld` that Select + X switches the page in both release orders without changing the stride and X alone still toggles it; that the screen model places a pose frame's set legs, leaves unset ones at their pivots and marks the pose stale after 500 ms; that the layout test fits the page's well and cells and the camera test places the robot in front of the camera, the front above the rear; and, in the e2e, that the walking virtual robot's pose places every leg and Select + X shows the page.

## 5. Documentation

- [x] 5.1 Update `desktop/CLAUDE.md` (the nested module, its packages and rules), `tools/CLAUDE.md` (`--wifi-bridge`), the `spooder-hardware-check` skill (installing `Spooder.pak` at `Tools/tg5040/` on the SD card, joining `spooder-drive-XXXX` in NextUI's WiFi settings, the controls, leaving, the on-device checks), the root `CLAUDE.md` command list, `Readme.md` and `CHANGELOG.md` under Unreleased. Verify by reading them against the spec deltas, and that `grep` finds `Tools/tg5040/Spooder.pak` in the skill and `--wifi-bridge` in `tools/CLAUDE.md`.

## 6. Gates

- [x] 6.1 Run every gate from the worktree: `mise run lint`, `mise run test`, `mise run build` (with and without `--serial`), `mise run build-bridge`, `mise run desktop-test`, `mise run desktop-build`, `mise run e2e`, `mise run handheld-test`, `mise run handheld-build` and `mise run handheld-package`. Verify all pass.

## 7. On the handheld and the boards

- [ ] 7.1 With the bridge in WiFi drive and the robot board on USB power with no servos, install `Spooder.pak` on the TrimUI. Verify: `ldd` on the device finds every library of `spooder-handheld` with the pak's `LD_LIBRARY_PATH`; launched while on another network, the pak runs `udhcpc` once and then names `spooder-drive-XXXX`; after joining, it reaches the drive screen and the bridge's link page shows the handheld in control; telemetry, pose and diagnostics arrive at about 10 per second each with zero invalid and lost frames over a minute; each control of the input-mapping requirement changes the requested state on the screen as specified, Select + X shows the driving view with the legs following the robot's pose, and the sticks and L2/R2 read full scale; `iw dev wlan0 get power_save` reads off while the pak runs, the previous value after Menu and after `kill` of the binary, and off again after a suspend through Power and its resume; Menu, a short Power press and a 2 s Power hold each request Sleep and act only after telemetry reports it.

## 8. On the robot

- [ ] 8.1 With the robot assembled on the bench supply, drive it from the handheld through the bridge. Verify: Y stands it and Start walks it, the sticks steer and crab as with the gamepad, gestures play from the L2 layer; Select + Start stops the servos at once and Select + Y held 1 s clears the fault once the e-stop is released; Menu while walking sits the robot down before the pak exits; quitting the binary by `kill` makes the robot sleep within about 200 ms; signal level and link counts on the screen stay plausible across the room.
