blackfyre/spooder/openspec/changes/add-wifi-drive/tasks.md

# Tasks

## 1. Hardware-free logic in the core

- [x] 1.1 Add `core/wifi_drive/drive_mode.{h,cpp}` (D1): the boot decision from the setup request and the switch level (setup wins; open is Bluetooth drive, closed is WiFi drive), and the switch notice (shown once the level has differed from the boot mode for 100 ms, cleared once it has matched for 100 ms); list it in the root `platformio.ini`. Verify with a new `test/test_drive_mode` via `mise run test`: all four boot combinations, a 99 ms and a 100 ms change, bounce shorter than 100 ms, and the notice clearing after the switch returns.
- [x] 1.2 Add `core/wifi_drive/handheld_controller.{h,cpp}` (D3, D4): the 8-per-window budget, datagram validation (length, version, type, CRC), the sender lock, the sequence rule (newer, stale, and a jump ending the session), the 150 ms liveness, the relay target (the locked sender while live, none otherwise), session baselines, translation of the three counters with the mode and gesture they carry, Sleep until the first mode request of a session, pass-through of the analogue fields, the controller-connected flag, the e-stop flag kept through a lapse, and outcome counts; list it in `platformio.ini`. Verify with a new `test/test_handheld_controller` via `mise run test` covering every scenario of the `wifi-drive` spec's datagram, single-handheld, liveness, counter-translation and e-stop requirements, including a restarted app whose counters start at zero (no bridge counter change) from a new port, after a lapse, and from the same port with sequence 0 after 200 within 150 ms (session ends, no counter change), sequence wrap from 255 to 0, six losses (140 ms, live) and a 149 ms and a 151 ms gap, the ninth datagram of a window (rate-limited) and the first of the next window (accepted), the controller-connected flag cleared while live, the relay target before, during and after a session and after a handover, and a 22-byte datagram holding a valid frame plus one byte (discarded).
- [x] 1.3 Give `protocol::Decoder` the raw bytes of the frame `next()` has just returned, and give `access_point` the WiFi drive network name (`spooder-drive-` + 4 MAC digits) beside the setup one (D2, D3). Verify via `mise run test` with new cases in `test/test_protocol` (the raw bytes of each frame type in `test/golden/protocol_v3.txt` equal the golden bytes, including after a garbage prefix) and `test/test_setup_entry`, where the access-point tests live (both names from one MAC, the size limit), and that `test/test_protocol_golden` still passes unchanged.
- [x] 1.4 Extend `core/status/status_screen` for WiFi drive (D6): the drive page's controller field, the link page's network, password and handheld lines, and `SWITCH MOVED: RESTART` in the status strip in the warning tone. Verify with new cases in `test/test_status_screen` via `mise run test` (each status-display scenario of this change, every new line within its field width, the three handheld states, no stick mode in WiFi drive, the notice beside one fault in the fault's tone, the notice left out with every named fault and the source conflict latched while each fault stays whole, Bluetooth drive pages unchanged), and `mise run lint`.
- [x] 1.5 Add `core/wifi_drive/relay_queue.{h,cpp}` (D5): a ring of 8 raw frames that never waits, dropping and counting a frame when full, and cleared at a session's end; list it in `platformio.ini`. Verify with a new `test/test_relay_queue` via `mise run test`: frames come out byte for byte and in order for each frame type in `test/golden/protocol_v3.txt`, the ninth frame is dropped and counted while the first eight survive, and a clear leaves nothing for the next take.

## 2. Bridge firmware

- [x] 2.1 Read GPIO32 with the pull-up in `app_main` before BTstack starts, and add the WiFi drive boot path (D1, D5): the build banner first, free the Bluetooth controller memory, start Arduino, the display with the logo and the start-up log beginning with `Build <id>`, the left-button hold into setup mode, the page button, and `robot_link` with the handheld controller as its source (the link task judges liveness and ORs the e-stop flags every period). Verify `mise run build-bridge` passes with its image size check, and that `nm` on the built `.elf` shows the WiFi drive start function reachable from `app_main` while the Bluetooth drive path is unchanged (`git diff` of `bridge.cpp` limited to the switch notice).
- [x] 2.2 Add the WiFi drive access point (D2: `spooder-drive-XXXX`, a password kept under `drive_pass`, channel 1, one station) and the UDP task (D3, D5: port 52040 at priority 2, stamps on receipt, at most 8 datagrams per window with `CONFIG_LWIP_UDP_RECVMBOX_SIZE=6` pinned in `sdkconfig.defaults`, outcome counts, the relay from `relay_queue` to `relayTarget`, nothing while no session is live). Verify `mise run build-bridge` and `mise run lint` pass, and that `grep` finds no Bluepad32 or BTstack call on the WiFi drive path.
- [x] 2.3 Wire the screen in both drive modes (D6): the drive mode, handheld state, network and password into `status_screen::Inputs`, GPIO32 sampled for the switch notice, and the WiFi drive pages in `tools/bridge-screenshots`. Verify `mise run build-bridge` and `mise run bridge-screenshots` pass, the existing Bluetooth drive images are unchanged, and the new WiFi drive images show the network and password.

## 3. Desktop probe

- [x] 3.1 Add `desktop/cmd/spooder-wifi-probe` (D7) on `internal/protocol`: command frames at 50 Hz to an address and port (default 192.168.4.1:52040), a mode to request once, the e-stop flag and when to clear it, one fault clear after a delay (one fault-clear counter change), a pause to let liveness lapse, a flood rate of extra valid datagrams, and a per-second summary of the robot frames received, with an error count for datagrams that are not exactly one valid robot frame or that hold a command frame. Verify with a Go test against a UDP listener on the loopback address that the probe sends decodable version 3 command frames at about 50 per second with increasing sequence numbers and one mode-request change, that the e-stop flag clears and the fault-clear counter changes once at their delays, that the flood rate adds the extra datagrams, and that the summary counts a relayed golden telemetry frame and counts a command frame and a frame with one extra byte as errors, and that `mise run desktop-test` and `mise run desktop-build` pass.

## 4. Documentation

- [x] 4.1 Update `firmware/bridge/CLAUDE.md` (the third boot path, the radio rule as never both, the UDP task), `core/CLAUDE.md` (`wifi_drive/`), `desktop/CLAUDE.md` (the probe), the `spooder-firmware-shape` skill (bridge tasks and boot paths), the `spooder-hardware-check` skill (wiring the switch, joining WiFi drive, the probe checks), `Readme.md` and `CHANGELOG.md` under Unreleased. Verify by reading them against the spec deltas, and that `grep` finds GPIO32 in `firmware/bridge/CLAUDE.md` and the skill, and port 52040 in the skill.

## 5. Gates

- [x] 5.1 Run every gate from the worktree: `mise run lint`, `mise run test`, `mise run build` (with and without `--serial`), `mise run build-bridge`, `mise run desktop-test`, `mise run desktop-build` and `mise run e2e`. Verify all pass.

## 6. On the boards

- [ ] 6.1 Confirm on the fitted T-Display v1.1 that GPIO32 is free on the header, then wire a latching switch between it and ground. Verify on the bridge console and screen, in WiFi drive as in Bluetooth drive: the console's first line is `spooder bridge: build <id>` and the start-up log begins with `Build <id>`; the status screen appears within 3 s of power-up; the link page shows about 50 frames per second accepted by the robot from the first refresh and while switching pages; holding GPIO35 during the logo shows the status screen at once with the e-stop. Then: switch open (and the wire unplugged) boots Bluetooth drive and a gamepad connects; switch closed boots WiFi drive, `spooder-drive-XXXX` is visible and no gamepad connects; moving the switch while running shows the restart notice within a refresh and changes nothing else; holding the left button during the logo enters setup mode in both positions, and leaving it returns to the switch's mode.
- [ ] 6.2 With the robot on the bench supply, join a laptop to the WiFi drive network and run `spooder-wifi-probe`. Verify: the probe receives telemetry at about 10 Hz; Stand makes the robot stand; pausing the probe makes the robot sleep and the screen show no handheld within about 150 ms plus the robot's own response; restarting the probe gives no fault clear and no mode change until its first mode request; the probe's error count stays at zero and it counts no command frames; with a flood of 1,000 datagrams per second the link page still shows about 50 frames per second accepted by the robot, the bridge console's counts of all outcomes together (rate-limited included) grow by at most 4,000 datagrams per 10 s report and its rate-limited count stays at zero (the UDP task reads only within the budget), and stopping the probe still makes the robot sleep; after the e-stop (button or flag) is released, the emergency-stop fault stays latched and the servos stay off until the probe sends a fault clear; a second probe on another port is ignored while the first runs; the GPIO35 button and the probe's e-stop flag each stop the servos.
