blackfyre/spooder/openspec/changes/archive/2026-10-22-selectable-text-panes/tasks.md

# Tasks

## 1. Line identity and the text pane

- [x] 1.1 Number log and frame lines in the session (D2); session test across the cap
- [x] 1.2 Add the `textPane` widget: hold and follow (D3), the dropped-lines adjustment, selection by pointer and Shift+click, selection painting in the faded accent, copied text assembly (D1); headless tests
- [x] 1.3 Use it for the debug log and the frames pane

## 2. Copy shortcut and verification

- [x] 2.1 Ctrl+C / Cmd+C copies the shown pane's selection and never acts as the height key (D4); window tests
- [x] 2.2 Changelog; `desktop-test`, `desktop-build` and `e2e` pass
