blackfyre/spooder/firmware/bridge/main/main.c

// SPDX-License-Identifier: Apache-2.0
// Copyright 2019 Ricardo Quesada
// http://retro.moe/unijoysticle2

#include "sdkconfig.h"

#include <stddef.h>

// BTstack related
#include <btstack_port_esp32.h>
#include <btstack_run_loop.h>
#include <btstack_stdio_esp32.h>

// Bluepad32 related
#include <arduino_platform.h>
#include <uni.h>

// Spooder: the setup-mode and WiFi drive boot paths (setup_mode.cpp,
// wifi_drive.cpp).
#include "setup_mode.h"
#include "wifi_drive.h"

//
// Autostart
//
#if CONFIG_AUTOSTART_ARDUINO
void initBluepad32()
{
#else
int app_main(void)
{
#endif // !CONFIG_AUTOSTART_ARDUINO
  // Spooder: the boot mode is decided once, before either radio starts.
  // Setup mode and WiFi drive skip BTstack and Bluepad32 entirely, so
  // Bluetooth never starts; the bridge leaves either only by restarting.
  enum bridge_boot_mode boot = bridge_boot_mode_select(setup_mode_requested());
  if (boot != BRIDGE_BOOT_BLUETOOTH)
  {
    if (boot == BRIDGE_BOOT_SETUP)
      setup_mode_start();
    else
      wifi_drive_start();
#if !CONFIG_AUTOSTART_ARDUINO
    return 0;
#else
    return;
#endif
  }

  // hci_dump_open(NULL, HCI_DUMP_STDOUT);

// Don't use BTstack buffered UART. It conflicts with the console.
#ifndef CONFIG_ESP_CONSOLE_UART_NONE
#ifndef CONFIG_BLUEPAD32_USB_CONSOLE_ENABLE
  btstack_stdio_init();
#endif // CONFIG_BLUEPAD32_USB_CONSOLE_ENABLE
#endif // CONFIG_ESP_CONSOLE_UART_NONE

  // Configure BTstack for ESP32 VHCI Controller
  btstack_init();

  // hci_dump_init(hci_dump_embedded_stdout_get_instance());

  // Must be called before uni_init()
  uni_platform_set_custom(get_arduino_platform());

  // Init Bluepad32.
  uni_init(0 /* argc */, NULL /* argv */);

  // Does not return.
  btstack_run_loop_execute();
#if !CONFIG_AUTOSTART_ARDUINO
  return 0;
#endif // !CONFIG_AUTOSTART_ARDUINO
}
