blackfyre/spooder/firmware/bridge/main/bridge.cpp

// Gamepad bridge: a Bluepad32 gamepad becomes command frames to the robot,
// and the robot's telemetry becomes the status screen.
//
// Bluepad32 (BTstack) runs on core 0. setup()/loop() run on core 1, with the
// link task above loop() so screen redraws never delay command frames.
#include "sdkconfig.h"

#include <Arduino.h>
#include <Bluepad32.h>

#include "display.h"
#include "gamepad_mapping/gamepad_mapping.h"
#include "gamepad_mapping/rumble.h"
#include "identity/build_identity.h"
#include "link.h"
#include "setup/setup_entry.h"
#include "status/page_button.h"
#include "setup_mode.h"
#include "wifi_drive.h"
#include "wifi_drive/drive_mode.h"

// The mapping's button bits are Bluepad32's.
static_assert(gamepad_mapping::BUTTON_A == BUTTON_A && gamepad_mapping::BUTTON_B == BUTTON_B &&
                  gamepad_mapping::BUTTON_X == BUTTON_X && gamepad_mapping::BUTTON_Y == BUTTON_Y &&
                  gamepad_mapping::BUTTON_L1 == BUTTON_SHOULDER_L && gamepad_mapping::BUTTON_R1 == BUTTON_SHOULDER_R &&
                  gamepad_mapping::BUTTON_THUMB_L == BUTTON_THUMB_L &&
                  gamepad_mapping::BUTTON_THUMB_R == BUTTON_THUMB_R,
              "button bits must match Bluepad32");
static_assert(gamepad_mapping::DPAD_UP == DPAD_UP && gamepad_mapping::DPAD_DOWN == DPAD_DOWN &&
                  gamepad_mapping::DPAD_RIGHT == DPAD_RIGHT && gamepad_mapping::DPAD_LEFT == DPAD_LEFT,
              "d-pad bits must match Bluepad32");
static_assert(gamepad_mapping::MISC_HOME == MISC_BUTTON_SYSTEM && gamepad_mapping::MISC_BACK == MISC_BUTTON_SELECT,
              "misc bits must match Bluepad32");

// One controller slot; a second controller is refused.
static ControllerPtr controller = nullptr;
static gamepad_mapping::Mapper mapper;
static rumble::State rumbleState;
// The left button (GPIO0, active low, board pull-up): held during the logo,
// it restarts the bridge into setup mode; once the status screen is shown, a
// short press shows the next page. Never read at reset: GPIO0 is a strapping
// pin, and holding it then enters the ROM download mode.
constexpr int SETUP_BUTTON_PIN = 0;
static setup_entry::Hold setupHold;
static page_button::State pageButton;
// The drive mode switch, sampled for the restart notice only.
static drive_mode::Notice switchNotice;

static void onConnected(ControllerPtr ctl)
{
  if (controller != nullptr)
  {
    Console.printf("second controller refused: %s\n", ctl->getModelName().c_str());
    ctl->disconnect();
    return;
  }
  controller = ctl;
  Console.printf("controller connected: %s\n", ctl->getModelName().c_str());
}

static void onDisconnected(ControllerPtr ctl)
{
  if (ctl != controller)
    return;
  controller = nullptr;
  Console.println("controller disconnected");
}

static gamepad_mapping::PadState readPad()
{
  gamepad_mapping::PadState pad = {};
  if (controller == nullptr || !controller->isConnected() || !controller->isGamepad())
    return pad; // not connected
  pad.connected = true;
  pad.axisX = controller->axisX();
  pad.axisY = controller->axisY();
  pad.axisRX = controller->axisRX();
  pad.axisRY = controller->axisRY();
  pad.buttons = controller->buttons();
  pad.dpad = controller->dpad();
  pad.misc = controller->miscButtons();
  return pad;
}

void setup()
{
  char banner[build_identity::BANNER_SIZE];
  build_identity::banner(banner, sizeof(banner), "bridge", build_identity::ID);
  Console.printf("%s", banner);
  Console.printf("spooder bridge, Bluepad32 %s\n", BP32.firmwareVersion());
  display::setup(build_identity::ID); // logo first
  pinMode(SETUP_BUTTON_PIN, INPUT_PULLUP);
  robot_link::start();
  display::bootMessage("Robot link: UART1 26/27");
  BP32.setup(&onConnected, &onDisconnected);
  // No virtual devices (mouse emulation from touchpads).
  BP32.enableVirtualDevice(false);
  display::bootMessage("Bluetooth: Bluepad32");
  display::bootMessage("Ready!");
  display::bootMessage("Waiting on gamepad...");
}

void loop()
{
  BP32.update();
  uint32_t now = millis();

  if (display::showingLogo())
  {
    bool pressed = digitalRead(SETUP_BUTTON_PIN) == LOW;
    if (setup_entry::update(setupHold, pressed, now))
    {
      Console.println("setup button held: restarting into setup mode");
      setup_mode::restartIntoSetup();
    }
    display::holdLogo(setup_entry::held(setupHold));
  }
  else if (display::statusShown())
  {
    page_button::update(pageButton, digitalRead(SETUP_BUTTON_PIN) == LOW, now);
  }

  gamepad_mapping::PadState pad = readPad();
  gamepad_mapping::Desired desired = gamepad_mapping::update(mapper, pad, now);
  robot_link::setDesired(desired);
  robot_link::Status link = robot_link::status();

  // Rumble on faults, the e-stop, link loss and refused gestures.
  rumble::Inputs feel = {now,
                         pad.connected,
                         link.telemetryFresh,
                         link.telemetry.faults,
                         link.emergencyStop,
                         desired.gestureRequestCounter,
                         desired.gesture,
                         link.telemetry.gesture};
  rumble::Request r = rumble::update(rumbleState, feel);
  if (r.play && controller != nullptr)
    controller->playDualRumble(0, r.durationMs, r.weak, r.strong);

  uint8_t battery = pad.connected ? controller->battery() : 0; // 0: not reported
  display::Drive drive = {};
  drive.mode = drive_mode::Mode::Bluetooth;
  drive.switchNotice = drive_mode::update(switchNotice, drive_mode::Mode::Bluetooth, drive_switch_closed(), now);
  display::update(now, pad.connected, battery, pageButton.page, desired, link, drive);

  // Yield so the idle task runs (watchdog) between gamepad updates.
  delay(1);
}
