blackfyre/spooder/core/movement/movement_command.h

#ifndef MOVEMENT_COMMAND_H
#define MOVEMENT_COMMAND_H

// The request a controller hands to movement. Movement decides whether and
// when to act on it; a command never sets movement state directly.
// Hardware-free: compiled for the board and for host tests.
#include <stdint.h>
#include "gait.h"
#include "vectors.h"

enum class RequestedMode : uint8_t
{
  Stand,
  Walk,
  Sleep,
  Calibrate,
};

enum class StrideMode : uint8_t
{
  Dynamic, // stride and rotation length scale with input magnitude
  Fixed,   // constant stride and rotation length; input sets direction only
};

// The speed dial the robot and every controller start at (the gamepad
// mapping, the portal, the bridge, the handheld, the desktop calibrator, the
// WiFi probe). The Go copies hold 44, which gamepad_mapping.cpp pins.
constexpr uint8_t START_SPEED = 44;

struct MovementCommand
{
  RequestedMode mode = RequestedMode::Stand;
  Vector2 translate;         // magnitude 0..100
  float rotate = 0;          // -100..100
  float height = 0;          // body height dial, 0..100; higher raises the body
  float speed = START_SPEED; // speed dial, 0..100
  // Index into gait::Gait; unknown values are ignored.
  int gait = static_cast<int>(gait::START_GAIT);
  StrideMode stride = StrideMode::Dynamic;
  uint32_t issuedAtMs = 0; // millis() when the controller produced the command
  // Gesture requests: each change of gestureSeq requests `gesture` (a
  // gesture::Gesture id) once. The body takes the first value it sees as the
  // baseline, so a restart never replays an old request.
  uint8_t gesture = 0;
  uint32_t gestureSeq = 0;
  // Advances with every explicit mode request (the source in control's), so
  // movement can tell a new Stand request from a continuing one.
  uint32_t modeRequestSeq = 0;
};

#endif // MOVEMENT_COMMAND_H
