blackfyre/spooder/core/protocol/protocol.h

#ifndef PROTOCOL_H
#define PROTOCOL_H

// The link between the robot and its front-ends (the gamepad bridge on UART1,
// a computer on USB): frame layout, CRC, encoders and an incremental decoder,
// shared by both firmwares. test/golden/protocol_v3.txt pins the encoding.
// Hardware-free: compiled for both boards and for host tests.
//
// Frame:
//   0      start marker 0xA5
//   1      protocol version
//   2      type (1 = command, 2 = telemetry, 3 = calibration set,
//          4 = calibration report, 5 = pose)
//   3      sequence number (wraps)
//   4      payload length N (fixed per type and version)
//   5      payload, N bytes, little-endian
//   5+N    CRC-16/CCITT-FALSE over bytes 1..4+N, little-endian
#include <stdint.h>

namespace protocol
{

constexpr uint8_t START = 0xA5;
constexpr uint8_t VERSION = 3;

enum class FrameType : uint8_t
{
  Command = 1,
  Telemetry = 2,
  CalibrationSet = 3,
  CalibrationReport = 4,
  Pose = 5,        // robot to every link (the bridge ignores it)
  Diagnostics = 6, // robot to every link (the bridge ignores it)
};

constexpr int HEADER_SIZE = 5;
constexpr int CRC_SIZE = 2;
constexpr int COMMAND_PAYLOAD_SIZE = 14;
constexpr int TELEMETRY_PAYLOAD_SIZE = 32;
constexpr int CALIBRATION_JOINTS = 18;
constexpr int CALIBRATION_JOINT_SIZE = 7;
constexpr int CALIBRATION_SET_PAYLOAD_SIZE = 9;
constexpr int CALIBRATION_REPORT_PAYLOAD_SIZE = 2 + CALIBRATION_JOINTS * CALIBRATION_JOINT_SIZE; // 128
constexpr int POSE_JOINT_SIZE = 6;
constexpr int POSE_PAYLOAD_SIZE = 2 + CALIBRATION_JOINTS * POSE_JOINT_SIZE; // 110
constexpr int DIAGNOSTICS_PAYLOAD_SIZE = 24;
constexpr int COMMAND_FRAME_SIZE = HEADER_SIZE + COMMAND_PAYLOAD_SIZE + CRC_SIZE;
constexpr int TELEMETRY_FRAME_SIZE = HEADER_SIZE + TELEMETRY_PAYLOAD_SIZE + CRC_SIZE;
constexpr int CALIBRATION_SET_FRAME_SIZE = HEADER_SIZE + CALIBRATION_SET_PAYLOAD_SIZE + CRC_SIZE;
constexpr int CALIBRATION_REPORT_FRAME_SIZE = HEADER_SIZE + CALIBRATION_REPORT_PAYLOAD_SIZE + CRC_SIZE;
constexpr int POSE_FRAME_SIZE = HEADER_SIZE + POSE_PAYLOAD_SIZE + CRC_SIZE;
constexpr int DIAGNOSTICS_FRAME_SIZE = HEADER_SIZE + DIAGNOSTICS_PAYLOAD_SIZE + CRC_SIZE;
constexpr int MAX_FRAME_SIZE = CALIBRATION_REPORT_FRAME_SIZE; // 135
static_assert(POSE_FRAME_SIZE <= MAX_FRAME_SIZE && DIAGNOSTICS_FRAME_SIZE <= MAX_FRAME_SIZE,
              "every frame fits the decoder buffer");

// Command flags.
constexpr uint8_t FLAG_CONTROLLER_CONNECTED = 1u << 0;
constexpr uint8_t FLAG_EMERGENCY_STOP = 1u << 1;

// Bridge to robot, every 20 ms: the complete desired state, never events.
struct Command
{
  uint8_t mode;                  // RequestedMode value
  int8_t translateX;             // -100..100
  int8_t translateY;             // -100..100, + = forward
  int8_t rotate;                 // -100..100
  uint8_t height;                // 0..100
  uint8_t speed;                 // 0..100
  uint8_t gait;                  // gait::Gait index
  uint8_t stride;                // StrideMode value
  uint8_t flags;                 // FLAG_*
  uint8_t clearCounter;          // incremented once per fault-clear request
  uint8_t modeRequestCounter;    // incremented on every explicit mode request
  uint8_t gesture;               // GESTURE_* id of the latest gesture request (0 = none)
  uint8_t gestureRequestCounter; // incremented on every gesture request
};

// Gesture ids (command gesture, telemetry gesture being played).
constexpr uint8_t GESTURE_NONE = 0;
constexpr uint8_t GESTURE_SAY_HI = 1;
constexpr uint8_t GESTURE_WIGGLE = 2;
constexpr uint8_t GESTURE_DANCE = 3;
constexpr uint8_t GESTURE_ATTACK = 4;
constexpr uint8_t GESTURE_BALL = 5;
constexpr uint8_t GESTURE_COUNT = 6; // ids 1..GESTURE_COUNT-1

// Sensor availability bits.
constexpr uint8_t SENSOR_TOF = 1u << 0;
constexpr uint8_t SENSOR_ATTITUDE = 1u << 1;

// Telemetry flags.
constexpr uint8_t TELEMETRY_SOURCE_CONFLICT = 1u << 0; // both links claim control: the robot sleeps
constexpr uint8_t TELEMETRY_USB_IN_CONTROL = 1u << 1;
constexpr uint8_t TELEMETRY_BRIDGE_IN_CONTROL = 1u << 2;
// The bridge link's state, on every link (the USB host's view of the bridge):
// a valid bridge frame within the link-gap time, and a gamepad on it.
constexpr uint8_t TELEMETRY_BRIDGE_LINK_UP = 1u << 3;
constexpr uint8_t TELEMETRY_BRIDGE_GAMEPAD = 1u << 4;
// Bench simulation: no servo moves; output and supply readings are modelled.
constexpr uint8_t TELEMETRY_SIMULATED = 1u << 5;

// Robot to every link, every 100 ms.
struct Telemetry
{
  uint8_t bodyMode; // body::Mode value
  uint8_t gait;
  bool outputsOn;
  uint16_t faults; // protection::Fault bits
  uint16_t voltageMv;
  uint16_t currentMa;
  uint16_t validFrames;     // command frames accepted (wraps)
  uint16_t discardedFrames; // frames rejected (wraps)
  uint8_t sensorsAvailable; // SENSOR_* bits; fields below are meaningful only when set
  uint16_t tofMm;
  uint8_t tofStatus;
  int16_t pitchCentideg;
  int16_t rollCentideg;
  uint8_t flags;   // TELEMETRY_* bits
  uint8_t gesture; // GESTURE_* id being played, 0 when none
  // The bridge link's decoder counts, on every link (bytes 23-26, reserved
  // and zero before; an older robot reports zero).
  uint16_t bridgeValidFrames;
  uint16_t bridgeDiscardedFrames;
};

// Calibration set flags and report joint flags.
constexpr uint8_t CALIBRATION_REVERSED = 1u << 0;

// Front-end to robot: the complete calibration wanted for one joint.
struct CalibrationSet
{
  uint8_t requestId; // a repeat on the same link is a retransmission
  uint8_t joint;     // 0..17, servo output order
  int16_t offsetCentideg;
  uint16_t pulse0Us;
  uint16_t pulse180Us;
  uint8_t flags; // CALIBRATION_* bits
};

enum class CalibrationResult : uint8_t
{
  Accepted = 0,
  Clamped = 1,  // accepted after clamping to the safe range
  Rejected = 2, // not in Calibrate, or output not allowed
  NoneYet = 3,  // no calibration set processed from this link
};

struct CalibrationJoint
{
  int16_t offsetCentideg;
  uint16_t pulse0Us;
  uint16_t pulse180Us;
  uint8_t flags; // CALIBRATION_* bits
};

// Robot to front-ends: the calibration table in effect, and the result of
// the last calibration set processed from the link it is sent on.
struct CalibrationReport
{
  uint8_t lastRequestId;
  uint8_t result; // CalibrationResult value
  CalibrationJoint joints[CALIBRATION_JOINTS];
};

// Pose flags.
constexpr uint8_t POSE_OUTPUTS_ON = 1u << 0;

struct PoseJoint
{
  int16_t commandedCentideg; // IK result, before the calibration offset
  int16_t servoCentideg;     // commanded + applied offset, before toPulse's 0-180 clamp
  uint16_t pulseUs;          // last pulse set for the output; 0 = never set
};

// Robot to every link, at 10 Hz: what the robot commands each joint.
struct Pose
{
  uint8_t flags;                        // POSE_* bits
  PoseJoint joints[CALIBRATION_JOINTS]; // servo output order
};

// Robot to every link, at 10 Hz: the robot's internals over the last
// telemetry window (five ticks), and its configured limits.
struct Diagnostics
{
  uint16_t motionSharePermille; // smallest share the joint speed budget allowed; 1000 = full
  uint16_t backstopTicks;       // ticks the output rate backstop held a joint back (wraps)
  uint16_t tickMaxUs;           // the control tick's longest working time
  uint16_t tickMeanUs;          // and its mean
  uint16_t averageCurrentMa;    // protection's average over its sustained window
  uint16_t tripCurrentMa;       // configured limits
  uint16_t sustainedCurrentMa;
  uint16_t minMv;
  uint16_t maxMv;
  uint16_t brownoutMv;
  uint16_t budgetDegPerS; // the servo profile's joint speed budget
  uint16_t ratedDegPerS;  // and its rated no-load speed (the backstop)
};

/**
 * @brief CRC-16/CCITT-FALSE (poly 0x1021, init 0xFFFF, no reflection).
 */
uint16_t crc16(const uint8_t *data, int length);

/**
 * @brief Writes a complete frame into @p out (at least the frame's size).
 * @return the number of bytes written
 */
int encodeCommand(const Command &c, uint8_t seq, uint8_t *out);
int encodeTelemetry(const Telemetry &t, uint8_t seq, uint8_t *out);
int encodeCalibrationSet(const CalibrationSet &c, uint8_t seq, uint8_t *out);
int encodeCalibrationReport(const CalibrationReport &r, uint8_t seq, uint8_t *out);
int encodePose(const Pose &p, uint8_t seq, uint8_t *out);
int encodeDiagnostics(const Diagnostics &d, uint8_t seq, uint8_t *out);

struct Frame
{
  FrameType type;
  uint8_t seq;
  Command command;                     // valid when type == Command
  Telemetry telemetry;                 // valid when type == Telemetry
  CalibrationSet calibrationSet;       // valid when type == CalibrationSet
  CalibrationReport calibrationReport; // valid when type == CalibrationReport
  Pose pose;                           // valid when type == Pose
  Diagnostics diagnostics;             // valid when type == Diagnostics
};

// Incremental decoder. Feed every received byte with push(), and after each
// one call next() until it returns false: the buffer holds a single frame of
// at most MAX_FRAME_SIZE bytes, so bytes pushed beyond that without next()
// give up the oldest candidate. A rejected candidate (bad version, type, length or
// CRC) is counted, and decoding resumes at the next start marker after its
// first byte, so a valid frame following garbage is never lost. An incomplete
// candidate is kept until its CRC can be checked, unless the line goes quiet:
// call idle() when no byte has arrived for longer than a frame takes to send,
// so a false start cannot hide a complete frame behind it.
// frameBytes() holds the raw bytes of the frame next() last returned (a
// copy, kept until next() returns another frame), so a relay passes frames
// on byte for byte without re-encoding them.
class Decoder
{
public:
  void push(uint8_t byte);
  bool next(Frame &out);
  void idle();

  uint32_t validFrames() const { return valid_; }
  uint32_t discardedFrames() const { return discarded_; }
  // The frame next() last returned, as received; 0 bytes before the first.
  const uint8_t *frameBytes() const { return frame_; }
  int frameLength() const { return frameLen_; }
  // Bytes held for a frame not yet complete (0 between frames).
  int pending() const { return len_; }

private:
  enum class Candidate
  {
    Invalid,
    Incomplete,
    Valid,
  };
  Candidate check(int at, int *total) const;
  void emit(int total, Frame &out);
  void drop(int count);
  void reject();

  uint8_t buf_[MAX_FRAME_SIZE] = {};
  int len_ = 0;
  uint8_t frame_[MAX_FRAME_SIZE] = {};
  int frameLen_ = 0;
  uint32_t valid_ = 0;
  uint32_t discarded_ = 0;
};

} // namespace protocol

#endif // PROTOCOL_H
