blackfyre/spooder/firmware/bridge/main/link.cpp

#include "link.h"

#include <Arduino.h>
#include "freertos/FreeRTOS.h"
#include "freertos/task.h"
#include "setup/portal_controller.h"
#include "wifi_drive/relay_queue.h"

namespace robot_link
{

constexpr int TX_PIN = 27;
constexpr int RX_PIN = 26;
constexpr uint32_t BAUD = 115200;
constexpr int ESTOP_PIN = 35; // right-hand button, active low, board pull-up
// The robot sends whole frames back to back, so a gap this long in received
// bytes never falls inside a frame: an incomplete candidate is a false start.
constexpr uint32_t RX_IDLE_MS = 10;
// More than one command period of bytes at full line rate (about 230 bytes
// per 20 ms), with room for a late link task.
constexpr int RX_BUFFER_SIZE = 1024;

static portMUX_TYPE lock = portMUX_INITIALIZER_UNLOCKED;
// Shared with loop(), guarded by lock.
static gamepad_mapping::Desired desired;
static protocol::Telemetry telemetry;
static bool haveTelemetry;
static uint32_t telemetryAtMs;
static bool emergencyStop;
static uint32_t validFrames;
static uint32_t discardedFrames;
static bool haveReport;
static uint32_t reportAtMs;
static protocol::CalibrationReport report;
static supply_band::Limits supplyLimits;
// Setup mode only. portalMode and handheldMode are set before the task
// starts and never change afterwards.
static bool portalMode;
static portal_controller::Controller portal;
static calibration_sync::Sync calibration;
// WiFi drive only.
static bool handheldMode;
static handheld_controller::Controller handheld;
static relay_queue::Queue relay;

static protocol::Decoder decoder;

static void initialDesired()
{
  desired = {};
  desired.mode = RequestedMode::Sleep;
  desired.speed = START_SPEED;
  desired.gait = gamepad_mapping::START_GAIT;
  desired.controllerConnected = false;
}

// Toggles on each press. Sampled every command period; a press is a high to
// low change after two high samples, so contact bounce cannot toggle twice.
static void sampleEmergencyStop()
{
  static uint8_t history = 0xFF;
  history = (uint8_t)((history << 1) | (digitalRead(ESTOP_PIN) ? 1 : 0));
  if ((history & 0x07) == 0x06)
  {
    portENTER_CRITICAL(&lock);
    emergencyStop = !emergencyStop;
    portEXIT_CRITICAL(&lock);
  }
}

static void sendCommand(uint8_t seq)
{
  portENTER_CRITICAL(&lock);
  // In setup mode the portal's heartbeat is judged here, every period, so a
  // stalled web server cannot keep the controller connected; in WiFi drive
  // the handheld's liveness, so a stalled UDP task cannot either. The time
  // is taken inside the lock, so no poll or datagram can be stamped after it.
  bool stop = emergencyStop;
  if (portalMode)
    desired = portal_controller::desired(portal, millis());
  else if (handheldMode)
  {
    desired = handheld_controller::desired(handheld, millis());
    stop = stop || handheld_controller::emergencyStop(handheld);
  }
  protocol::Command c = gamepad_mapping::toCommand(desired, stop);
  portEXIT_CRITICAL(&lock);
  uint8_t frame[protocol::MAX_FRAME_SIZE];
  int n = protocol::encodeCommand(c, seq, frame);
  // The TX buffer holds many frames, so this never waits.
  Serial1.write(frame, n);
}

// Setup mode: at most one calibration set per period, after the command.
static void sendCalibration(uint8_t seq, uint32_t now)
{
  protocol::CalibrationSet set;
  portENTER_CRITICAL(&lock);
  bool due = calibration_sync::next(calibration, now, set);
  portEXIT_CRITICAL(&lock);
  if (!due)
    return;
  uint8_t frame[protocol::MAX_FRAME_SIZE];
  int n = protocol::encodeCalibrationSet(set, seq, frame);
  Serial1.write(frame, n);
}

// Hands every complete frame in the decoder to loop()'s side of the lock.
static void takeFrames(uint32_t now)
{
  protocol::Frame f;
  while (decoder.next(f))
  {
    if (handheldMode)
    {
      // Every valid frame, byte for byte, while a session is live. A full
      // relay drops the frame (counted): this never waits.
      portENTER_CRITICAL(&lock);
      relay_queue::relayFor(relay, handheld, millis(), decoder.frameBytes(), decoder.frameLength());
      portEXIT_CRITICAL(&lock);
    }
    if (f.type == protocol::FrameType::Telemetry)
    {
      portENTER_CRITICAL(&lock);
      telemetry = f.telemetry;
      haveTelemetry = true;
      telemetryAtMs = now;
      portEXIT_CRITICAL(&lock);
    }
    else if (f.type == protocol::FrameType::CalibrationReport)
    {
      portENTER_CRITICAL(&lock);
      report = f.calibrationReport;
      haveReport = true;
      reportAtMs = now;
      if (portalMode)
        calibration_sync::onReport(calibration, f.calibrationReport);
      portEXIT_CRITICAL(&lock);
    }
    else if (f.type == protocol::FrameType::Diagnostics)
    {
      // Only its protection limits, for the supply bands.
      portENTER_CRITICAL(&lock);
      supplyLimits = supply_band::fromDiagnostics(f.diagnostics);
      portEXIT_CRITICAL(&lock);
    }
    // Pose frames arrive too (the robot sends them on every link); the
    // decoder counts them as accepted. In WiFi drive the relay above
    // forwards them with every other frame; otherwise they are ignored.
  }
}

static void receive()
{
  static uint32_t lastByteMs = 0;
  static bool idleHandled = true;
  uint32_t now = millis();
  if (handheldMode)
  {
    // Before the drain: the bytes waiting arrived since the previous poll.
    portENTER_CRITICAL(&lock);
    relay_queue::beginPoll(relay, handheld, millis());
    portEXIT_CRITICAL(&lock);
  }
  int avail = Serial1.available();
  if (avail > 0)
  {
    lastByteMs = now;
    idleHandled = false;
  }
  // Decode after every byte: the decoder holds one frame at most, and a poll
  // can bring a telemetry frame and a calibration report together.
  while (avail-- > 0)
  {
    decoder.push((uint8_t)Serial1.read());
    takeFrames(now);
  }
  if (!idleHandled && now - lastByteMs >= RX_IDLE_MS)
  {
    decoder.idle();
    idleHandled = true;
    takeFrames(now);
  }

  portENTER_CRITICAL(&lock);
  if (handheldMode)
    relay_queue::endPoll(relay, decoder.pending() == 0);
  validFrames = decoder.validFrames();
  discardedFrames = decoder.discardedFrames();
  portEXIT_CRITICAL(&lock);
}

static void linkTask(void *)
{
  uint8_t seq = 0;
  TickType_t wake = xTaskGetTickCount();
  for (;;)
  {
    sampleEmergencyStop();
    sendCommand(seq++);
    if (portalMode)
      sendCalibration(seq++, millis());
    receive();
    // Fixed-rate: a late wake-up does not shift later frames.
    xTaskDelayUntil(&wake, pdMS_TO_TICKS(COMMAND_PERIOD_MS));
  }
}

static void startTask()
{
  initialDesired();
  pinMode(ESTOP_PIN, INPUT); // input-only pin; the board has the pull-up
  Serial1.setTxBufferSize(256);
  Serial1.setRxBufferSize(RX_BUFFER_SIZE);
  Serial1.begin(BAUD, SERIAL_8N1, RX_PIN, TX_PIN);
  // Above loop() (priority 1) so screen redraws cannot delay frames; pinned
  // to loop()'s core, leaving core 0 to the Bluetooth stack.
  xTaskCreatePinnedToCore(linkTask, "link", 4096, nullptr, 5, nullptr, ARDUINO_RUNNING_CORE);
}

void start()
{
  portalMode = false;
  handheldMode = false;
  startTask();
}

void startPortal()
{
  portalMode = true;
  handheldMode = false;
  startTask();
}

void startHandheld()
{
  portalMode = false;
  handheldMode = true;
  startTask();
}

void setDesired(const gamepad_mapping::Desired &d)
{
  portENTER_CRITICAL(&lock);
  desired = d;
  portEXIT_CRITICAL(&lock);
}

Status status()
{
  Status s;
  portENTER_CRITICAL(&lock);
  uint32_t nowMs = millis();
  s.telemetryFresh = haveTelemetry && nowMs - telemetryAtMs <= TELEMETRY_TIMEOUT_MS;
  s.telemetryAgeMs = haveTelemetry ? nowMs - telemetryAtMs : 0;
  s.telemetry = telemetry;
  s.emergencyStop = emergencyStop;
  s.validFrames = validFrames;
  s.discardedFrames = discardedFrames;
  s.haveReport = haveReport;
  s.reportAtMs = reportAtMs;
  s.report = report;
  s.supplyLimits = supplyLimits;
  portEXIT_CRITICAL(&lock);
  return s;
}

void portalPoll()
{
  portENTER_CRITICAL(&lock);
  portal_controller::poll(portal, millis());
  portEXIT_CRITICAL(&lock);
}

bool portalRequestMode(RequestedMode mode)
{
  portENTER_CRITICAL(&lock);
  bool taken = portal_controller::requestMode(portal, mode, millis());
  portEXIT_CRITICAL(&lock);
  return taken;
}

void portalRequestClear()
{
  portENTER_CRITICAL(&lock);
  portal_controller::requestClear(portal, millis());
  portEXIT_CRITICAL(&lock);
}

bool portalChange(int joint, calibration_sync::Field field, int32_t value, bool relative)
{
  portENTER_CRITICAL(&lock);
  // Like the mode buttons, an edit comes from an open page: it counts as a
  // poll.
  portal_controller::poll(portal, millis());
  bool changed = calibration_sync::change(calibration, joint, field, value, relative);
  portEXIT_CRITICAL(&lock);
  return changed;
}

void portalView(PortalView &out)
{
  portENTER_CRITICAL(&lock);
  uint32_t nowMs = millis();
  // Judged on a copy, so a view has no effect on the frames.
  portal_controller::Controller c = portal;
  out.connected = portal_controller::connected(c, nowMs);
  out.desired = portal_controller::desired(c, nowMs);
  out.sync = calibration;
  portEXIT_CRITICAL(&lock);
}

// --- WiFi drive ----------------------------------------------------------------

handheld_controller::Outcome handheldAccept(const uint8_t *datagram, int length, handheld_controller::Sender sender)
{
  portENTER_CRITICAL(&lock);
  // Stamped inside the lock, where the link task judges liveness against a
  // time it also takes there: a stamp taken before the lock could be older
  // than a judgement made in between, and end a session the datagram keeps
  // live. The UDP task calls this as soon as recvfrom returns.
  handheld_controller::Outcome o = handheld_controller::accept(handheld, datagram, length, sender, millis());
  portEXIT_CRITICAL(&lock);
  return o;
}

uint32_t handheldReadDelayMs(uint32_t nowMs)
{
  portENTER_CRITICAL(&lock);
  uint32_t delayMs = handheld_controller::readDelayMs(handheld, nowMs);
  portEXIT_CRITICAL(&lock);
  return delayMs;
}

int handheldTakeRelay(uint8_t *out, handheld_controller::Sender &to)
{
  portENTER_CRITICAL(&lock);
  int n = relay_queue::takeFor(relay, handheld, millis(), out, to);
  portEXIT_CRITICAL(&lock);
  return n;
}

void handheldView(HandheldView &out)
{
  portENTER_CRITICAL(&lock);
  uint32_t nowMs = millis();
  // Judged on a copy, so a view has no effect on the frames or the relay.
  handheld_controller::Controller c = handheld;
  out.state = handheld_controller::state(c, nowMs);
  out.desired = handheld_controller::desired(c, nowMs);
  out.emergencyStop = handheld_controller::emergencyStop(c);
  for (int i = 0; i < handheld_controller::OUTCOME_COUNT; i++)
    out.counts[i] = handheld_controller::count(c, (handheld_controller::Outcome)i);
  out.relayDropped = relay_queue::dropped(relay);
  portEXIT_CRITICAL(&lock);
}

} // namespace robot_link
