blackfyre/spooder/firmware/bridge/main/logo.h

#ifndef BRIDGE_LOGO_H
#define BRIDGE_LOGO_H

// Spooder logo, 128×64, 1 bit per pixel, rows of 16 bytes, MSB = leftmost
// pixel. Restored from the original robot's SH1107 OLED firmware
// (src/display/logo.h before commit b62ae27).
#include <stdint.h>

namespace logo
{

constexpr int WIDTH = 128;
constexpr int HEIGHT = 64;

// A bitmap table, one row of pixels per line: kept out of clang-format.
// clang-format off
static const uint8_t BITMAP[WIDTH / 8 * HEIGHT] = {
    0x00, 0x00, 0x00, 0x00, 0x00, 0x00, 0x00, 0x00, 0x00, 0x00, 0x00, 0x00, 0x00, 0x00, 0x00, 0x00,
    0x00, 0x00, 0x00, 0x00, 0x00, 0x00, 0x00, 0x00, 0x00, 0x00, 0x00, 0x00, 0x00, 0x00, 0x00, 0x00,
    0x00, 0x00, 0x00, 0x00, 0x00, 0x00, 0x00, 0x00, 0x00, 0x00, 0x00, 0x00, 0x00, 0x00, 0x00, 0x00,
    0x00, 0x00, 0x00, 0x00, 0x00, 0x00, 0x00, 0x00, 0x00, 0x00, 0x00, 0x00, 0x00, 0x00, 0x00, 0x00,
    0x00, 0x00, 0x00, 0x00, 0x00, 0x00, 0x00, 0x1f, 0xf8, 0x00, 0x00, 0x00, 0x00, 0x00, 0x00, 0x00,
    0x00, 0x00, 0x00, 0x00, 0x00, 0x00, 0x01, 0xff, 0xff, 0x80, 0x00, 0x00, 0x00, 0x00, 0x00, 0x00,
    0x00, 0x00, 0x00, 0x00, 0x00, 0x00, 0x07, 0xfe, 0x7f, 0xe0, 0x00, 0x00, 0x00, 0x00, 0x00, 0x00,
    0x00, 0x00, 0x00, 0x00, 0x00, 0x00, 0x1f, 0x80, 0x01, 0xf8, 0x00, 0x00, 0x00, 0x00, 0x00, 0x00,
    0x00, 0x00, 0x00, 0x00, 0x00, 0x00, 0x7c, 0x00, 0x00, 0x7c, 0x00, 0x00, 0x00, 0x00, 0x00, 0x00,
    0x00, 0x00, 0x00, 0x00, 0x00, 0x00, 0xf0, 0x1f, 0xf8, 0x1f, 0x00, 0x00, 0x00, 0x00, 0x00, 0x00,
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
    0x00, 0x00, 0x00, 0x00, 0x00, 0xe3, 0x9e, 0x01, 0x80, 0x79, 0xc0, 0x00, 0x00, 0x00, 0x00, 0x00,
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
};
// clang-format on

inline bool pixel(int x, int y)
{
  return (BITMAP[y * (WIDTH / 8) + x / 8] >> (7 - x % 8)) & 1;
}

} // namespace logo

#endif // BRIDGE_LOGO_H
