blackfyre/spooder/(commit log)

2024-02-05 Added Gyro and Machnie Learning component
2024-02-09 Fix dependencies and wiring issues
2026-10-16 Set up mise toolchain and OpenSpec, fix Bluepad32 dependency
    Pin Python and PlatformIO Core via mise with build/upload/monitor/clean
    tasks, initialise OpenSpec with its Claude Code commands and skills, and
    ignore the local CodeGraph index.
    The Bluepad32 library is published in the PlatformIO registry as
    "Bluepad32 for NINA-W10 boards"; the short name no longer resolves, so
    dependencies could not be installed.
    Claude-Session: https://claude.ai/code/session_01TL58oGMyQMmeXMf1sbLFyX
2026-10-16 Port upstream locomotion as a non-blocking, tested movement core
    Implements the OpenSpec change port-upstream-locomotion (locomotion and
    leg-actuation capabilities).
    - Split movement into a hardware-free core (body state machine, gaits,
    kinematics, vectors) and a PCA9685 servo layer behind
    setupMovement()/movementTick(nowMs, MovementCommand). Movement owns all
    mode, gait and leg transitions; a command only requests.
    - Make every mode non-blocking and time-based: Initialise, Stand, Walk,
    Sleep and Calibrate advance per 20 ms tick with dt-scaled rates.
    - Port from upstream: Sleep (fold, then outputs off; wake via Stand),
    command smoothing, fixed-stride mode, height and speed paramet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
2026-10-16 Fix issues from code review of the locomotion port
    - servos: cache a channel's pulse only when setPWM succeeds, and report
    outputs as off only once all eighteen full-off writes succeed, so
    failed I2C writes are retried instead of leaving a servo powered.
    - display: construct the SH1107 with 400 kHz pre/post clocks; its 100 kHz
    default post-transfer clock reset the shared bus after every frame.
    - display: set the redraw flag after the log buffer is updated, so a
    redraw racing the gamepad thread cannot clear it and miss the message.
    - body: legs that finished an earlier Stand group now track the standing
    point, so a height change during Stand-from-Walk no longer leaves three
    feet a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
2026-10-16 Lock the on-screen log and fix the ToF error sentinel
    - display: guard the log buffer, index, change flag and timestamp with an
    rtos::Mutex; addToLogBuffer is called from both loop() and the gamepad
    thread. loopDisplay copies the visible lines under the lock and draws
    outside it, so the gamepad thread never waits on a ~25 ms frame. The
    idle check samples millis() under the lock so a message logged in
    between cannot wrap it.
    - tof: track a failed reading with a flag instead of storing 999, which
    truncated to 231 and suppressed the next genuine 231 mm reading.
    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
2026-10-16 Run the body state machine on a fixed 5 ms grid and fix review findings
    Fixes found in iterative Codex review of the locomotion port:
    - Run the whole body state machine (mode resolution, Initialise holds,
    Stand, Walk progress and phase tracking, Sleep, Calibrate, smoothing) in
    fixed 5 ms sub-steps, carrying leftover time across transitions, so the
    same command sequence gives the same motion for any tick that is a
    multiple of 5 ms. Patching boundaries one at a time left 16-45 mm
    divergences between 20 ms and 50 ms ticks. Sub-steps only record feet
    after a cheap reachability check; IK is solved once per step.
    - Track ground/swing phase changes per sub-step, so a fast gait's ground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
2026-10-16 Archive port-upstream-locomotion and create its main specs
    Creates openspec/specs/locomotion (10 requirements) and
    openspec/specs/leg-actuation (5 requirements). Task 4.2, the on-robot
    hardware check, is recorded as superseded: the Nano RP2040 Connect/PCA9685
    robot was dismantled before it could be performed, and on-board
    verification moves to the Servo 2040 port.
    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
2026-10-16 Plan the port to Servo 2040 with an ESP32 gamepad bridge
    Adds three OpenSpec changes, in dependency order:
    - port-movement-to-servo2040: pico-sdk firmware on the Servo 2040,
    ServoCluster output, power protection, Nano firmware removed.
    - add-gamepad-bridge: TTGO T-Display v1.1 Bluepad32 bridge, UART link
    protocol, gamepad mapping, status screen.
    - add-body-sensing: VL6180X and LSM6DSO on I2C1, read on core 1.
    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
2026-10-16 Move the movement core to core/ and remove the Nano firmware
    The hardware-free movement core (body, gait, kinematics, vectors,
    movement_command) moves unchanged to core/movement. PlatformIO now only
    runs the host tests, with src_dir = core. The Arduino/mbed firmware for
    the dismantled Nano RP2040 Connect (PCA9685 servos, NINA/Bluepad32,
    SH1107, IKS01A3 MLC, VL6180X) is removed; it remains in history.
    Part of OpenSpec change port-movement-to-servo2040 (tasks 1.1, 1.2).
    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
2026-10-16 Add the Servo 2040 pico-sdk firmware skeleton
    - Pin pico-sdk 2.2.0 and pimoroni-pico v1.29.0-2 as submodules (only
    pico-sdk's tinyusb sub-submodule is needed; `mise run setup`).
    - mise provides cmake, ninja and gcc-arm-none-eabi and sets PICO_SDK_PATH,
    PIMORONI_PICO_PATH and PICO_BOARD; build/upload/monitor/clean tasks now
    target firmware/servo2040.
    - Minimal firmware: LEDs on PIO 1, USB-only stdio (GPIO0/1 are servo
    outputs), and the movement core linked as spooder_core with -Wall
    -Wextra. The pico_float ROM routine wrappers are linked.
    Part of OpenSpec change port-movement-to-servo2040 (tasks 1.3-1.5).
    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
2026-10-16 Add the hardware-free power-protection core
    core/protection turns supply current/voltage readings into whether servo
    output may be on and whether the body must sleep:
    - power-on gate: output only after 500 ms of continuously valid supply;
    an absent supply (USB only) holds output off without latching faults
    - overcurrent, brown-out and overvoltage trip on the evaluation step and
    inhibit output; inhibition needs a fresh 500 ms settle after clearing
    - sustained current over a time-weighted window (50 ms buckets) and
    debounced undervoltage put the body to sleep
    - faults latch; a clear removes only faults whose condition is absent
    15 host tests; built into the firmware's spooder_core.
    Par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
2026-10-16 Make the sustained-current window cover exactly its configured length
    Advancing the bucket ring zeroed the oldest bucket at once, so a 2000 ms
    window covered only 1950-1999 ms and over-reported short heavy loads near
    the threshold (1.4 s at 8.5 A after idle read 6.10 A instead of 5.95 A
    and latched Sleep). Keep one extra bucket and count the oldest one in
    proportion to the part still inside the window. Found in Codex review;
    regression test added.
    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
2026-10-16 Run movement on the Servo 2040 with power protection
    - servo_output: ServoCluster on PIO 0 for all 18 outputs; joint pulses
    batched and loaded once per step; never uses enable() (which would send
    unset servos to mid-travel) and writes nothing while protection
    inhibits output. Output index = 3*leg + joint (host-tested).
    - power_monitor: supply current and voltage via the analog mux.
    - status_leds: waiting (pulsing amber), healthy (green, mode as LED
    count), and a distinct colour per fault alternating with red.
    - serial_commands: USB stdio bring-up input, plus '!' to clear faults
    and 'p' to print readings.
    - main: 20 ms loop of read -> protection -> command override -> body
    step ->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
2026-10-16 Keep the body asleep after a fault until a new request, run protection first
    Codex review found two safety issues on the Servo 2040 loop:
    - Clearing a fault resumed the last movement: the serial hook holds its
    last mode and re-stamps it every tick, so '!' alone restarted walking.
    New core/protection/resume_gate keeps the body asleep after any latch
    until the input reports a new explicit mode request (requestSeq),
    host-tested. The bridge plan gains a mode-request counter in its
    command frame for the same rule.
    - An unbounded serial drain (with up to 1 ms per acknowledgement) could
    delay protection beyond 20 ms. Protection is now evaluated first each
    tick (clear requests apply fr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
2026-10-16 Document the Servo 2040 platform in CLAUDE.md and the project skills
    Rewrites CLAUDE.md, spooder-firmware-shape and spooder-hardware-check for
    the Servo 2040 (toolchain, required power limits, core/ vs firmware/
    layers, the core 0 loop with protection first and the resume gate, PIO
    and DMA usage, J6 pinout and allocation, power and ground rules, staged
    bring-up, LED and serial reference). Updates spooder-leg-kinematics for
    the ServoCluster output map and the OpenSpec project context.
    Part of OpenSpec change port-movement-to-servo2040 (task 4.3).
    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
2026-10-16 Record clean-checkout verification of the Servo 2040 port (task 4.1)
    Fresh clone: mise run setup, mise run test (73 tests) and the firmware
    build with the example power limits all pass without warnings.
    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
2026-10-16 Cut servo output immediately and only resume it at a body wake
    Codex review found two issues in servo output on protection trips:
    - ServoCluster's disable only takes effect at the next 20 ms sequence
    boundary, allowing pulses for up to ~40 ms after a fault. Switch-off
    now forces each servo pin low through the GPIO output override as soon
    as that pin is low (no truncated pulses), bounded by one pulse length,
    then loads zero pulses; the override is released no earlier than 25 ms
    later, at the next switch-on.
    - A fault cleared while the body was still folding in software re-enabled
    output mid-fold, so the legs jumped without a new request. New
    core/protection/output_hold (host-tes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
2026-10-16 Release the output hold on the body's wake counter, not on edges
    body::step runs several 5 ms sub-steps, so a Sleep fold can complete and
    the body wake again inside one step. The output hold watched for
    outputsEnabled going false then true between steps, missed that case, and
    then held output off permanently. BodyState now counts wakes (wakeCount)
    and the hold releases when the count changes after an inhibit. Found in
    Codex review; host tests cover the in-step fold-and-wake.
    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
2026-10-16 Stop the body on output-cutting faults and restart it like power-up
    Codex review kept finding edge cases in resuming output after a fault
    while the body ran on with output cut (a fault before start-up moving the
    legs after a clear; a wake during supply settling leaving output off for
    good). Replace that mechanism with one rule, owned by the new host-tested
    core/protection/supervisor:
    - a fault that inhibits output stops the body and switches output off
    - the body (re)starts through the boot sequence only when output is
    allowed and the resume gate has seen a new request since the fault
    - sleep-only faults keep the body running asleep and wake through Stand
    The output hold and BodyState::wa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
2026-10-16 Never start a stopped body for a Sleep request
    The resume gate counts any new request as fresh, including Sleep, and the
    supervisor then started the body; body::init drives the servos to the
    Initialise pose, so pressing Sleep after clearing an overcurrent moved the
    legs. The body now starts only for a non-Sleep request, at boot and after
    faults. Found in Codex review; regression tests added.
    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
2026-10-17 Set power limits for MG996R servos on a 6 V BEC
    18 x MG996R (180 deg, rated 4.8-7.2 V) fed from a ~6.0 V BEC on a 2S
    LiPo, a lab PSU at 6.0 V during bring-up: trip 9 A (below the 10 A
    terminal rating), 6 A sustained over 2 s (to tune from bring-up
    measurements), 5.2 V minimum with a 500 ms debounce, 4.8 V brown-out,
    6.8 V maximum. The board senses the BEC output, so these protect servos
    and board, not the battery cells.
    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
2026-10-17 Add architecture diagrams of the Servo 2040 firmware
    Archify diagrams (HTML plus candidate JSON and check receipts), sourced
    from the repository at 79fd9ac:
    - spooder-servo2040: the built firmware on the Servo 2040
    - spooder-planned: the same, plus the planned TTGO T-Display gamepad
    bridge, UART link and VL6180X/LSM6DSO sensors (dashed, from OpenSpec)
    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
2026-10-17 Show operating state on the status LEDs
    New hardware-free core/status/led_pattern (10 host tests) computes the
    six LEDs from the robot state; status_leds only drives them.
    - LEDs 1-5, by priority: latched fault (fault colour alternating with
    red, brighter), waiting for supply (amber pulse), body stopped and
    waiting for a request (blue breathing), walking (load bar of supply
    current against the trip limit in the gait's colour, red past the
    sustained limit), other modes (green, LED count = mode)
    - LED 6: command source (dim white serial hook; cyan, blinking magenta
    and fast-blinking amber for bridge connected, no gamepad and stale link,
    fed once the bridge exists)
    - normal patterns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
2026-10-18 Suspend add-body-sensing until the sensor boards are found
    The VL6180X and LSM6DSO boards are not to hand. add-gamepad-bridge does
    not depend on this change; its sensor telemetry fields stay marked
    unavailable meanwhile.
    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
2026-10-18 Add the bridge link protocol, gamepad mapping and robot link
    Hardware-free core, host-tested (164 tests):
    - core/protocol: versioned frames with CRC-16/CCITT-FALSE, encoders and an
    incremental decoder that keeps the earliest candidate until its CRC is
    checked; idle() abandons a false start once the line goes quiet
    - core/protocol/link_receiver: arrival stamping, one clear per clear-counter
    change, mode-request counter to requestSeq, Sleep without a controller;
    after a 200 ms link gap the first frame only sets the counter baselines,
    so a restarted bridge cannot clear faults or restart motion (spec updated)
    - core/gamepad_mapping: the spec's mapping table, 8 % radial dead zone,
    1 s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
2026-10-18 Add the TTGO T-Display gamepad bridge firmware
    firmware/bridge: ESP-IDF + Arduino + Bluepad32 on the original ESP32.
    - one controller slot; gamepad -> core/gamepad_mapping -> command frames
    - robot_link: a FreeRTOS task above loop() sends a frame every 20 ms,
    samples the GPIO35 e-stop toggle and decodes telemetry, so screen
    redraws cannot delay commands
    - display: LovyanGFX on the ST7789 (135x240), core/status/status_screen
    lines, at most every 250 ms, changed lines only
    Pinned submodules: Bluepad32 template 5.0.0-beta0 (Arduino core 3.3.12,
    BTstack) and LovyanGFX 1.2.32; pioarduino platform 55.03.31-2 (ESP-IDF
    5.5.1). Bridge mise tasks run the platform's own PlatformIO core in
    .pio-c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
2026-10-18 Show the Spooder logo and a start-up log when the bridge boots
    The logo from the original robot's OLED firmware (2x, cropped, centred)
    shows for 1.5 s, then the start-up steps for 1.5 s, then the status
    screen. It is a timed phase in display::update, so nothing blocks and
    command frames flow throughout; an active e-stop skips straight to the
    status screen. Added as a status-display requirement.
    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
2026-10-18 Plan live joint calibration with a WiFi portal and a desktop app
    - add-live-joint-calibration: the robot side and shared contract: a
    per-joint calibration table (offset, pulse end points, direction) with
    guards and a 60 deg/s rate limit, reports, protocol version 2, the USB
    port as a second link port with source arbitration, and golden files
    for frames and the compiled-defaults format
    - add-bridge-setup-portal: a bridge setup mode (WiFi or Bluetooth, never
    both) with a captive portal acting as controller and calibration
    front-end; a plain HTML/JS page
    - add-desktop-calibrator: a Go/Gio app on the robot's USB port, observe
    by default, explicit control, e-stop, editor, export int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
2026-10-18 Add the joint calibration table and use it for IK and pulses
    Each of the 18 joints now has an offset, 0° and 180° pulses and a
    direction, loaded from compiled defaults in a fixed-format file (seeded
    with the former LEG_OFFSETS, 500/2500 µs, normal). The IK takes each
    leg's offsets from the body, which re-solves a leg when they change, and
    servo_output converts every joint through the table. Changes are clamped
    and followed at no more than 60°/s. A golden copy of the defaults file
    and a reference exporter pin the format.
    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
2026-10-18 Move the link protocol to version 2 with calibration frames
    Adds the calibration set (type 3) and calibration report (type 4)
    frames and the telemetry flags byte (source conflict, USB or bridge in
    control); MAX_FRAME_SIZE becomes 135. Version-1 frames are rejected, so
    mismatched firmwares fail safe as a lost link. Golden frame vectors in
    test/golden/protocol_v2.txt, generated from the encoder, pin the wire
    format for other implementations.
    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
2026-10-18 Guard calibration changes and arbitrate between the two links
    link_receiver queues calibration sets per link and processes them
    through the guards (Calibrate with output allowed, then the clamps),
    treating a repeated request id as a retransmission. It builds the
    calibration report and schedules reports after each set and at 1 Hz in
    Calibrate, at most 5 Hz per link. Arbitration picks the link with a
    fresh, connected controller, sleeps on a conflict, ORs the e-stops,
    takes a fault clear only from the source in control, and advances the
    request counter only from that source's own counter.
    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
2026-10-18 Run the calibration tables on the robot and report over the bridge
    main keeps requested and applied tables from the compiled defaults,
    guards calibration sets from the bridge link with the tick's output
    state and body mode, steps the applied table at the rate limit every
    tick, and feeds it to the IK and servo output. Reports go out after
    each processed set and at 1 Hz in Calibrate, capped at 5 Hz. UART1 now
    transmits through a 256-byte queue of whole frames, so a report and a
    telemetry frame can be in flight together.
    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
2026-10-18 Carry link frames over USB and arbitrate between bridge and USB
    usb_link decodes frames from the USB serial port alongside printf's
    debug text and writes frames whole or not at all, with the CDC transmit
    buffer raised to 256 bytes so a report fits. main arbitrates between the
    bridge and USB links, takes calibration sets from both, and sends
    telemetry (with the source flags) and reports on both. LED 5 shows USB
    in control and a source conflict; the console prints source changes.
    --serial builds keep the USB port for the serial keys.
    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
2026-10-18 Let calibrated pulses below 500 and above 2500 µs reach the servos
    Each ServoCluster channel kept its default angular calibration, which
    clamps pulses to 500-2500 µs, so a joint calibrated to 400 or 2600 µs
    was silently cut short while reports showed the calibrated value.
    servo_output now drops the calibration limits and keeps only the
    cluster's 400-2600 µs hard limits, which a static_assert ties to
    joint_calibration's pulse range.
    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
2026-10-18 Move the bridge to protocol version 2
    The bridge keeps the newest calibration report alongside telemetry
    (it sends no calibration sets in normal operation), reads the telemetry
    source flags, and shows a source conflict or USB in control on the link
    line of its status screen. Its UART receive buffer grows to 1024 bytes,
    since reports raise the robot's traffic towards the line rate.
    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
2026-10-18 Decode bridge input after every byte so bursts keep every frame
    The bridge pushed a whole poll's bytes before decoding, but the decoder
    holds one frame of at most 135 bytes. A telemetry frame and a
    calibration report arriving in one 20 ms poll (174 bytes) lost the
    telemetry. receive() now drains the decoder after each byte, as the
    robot's adapters do, and the decoder's header states that contract; a
    protocol test pins the burst case.
    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
2026-10-18 Document live joint calibration, protocol v2 and the USB link
    CLAUDE.md and the firmware-shape, hardware-check and leg-kinematics
    skills now describe the calibration table and compiled defaults, the
    version 2 frames and golden files, the USB link and source arbitration,
    the new LED and screen indications, flashing both boards together, and
    recalibrating through live changes and an export.
    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
2026-10-18 Add the desktop calibrator's Go module and mise tasks
    A Go module under desktop/ with Gio pinned, a placeholder window, and the
    desktop-deps, desktop-build, desktop-run and desktop-test tasks. The
    dependency check names the Fedora packages behind Gio's pkg-config
    entries; design D2 now lists the packages actually needed.
    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
2026-10-18 Add the Go link protocol, tested against the golden vectors
    internal/protocol mirrors core/protocol version 2: frames, CRC and the
    incremental decoder with the same candidate rules. Every vector in
    test/golden/protocol_v2.txt decodes to the listed fields and re-encodes
    byte for byte; the rejected ones are discarded. The decoder hands every
    byte outside a frame to a Discard hook, so the host can recover text.
    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
2026-10-18 Add the desktop link: stream split, writer and reconnect
    internal/link owns the serial port: the reader splits the stream into
    frames and debug text lines (a stray 0xA5 is shown as \xA5 and counted),
    the writer sends a command every 20 ms and at most one calibration set
    after it, and the supervisor reopens the same device by USB serial number
    every 500 ms after a loss. Disconnecting sends one last frame without the
    controller flag. go.bug.st/serial is pinned to v1.8.0.
    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
2026-10-18 Add the hardware-free setup-portal core with host tests
    Portal controller (portal polls and buttons as the bridge's controller),
    calibration sync (pending edits, one set in flight, confirm by report id,
    resend after 200 ms), calibration export (the defaults file from a
    reported table, checked against the golden file), setup entry and access
    point helpers, and the setup variant of the status screen.
    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
2026-10-18 Serialise link connects, complete short writes, bound shutdown
    Review fixes: Connect and Disconnect hold one lock across the whole
    transition; a frame begun is written completely or the connection is
    treated as failed; a stalled write gets 200 ms on disconnect before the
    port is closed under it; at the end of the stream every incomplete
    candidate is abandoned so the bytes behind it reach the text.
    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
2026-10-18 Treat a write blocked for 500 ms as a lost connection
    A blocking write (Windows serial writes have no timeout) now closes the
    port, so the loss is reported and the device reopened. Also gofmt the
    link sources, which the desktop-test gate checks.
    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
2026-10-18 Add the calibration model: pending edits, resend and confirmation
    internal/calib follows the bridge's calibration_sync rules: the latest
    value per joint, the oldest pending sent first, one request id per new
    value, a resend with the same id after 200 ms, confirmation only by the
    report's request id, and the reported table always shown, including
    clamps and rejections. Request ids start after the robot's last one and
    never repeat it or one still in flight.
    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
2026-10-18 Add the session: observe and control, e-stop and telemetry
    internal/session is the single state owner between the link and the UI.
    Frames report a controller only while control is taken; Stand,
    Calibrate, Sleep and Clear fault need control; the e-stop flag works in
    both; releasing control, losing the link or shutting down return to
    observing and drop unconfirmed edits. Telemetry is stale after 1 s, and
    joint editing needs control and a current Calibrate report.
    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
2026-10-18 Add the bridge's setup mode with a WiFi captive portal
    Holding the left button during the logo restarts the bridge into setup
    mode (RTC magic plus a software restart), which never starts Bluetooth.
    It runs a one-station WPA2 access point with an NVS-kept random password,
    a DNS server answering every name, and an HTTP server with the portal
    page, its API and captive-portal redirects. The link task takes its
    commands from the portal controller and sends calibration sets; the
    setup screen shows the credentials and a joining QR code. WiFi code moves
    out of IRAM so both radios' stacks link.
    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
2026-10-18 Add the export of calibration_defaults.cpp into a checkout
    internal/export formats the reported table in the fixed defaults format
    (the golden report of the defaults exports to the golden file byte for
    byte), checks that the chosen directory is a spooder checkout, shows a
    line difference, and writes the one file atomically after checking that
    it still holds what the difference was made from. The last checkout is
    remembered in the user config directory.
    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
2026-10-18 Keep one calibration change in flight; refuse symlinked paths
    Review fixes: the robot recognises only its last request id as a
    retransmission, so an older change resent after a newer one would be
    processed again; the model now sends one change at a time and resends
    only it until confirmed. The export refuses a checkout whose core/ or
    core/movement/ is a symbolic link. Design D5 and D6 record both.
    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
2026-10-18 Document the bridge's setup mode and the portal calibration workflow
    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
2026-10-18 Add the calibrator's Gio UI in the Blackfyre look
    The window draws session snapshots: a header with the port picker
    (Servo 2040 preselected), connection state, the control toggle and the
    e-stop (also Space), a telemetry strip with the mode controls, the joint
    editor as 6 x 3 cards with fine and coarse nudges by pointer and keyboard
    and pending markers, and log, frames and export panes (difference,
    confirm, write, copy). The Blackfyre palettes follow the system's light
    or dark mode; Archivo and JetBrains Mono are embedded with their OFL
    licences; buttons are tactile. The window takes Tab so Space always
    reaches the e-stop. Design D2, D6 and D7 record the clarifications.
    Claude-Session: https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
2026-10-18 Tick the desktop calibrator's module, protocol and model tasks
    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
2026-10-18 Toggle the e-stop once per Space press; show every fault
    Review fixes: key repeat while Space is held no longer toggles the e-stop
    back (a press long after a lost release still counts); the faults wrap
    instead of being cut off; an unchanged port list keeps its buttons, so a
    press spanning a refresh is not lost. Joint cards put the nudges under
    their values so the values stay legible, and an opt-in test renders the
    window off screen to PNG files (SPOODER_SCREENSHOTS=<dir>).
    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
2026-10-18 Latch Space until release or focus loss; keep Connect reachable
    Review fixes: the e-stop key now toggles once per press however slow the
    key repeat, and a held key is forgotten when the window loses the focus;
    the port buttons scroll sideways so Refresh and Connect always fit; the
    connection message, including the dialout hint, wraps. The Go golden
    test of the export compares with test/golden only, as design D6 says.
    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
2026-10-18 Let every Space release reach the e-stop latch
    Review fix: a release with Ctrl or Alt held was filtered out, leaving the
    latch closed so later Space presses were ignored. The Space filter now
    accepts every modifier.
    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
2026-10-18 Document the desktop calibrator and tick its finished tasks
    CLAUDE.md names the app, its mise tasks, the Fedora packages and the
    dialout group, and its layout; the hardware-check skill gains the bench
    calibration workflow with the app. Tasks 3.1, 3.3, 4.1 and 4.3 are done;
    the board checks of 3.2 and 4.2 stay open.
    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
2026-10-18 Ignore agent worktrees and point the kinematics skill at the main specs
    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
2026-10-18 Style the setup portal in the Blackfyre look
    Paper and dark palettes following the phone's setting, the orange accent
    for selections and the e-stop banner, uppercase tracked monospace labels,
    tactile buttons and section cards, in the same tokens as the desktop
    calibrator. The mode buttons now highlight the mode the portal requests.
    Still one file with no external resources (10.8 KB of 16 KB); Archivo and
    JetBrains Mono are named first and fall back to system fonts.
    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
2026-10-18 Add an architecture diagram of the current system
    The robot, gamepad bridge with setup portal, and desktop calibrator at
    4a09447, with the suspended sensors marked planned.
    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
2026-10-18 Give the bridge a partition table its app fits
    With WiFi and Bluetooth both linked the bridge image is about 1.6 MB.
    The pioarduino platform takes the partition table from
    board_build.partitions and ignores the sdkconfig choice, so it used the
    stock 1 MB single-app table: the image flashed but did not boot
    ("doesn't fit in partition"). partitions.csv gives the app 3.9 MB plus
    the coredump partition the template's config expects; sdkconfig.defaults
    now names the same table. Verified on the TTGO: it boots, BTstack up.
    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
2026-10-18 Propose the desktop leg view and the pose frame
    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
2026-10-18 Add the pose frame (type 5) to the link protocol
    An additive frame for the USB host: per joint the commanded angle, the
    servo angle and the pulse set, plus an outputs-on flag. The protocol
    version stays 2. Golden vectors are appended to protocol_v2.txt and the
    Go decoder learns the type.
    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
2026-10-18 Make the calibration guard tests independent of the seed defaults
    The tests truncated default offsets to centidegrees and expected 500/2500 us
    and normal direction in the first report, so a real calibration in
    calibration_defaults.cpp failed them. Round to centidegrees as the report
    does, and compare the report with the compiled defaults.
    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
2026-10-18 Pin the defaults format with a fixture, not a copy of the defaults
    Exporting a real calibration broke the gates: the golden file had to equal
    calibration_defaults.cpp, a test pinned the seed offsets, and the desktop
    export test took its table from the seed report in protocol_v2.txt.
    test/golden/calibration_defaults.cpp is now the export of a fixed fixture
    table that every exporter (reference, portal, desktop) checks byte for byte.
    The committed defaults file may hold any calibration: tests check that it
    parses as 18 joints in order, matches DEFAULTS, stays within the guards' hard
    limits and round-trips exactly through the exporters, and a test runs the
    same checks on a changed table exporte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
2026-10-18 Send the pose to the USB host at 10 Hz
    link_receiver::makePose builds the frame from the body's angles and
    offsets and servo_output's pulses; usb_link sends it two ticks after
    telemetry. The bridge link has no pose sender.
    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
2026-10-18 Add the leg view's forward kinematics, pinned against the C++ IK
    test_leg_pose_golden writes test/golden/leg_pose.txt from solveLeg; the
    Go legview package inverts it, maps legs onto the body as the gait code
    mounts them, and classifies servo angles against the 0-180 degree range.
    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
2026-10-18 Add spooder-monitor, a readable console for the robot's USB port
    mise run monitor now prints the robot's debug text with timestamps and
    keeps the link frames out of it; --frames adds a one-line decode of each
    frame. It only observes and never sends a frame: --keys forwards typed
    printable ASCII for a --serial build. The raw console stays as
    monitor-raw.
    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
2026-10-18 Count a servo angle exactly 5 degrees from a limit as near it
    Review finding: the spec says within 5 degrees.
    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
2026-10-18 Keep the latest pose frame and its age in the session
    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
2026-10-18 Keep the defaults checks within the wire's offset range
    Accept -327.68 degrees, which the wire carries, and move the changed table's
    offsets towards zero so the test cannot overflow for any valid defaults.
    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
2026-10-18 Move the control loop's logic into a shared core tick
    core/robot/robot_tick holds the 20 ms loop body that lived in the
    firmware's main.cpp: link decoding and arbitration, protection, the
    supervisor, calibration processing and stepping, the body, LED state,
    telemetry, reports and debug text. The firmware keeps the adapters and
    the period; link and usb_link only move bytes. Behaviour is unchanged
    (a host differential run of the old and new loops gives identical call
    traces). Host tests cover the loop rules previously checked only on the
    board.
    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
2026-10-18 Limit default offsets to half a turn in the defaults checks
    The guard tests add up to 90 degrees to a default offset on the wire's int16
    centidegrees, so a default beyond 180 degrees would overflow them. No joint
    offset needs more than half a turn.
    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
2026-10-18 Add the legs pane to the desktop calibrator
    The selected leg from the side with each joint's pulse and a coxa inset,
    its joints' commanded and servo angles and pulses, and all six legs from
    above; limits ringed, the editor's joint in the accent, and no pose when
    the last pose frame is over a second old. The screenshot test renders
    the calibration pose, walking, a joint at its limit and no pose.
    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
2026-10-18 Add the virtual robot: the shared tick behind pseudo-terminals
    tools/virtual-robot runs core/robot/robot_tick natively. Its USB port is
    a pseudo-terminal (optionally linked at a stable path) carrying frames
    and debug text as the board's does; a second terminal or a simulated
    bridge feeds the bridge link. It ticks in real time, faster, or stepped,
    simulates the supply and a current that grows with servo motion, and
    takes supply, current, load, bridge, e-stop, unplug and step commands on
    standard input, reporting applied calibration and output changes.
    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
2026-10-18 Keep the legs pane's joint list whole at the minimum window size
    Review finding: at 1000 dp the top view left the joint list too narrow,
    truncating the pulses. The list now keeps its columns' width, marks a
    limit on the servo angle itself, and the screenshot test also renders
    the minimum window.
    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
2026-10-18 Document the pose frame and the legs pane
    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
2026-10-18 Connect the calibrator to the virtual robot and test end to end
    --port PATH lists and preselects a port the enumeration does not report
    (the virtual robot's pseudo-terminal or its link); Serial.Open opens a
    port without modem lines without DTR/RTS. desktop/e2e drives the real
    link and session against the virtual robot (observe, Calibrate with a
    confirmed, rate-limited change, e-stop, release, overvoltage, conflict,
    current, unplug); mise run e2e builds the robot and runs them. A live
    screenshot test renders the window against it.
    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
2026-10-18 Expect the pose vectors in the console's golden checks
    The pose frame's golden vectors reached test/golden after the console's
    expected lines and transcript were written; the console prints them with
    the generic summary.
    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
2026-10-18 Share the pseudo-terminal open fallback between monitor and calibrator
    link.Serial.Open already reopens without DTR/RTS when a port has no modem
    lines; the monitor now uses it instead of its own console.OpenSerial.
    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
2026-10-18 Record the confirmed leg order and the IK calibration pose
    Legs 1 and 6 are the front pair, in the code's declaration order; the
    legs pane drops its "(assumed)" caption. The kinematics skill takes the
    IK geometry as authoritative for the calibration pose.
    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
2026-10-18 Add desktop-sim: the virtual robot and the calibrator in one task
    The robot keeps the terminal for its commands (raw, so stdin reaches it)
    and the calibrator opens on its port; closing either ends both.
    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
2026-10-18 Show coxa offsets from the servo centre; require defaults to reach the calibration pose
    The portal and the desktop calibrator show a coxa's offset as the stored
    value minus 90 degrees, labelled from centre; the table, the link and the
    export keep the stored value. The defaults check replaces its +/-180 degree
    bound with the servo angle at the calibration pose (IK angle plus offset)
    within 0-180 degrees.
    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
2026-10-18 Expand the readme: overview, quick start, wiring, controls, screenshots
    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
2026-10-18 Update the system diagram: virtual robot, monitor, pose frame, shared tick
    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
2026-10-19 Align the calibrator's top bar; show and add keyboard controls
    The ports, Refresh, Connect, the control toggle and the e-stop share one
    row of equal-height buttons, with the link state beneath. While in
    control the app lists its keys, and the mode controls gain shortcuts:
    1 Stand, 2 Calibrate, 3 Sleep, F Clear fault, acting only in control
    like the buttons, which name their keys.
    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
2026-10-19 Add the calibrator's icon and a Linux launcher
    A hexapod from above in the Blackfyre colours (desktop/assets/icon.svg,
    rendered PNGs and .ico). mise run desktop-install installs the icon and a
    desktop entry for this user, matching Gio's default app ID; desktop-icons
    re-renders the assets.
    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
2026-10-19 Draw the docs' diagrams in Mermaid
    The readme's system overview and both body-mode state machines (the
    kinematics skill and the archived locomotion design) become Mermaid
    blocks; CLAUDE.md makes Mermaid the rule for Markdown diagrams.
    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
2026-10-19 Propose car-like steering and gestures; refresh the OpenSpec context
    add-steering superposes the translate and rotate strokes, so turning
    while walking keeps the forward stride, and adds a default steer stick
    mode (left stick walks and steers, b toggles the crab layout).
    add-gestures adds a Perform mode playing say hi, wiggle, dance, attack and
    ball, with protocol 3, the L2 gesture layer and desktop buttons.
    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
2026-10-19 Steer like a car: superpose walking and turning, add steer and crab stick modes
    The gait sums the translate and rotate strokes instead of sharing one
    stride between them, so turning while walking keeps the forward stride and
    follows an arc; one common scale shrinks both when a stroke would exceed
    the gait limit or be unreachable, and a combined swing lifts to the higher
    path. The bridge steers by default (left stick Y walks, X steers, mirrored
    when reversing past 10 %); b switches to the crab layout, and the right
    stick now turns the way it points. Confirmed on the robot.
    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
2026-10-19 Add gestures: Perform mode with say hi and wiggle, protocol version 3
    A Perform body mode plays scripted gestures from a settled Stand: keyframes
    of body shifts over planted feet and lifted legs, eased and rate-limited to
    300 mm/s per foot, with time carried over segment ends. Sleep, a stale
    command, the e-stop and faults interrupt at once; any other request,
    a new Stand included, finishes the keyframe, puts the feet down and
    straightens. The body height is held while a gesture plays.
    Protocol version 3 carries the gesture request and its counter in the
    command and the gesture playing in telemetry; link_receiver baselines the
    counter after a gap and counts it only from the source in control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
2026-10-19 Archive the completed OpenSpec changes into the main specs
    check-bridge-image-size, add-virtual-robot, add-desktop-leg-view and
    add-steering are complete; their requirements now live in openspec/specs
    (new: bridge-build, virtual-robot, desktop-leg-view, pose-telemetry,
    desktop-calibrator, gamepad-control; locomotion's walk requirement
    updated). The changes with on-robot tasks still open stay active.
    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
2026-10-20 Add the servo speed budget, rumble, link diagnostics and calibrator driving, charts and four views
    - Servo profiles (SPOODER_SERVO_PROFILE, default MG996R) set a joint speed
    budget: movement slows its clock in 20 ms pieces, and an output backstop
    never exceeds the rated speed. Walk entry stays continuous, foot targets
    are validated against the femur and tibia reach and fitted to the servos'
    0-180 degree travel, and the speed dial and stride mode are eased.
    - The bridge rumbles the gamepad on faults, its e-stop, link changes and
    refused gestures.
    - Telemetry reports the bridge link; a USB-only diagnostics frame carries
    the robot's internals at 10 Hz (protocol version 3).
    - The des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
2026-10-20 Add walking, charts, four-view and e-stop screenshots to the readme
    The live screenshot test now also drives the virtual robot forward from
    the keyboard and captures the legs pane, the charts tab and the four-view
    window; the calibrator screenshot is refreshed for the current top bar.
    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
2026-10-20 Archive the implemented OpenSpec changes into the main specs
    add-gamepad-bridge, port-movement-to-servo2040, add-live-joint-calibration,
    add-bridge-setup-portal, add-desktop-calibrator, add-robot-console-monitor,
    add-gamepad-rumble, add-link-diagnostics, add-servo-speed-budget,
    add-desktop-driving, add-desktop-charts and add-four-view-window are
    implemented; their requirements now live in openspec/specs (new:
    setup-portal, robot-console, diagnostics-telemetry). Their open tasks are
    on-robot checks only, kept in the archived tasks files, which the
    hardware-check skill now points to. add-gestures (phase 2) and
    add-body-sensing stay active.
    Claude-Session: https://claude.ai/code/session_01TL58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
2026-10-21 Follow the Blackfyre design system in the calibrator and the setup portal
    Both now take the design system's tokens: its exact colours (bf-ok, the
    dark-panel shades in dark mode, and the app tokens for chips, status and
    chart series), 10 px buttons on raised edges (3 px under dark buttons,
    2 px with a highlight under light and orange ones), 22 px panels and
    14 px cards, the label, kicker and micro letter-spacing, and display
    titles ending in an orange full stop. The portal also gets 44 px touch
    targets, numbered section kickers, outlined panels with the panel shadow
    and the accent focus ring. Text on orange stays ink (4.56:1; the system's
    white reaches 3.78:1). The readme screenshots show the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
2026-10-22 Give the overcurrent trip two levels
    A stand from Sleep or Initialise starts all 18 servos together; on the
    bench the supply surged to 11.8 A for one reading and the instant 9 A trip
    latched. Above the trip current the fault now latches only once the
    current has stayed there for SPOODER_TRIP_PERSIST_MS (60 ms); a new
    ceiling, SPOODER_CEILING_CURRENT_A (13 A), still cuts output on one
    reading. The protocol, telemetry and clear flow are unchanged.
    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
2026-10-22 Make the calibrator's log and frames panes selectable
    The debug log and frames pane share a text-pane widget: drag selects
    across lines, Shift+click extends, Ctrl+C (Cmd+C on macOS) copies the
    lines as shown and no longer lowers the height. The panes follow new lines
    only while their end is in view; scrolled up or holding a selection, the
    view stays on the same lines, also as the oldest are dropped.
    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
2026-10-22 Switch servo output on two legs per tick
    When output switched on, all 18 servos got their first pulse in one frame
    and ran flat out together; unloaded, that read 11.8 A. robot_tick now
    releases two more legs per tick from the tick output switches on (legs
    1-2, then 3-4, then 5-6) and hands the count to applyServos; servo_output,
    the virtual robot and the test fake power only released legs. A leg not
    yet released counts as unknown to the output rate backstop. Switching off
    stays immediate.
    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
2026-10-22 Archive the two-level trip, selectable panes and staggered switch-on changes
    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
2026-10-22 Give the bridge screen pages, held extremes and the Blackfyre look
    The status screen is graphical, in the Blackfyre dark palette with smooth
    Archivo and JetBrains Mono fonts (generated by make_fonts.py), and has
    three pages switched by a short press of the left button: drive, power (60
    s of voltage and current from telemetry, with the window's extremes) and
    link (frame rates on each side, telemetry age, source, gamepad battery).
    A status strip names the e-stop, every fault and a lost link on every
    page. The drive bars hold the recent peak current and lowest voltage for
    3 s, and a value beating its held extreme turns amber for a second.
    Content is composed in core/status (power_history, page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
2026-10-22 Hold the recent peak current and low voltage on the calibrator's charts
    The current and supply charts draw the held extreme as a named dashed line
    in the series' colour, by the bridge's rule (held 3 s after it was last
    reached, then easing back at 2 A/s or 0.5 V/s), recomputed from the
    history each frame and eased between samples as the bridge sees them. The
    readme's charts screenshots are regenerated.
    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
2026-10-22 Adapt architecture guidance to Spooder's firmware and tooling
    The firmware-shape skill gains an untrusted input and output section,
    the setup portal's safe-method, origin-check and polling rules, boundary
    placement and determinism for tests, and shrink-only baselines for new
    gates, and records the open gaps: no origin check on the portal's POSTs
    yet, and its argument checks untested. CLAUDE.md records how
    dependencies are pinned and what of the supply-chain baseline is not in
    place yet.
    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
2026-10-22 Test that the stable gaits keep the body over its support
    A host test walks Tri, Wave and Quad through their cycles in every
    direction, turning or not, at both body height extremes, and checks that
    the body centre stays 20 mm inside the polygon of the feet on the ground
    (schematic pivots, as the gesture test). Ripple, Bi and Hop are not
    statically stable and are left out: Ripple's phases sometimes leave front
    left, middle right and rear right down, a triangle with the body centre
    on its diagonal edge.
    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
2026-10-22 Add Aecert's Hexapod V1 printed parts
    Upstream's CAD STLS V2 parts and whole-robot 3MF at ca5ed27, the commit
    the movement code was ported from, copied unchanged (byte-identical to
    upstream). Later upstream commits change only the feet. The README records
    the source and the link lengths measured on these parts against the
    firmware's.
    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
2026-10-22 Show the estimated centre of gravity in the four-view window
    A static estimate from point masses (body, battery, each leg's servos and
    links) placed by forward kinematics on the schematic mounts, in
    core/movement/centre_of_gravity, with the support polygon (the hull of
    the feet on the ground) and the margin to its edge. The servo (55 g) and
    battery (284 g) are weighed; the other masses are estimates in one table.
    The desktop's legview copy is pinned by test/golden/centre_of_gravity.txt.
    The four-view window marks the centre in every view with a drop to the
    ground, draws the support polygon in the top view, and reads out the
    centre, mass and margin, coloured fine, warning or outside. A butto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
2026-10-23 Archive add-centre-of-gravity
    Its desktop-leg-view delta, the estimated centre of gravity in the
    four-view window, joins the main spec.
    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
2026-10-23 Adopt the code-review findings and split CLAUDE.md by area
    REVIEW.md sets how changes are reviewed: failure per area, Important /
    Nit / Pre-existing tags, file-and-line evidence, a nit cap, skipped
    paths, the bug classes seen before, a security lens and risk tiers.
    tools/risk-tier.sh sets a change's tier from the paths it touches. The
    deliver-changes workflow follows both: capped, diff-only re-review rounds
    with every finding answered, a security review where input arrives, a
    human approval of the exact commit (by patch id across a rebase) before a
    high-risk change merges, and testing and a revert command in its report.
    The root CLAUDE.md keeps what applies everywhere; core/, the two
    firmwa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
2026-10-23 Print near-zero centre-of-gravity golden values as zero
    CI's first run found the golden file machine-dependent: a centre that is
    zero up to a tiny residue printed as 0.000 here and -0.000 on the Ubuntu
    runner. Values that round to zero at three decimals are now printed as
    exactly 0.
    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
2026-10-24 Add board and servo reference files, the frame BOM and battery wiring
    The T-Display's STEP model, schematic and libraries (MIT), the Servo
    2040's schematic and drawing with its key dimensions, an MG996R STEP
    model (MIT), and a bill of materials derived from the frame's parts.
    The hardware-check skill gains the battery wiring: XT60, fuse, SZBK07
    and a separate 5 V logic supply fed to J6 through a Schottky diode.
    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
2026-10-24 Add the spooder-printed-parts skill
    The workflow and rules for printed parts generated as checked build123d
    code: the loop, print orientation, supportless rules, fits, wiring zones,
    the checks every part set carries and build123d pitfalls.
    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
2026-10-24 Propose add-electronics-mount
    A printed, checked mount for the electronics on the frame top: what it
    holds, sensor provisions, cable routes, access with screws into inserts,
    fan-ready cooling, PETG leaf-spring bumpers, AMS colour inlays and
    supportless printing on a P1P.
    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
2026-10-24 Revise add-electronics-mount after review
    Fans sit in deck holders so the cover lifts off unplugged; the pad is
    sized for the LSM6DSO with a 10 mm gap to the SZBK07; the Schottky diode
    is held inline in its own route; the passive air channel, the export,
    the XT60, cover-off running, bumper replacement and a 70 C heatsink
    limit get checks; the dropout risk no longer leans on the servo-rail
    trip; the directory is created new.
    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
2026-10-24 add-electronics-mount: Measurements and reference data
    measurements.py names every size the mount is built from, with its source:
    nominal held-part sizes and the Servo 2040 wire sides, listed in the README's
    "Measure before printing" table, and reference data from the frame top STL,
    the T-Display STEP model and the Servo 2040 drawing. reference_check.py
    (locked with uv) re-derives the reference data from those files;
    test_measurements.py checks the sources and the table.
    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
2026-10-24 add-electronics-mount: Generator and checks
    build.py generates the mount's part set (still empty), runs every check and
    only when all pass writes each distinct part once as STL (the cover as 3MF)
    and STEP in the frame top's coordinates, then re-reads the files. checks.py
    covers one solid per part, the keep-clear region, the frame floor and the
    256 mm bed, the deck's holes on the eight inserts, overlaps, enclosure,
    reserved routes (only the Schottky diode in the LM2596's output route),
    frame clearance under ties and slots, overhangs and teardrops in each print
    orientation, screwdriver paths and the passive air channel. test_build.py
    shows each check failing on a bad shape and passing on a goo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
2026-10-24 add-electronics-mount: Deck and layout
    Lay out the held parts by their wiring and build the deck: screwed to
    the frame top's eight inserts with spacers at the floor inserts, with
    stops, standoffs, bosses, the XT60's cradle, lead slots, tie holes, the
    end-stop entry and the pass-through. Reserve every cable run as a route
    that reaches its terminals from their wire sides, and check route ends,
    route continuity, the diode route's width and the sensor provisions.
    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
2026-10-24 add-electronics-mount: Cover
    The faceted cover, printed lid-down: 45-degree corner faces, a chamfered
    top edge, a groove round the walls, a bevelled window over the raised
    T-Display, a notch for the battery plug, flush yellow inlays exported as
    one 3MF object of two parts, and blocks that hold the SZBK07 down. Three
    M3 screws go down through the lid into inserts in posts on the deck.
    Cooling: an inlet grille low in the left wall with an optional intake fan
    position, an outlet grille high in the front-right corner face with the
    exhaust position, both fans in holders on the deck, and a passive air
    channel over the SZBK07, with turned boxes into the corner.
    New checks: fan seats, retention and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
2026-10-24 add-electronics-mount: Bumpers and holders
    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
2026-10-24 add-electronics-mount: Let one end of each bumper's leaf float
    A knock that flattened the leaf pushed its two hooks apart against their
    rails and pried the bumper off. One hook is now screwed; the other's slot
    is 1 mm longer towards it, so it slides along its dovetail (0.64 mm when
    the leaf is pressed flat), and the wider rail head keeps it on. A new
    check_bumper_ends fails the old bumper, a screw through the free end and
    a free end that can be pulled off.
    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
2026-10-24 add-electronics-mount: Documentation
    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
2026-10-24 add-electronics-mount: Verification
    Run the build and preview from a clean checkout and answer Codex's review
    of physical and assembly problems:
    - the overhang check fails a narrow face held at one end (a cantilever),
    not only a wide one; the exhaust lips now rise at 45 degrees from their
    cheeks, and the T-Display holder's 5 V notch runs out through its plate;
    - a block under the lid keeps the intake fan within its lips upside down,
    and the fans are held-down parts;
    - the air channel check measures each grille's open area through the
    cover, from exact sections at every depth;
    - the build rejects measured values the layout takes as given (the
    SZBK07's terminals, heatsink height, scr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
2026-10-24 add-electronics-mount: address review
    Stage the export and re-read it before it replaces print/ and step/, so a
    failed re-read publishes nothing; list the Servo 2040's height and the
    modules' board thickness among the values to measure; record why the
    bumpers' screws are self-tapping; drop a stale changelog sentence.
    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
2026-10-24 Document add-electronics-mount
    Bring the printed-parts skill in line with the mount (PETG, the 256 mm
    bed, print orientations, locked uv scripts, the staged export, the real
    check names) and ask for every assumed bought-part size to be listed to
    measure. REVIEW.md now reviews the mount's code, skips its generated
    files, and lists the two problems its reviews raised more than once. The
    root CLAUDE.md names the cad tasks and the mount's gate.
    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
2026-10-24 add-electronics-mount: Restyle the cover and bumpers as a rugged case
    The user's review of the first build: the leaf-spring bumpers looked
    like bent strips. The cover is now styled as a rugged sci-fi case:
    raised armour plates with 45-degree edges on its side walls, panel
    lines and hex bolt heads engraved in the lid, and yellow hazard stripes
    inlaid along its rear edge.
    The bumpers are PETG corner guards printed hollow (3 walls, no infill),
    so their shell gives in a knock. Each has a post over each end of the
    corner face round its rail, wraps onto the side walls above the inlet
    grille, a cap over the top chamfer above the outlet grille, and V grip
    grooves, held by one M2 screw. Nothing in t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
2026-10-24 add-electronics-mount: Snap the bumpers on with detents, not screws
    The user's review: an M2 screw per corner guard was more than needed.
    Each guard's wraps are now thin 1.6 mm skirts, and on each skirt's
    inner face, near its free lower corner, a quarter-sphere bump (flat face
    up, round face down) snaps into a matching dimple in the side wall,
    0.15 mm larger. The cover prints lid-down, so each dimple has a 45-degree
    point below it (a teardrop in 3D); the overhang check failed the plain
    quarter sphere. A flat catch does not cam apart, so a guard comes off by
    springing its skirts out and lifting.
    The retaining screws, their pilots and clearance holes go, which also
    ends the documented excepti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
2026-10-24 add-electronics-mount: Render each part in its print orientation
    mise run cad-preview now also draws each distinct printed part turned
    so its print_up is up, standing on a build plate, to
    images/print/<part>.png, which the README points to from the parts
    table. The plate is drawn as its own layer first: in one collection,
    matplotlib's depth sort showed it through the lid-down cover.
    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
2026-10-25 harden-host-tests: address review
    Check the source filter PlatformIO actually uses: append
    PLATFORMIO_BUILD_SRC_FILTER (or PLATFORMIO_SRC_FILTER) as PlatformIO 6.2
    does, and split it with PlatformIO's comment handling, with tests.
    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
2026-10-25 strict-firmware-builds: Robot image budget
    mise run build checks the robot image against a 256 KiB flash and a
    64 KiB static RAM budget after every build (firmware/servo2040/scripts),
    printing the use lines or failing with the overflow, so mise run upload
    never copies an image over budget. The logic is host-tested by
    test_image_budget.py, run from mise run test as test-robot-build.
    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
2026-10-25 Document firmware-build-identity
    Describe the build identity in the root, robot, bridge and tools CLAUDE.md
    files and list core/identity in the firmware-shape skill. Not archived: the
    on-board checks (tasks 5.1 and 5.2) are still open.
    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
2026-10-25 static-analysis: clang-tidy on the core
    Add .clang-tidy (bugprone-*, performance-*, a few readability checks,
    warnings as errors, header filter on core/), make tools/lint.sh check
    that the host compile database lists every build_src_filter source, and
    answer the existing findings in core/ without changing behaviour: explicit
    casts where the range is bounded, NOLINTNEXTLINE with a reason elsewhere,
    and three noisy checks disabled with their reasons.
    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
2026-10-25 static-analysis: staticcheck on the desktop calibrator
    Pin staticcheck v0.8.2 (2026.2.2) with a tool directive in desktop/go.mod
    and run it in mise run desktop-test between go vet and go test. Fix its
    one finding (ST1005, capitalised error strings in the fonts package).
    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
2026-11-05 add-gestures: Measured leg mounts (task 2.1)
    The coxa pivots are measured from upstream's frame STLs into
    core/movement/body_geometry.h, pinned for the desktop's legview by
    test/golden/body_geometry.txt: (±97.50, 0) and (±60.41, ±89.56) in
    place of the schematic pivots. The centre-of-gravity estimate, the
    gesture and gait stability tests and the calibrator's legs pane and
    views use them; support margins shrink by 6-17 mm. No firmware
    behaviour changes.
    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
2026-11-05 Propose relay-pose-diagnostics
    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
2026-11-05 Revise relay-pose-diagnostics after review
    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
2026-11-05 relay-pose-diagnostics: Pose and diagnostics on every link
    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
2026-11-05 relay-pose-diagnostics: Documentation
    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
2026-11-05 relay-pose-diagnostics: address review
    Test the revised healthy-link scenario: telemetry, pose and diagnostics
    at 10 Hz each show as about 30 frames per second on the bridge.
    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
2026-11-05 Document relay-pose-diagnostics
    The hardware-check skill's healthy bridge link rate is now about 30
    accepted frames per second, and the bridge's CLAUDE.md names the pose
    and diagnostics frames its link task decodes and ignores.
    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
2026-11-05 add-wifi-drive: Hardware-free logic in the core
    The drive mode decision and switch notice, the handheld controller
    (datagram validation, rate window, sender lock, sequence rule, liveness,
    counter translation, e-stop), the relay queue, the decoder's raw frame
    bytes, the WiFi drive network name and the WiFi drive screen content,
    with host tests for the change's scenarios.
    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
2026-11-05 add-wifi-drive: Bridge firmware
    The third boot path: GPIO32 read in app_main before either radio, WiFi
    drive with its own access point (spooder-drive-XXXX, drive_pass), the UDP
    task on port 52040 feeding the handheld controller, the relay of the
    robot's frames through relay_queue (now tied to the handheld's sessions,
    host-tested), and the screen in both drive modes with the switch notice.
    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
2026-11-05 add-wifi-drive: Desktop probe
    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
2026-11-05 add-wifi-drive: Documentation
    The three boot paths, the drive mode switch on GPIO32, the WiFi drive
    tasks and UDP rules in the bridge and core guides and the firmware-shape
    skill; wiring the switch, joining WiFi drive and the probe checks in the
    hardware-check skill; the probe in desktop/CLAUDE.md; readme, root
    CLAUDE.md and changelog.
    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
2026-11-05 add-wifi-drive: address review
    Relay: after a session change, drop robot frames until a link poll of
    the new session ends with the decoder empty, so bytes buffered in the
    UART or the decoder during one session never reach the next session's
    sender. Share the UDP task's read policy (readDelayMs) with a flood
    test through a modelled receive mailbox. Record the accepted replay
    risk within the WPA2 network, and make task 6.2's flood check
    measurable.
    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
2026-11-05 Document add-wifi-drive
    Record that no relayed frame crosses a session in the changelog, name
    the probe in desktop-build, align the flood check with task 6.2, note
    golden_frames.h in test/CLAUDE.md, and widen REVIEW.md's counter
    baseline class to state carried across a session boundary, flagged
    twice in this delivery.
    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
2026-11-05 add-wifi-drive: reconcile with relay-pose-diagnostics
    The robot now sends pose and diagnostics on the bridge link, so the WiFi
    drive relay forwards them to the handheld; drop the stale 'until
    add-wifi-drive relays them' notes.
    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
2026-11-06 add-bench-simulation: Shared model and protocol
    Move the virtual robot's servo and supply model into core/robot/bench_model,
    add the TELEMETRY_SIMULATED flag, the inhibiting SIMULATION_SUPPLY protection
    fault with protection::step's defaulted simulationSupply parameter, and the
    telemetry_bench_simulation golden vector, with their tests.
    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
2026-11-06 add-bench-simulation: address review
    Assert the walking telemetry and pose frames against the model in
    simulation, and the Initialise-then-Stand recovery after an emergency stop.
    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
2026-11-06 Document add-bench-simulation
    Summarise bench simulation in the root CLAUDE.md, and add the two review
    findings that recurred in this delivery to REVIEW.md's bug classes: a mode
    contradicting a main spec without a delta, and a test that drives a scenario
    without asserting its outputs. The change stays unarchived: its bench
    checks (tasks 7.1 to 7.4) need the board.
    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
2026-11-06 Revise add-handheld-controller after review
    Start in Sleep, mask Select-combination buttons until released, neutral
    pad during a leave, two-frame leave confirmation by sequence number,
    per-type display freshness with rebaselining, power save restored around
    suspend and power-off, a bounded virtual-bridge backlog with flood and
    tick checks, and tighter checks for the desktop start-up and check-glibc.
    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
2026-11-06 add-handheld-controller: The pak
    The patched gabagool (power-button hook, mise run handheld-fork), the
    spooder-handheld binary with its drive screen and SDL controller table,
    launch.sh, the host and device builds, the packaging and the CI job.
    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
2026-11-06 Document add-handheld-controller
    The handheld's pins (nested go.sum, gabagool hash, device build image)
    in the dependency rule, the handheld as a review area and outside-input
    source in REVIEW.md, and the POSIX sh rule for the pak's scripts that
    the dash failure at the gates would have needed.
    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
2026-11-06 add-handheld-controller: drive screen look, hints, diagnostics and top view
    The drive screen in the Blackfyre style; the requested panel's labels hint
    their buttons; the robot panel's SOURCE cell, pressed keycaps and the
    fault-clear hold's progress, with an e2e test of the e-stop and fault clear;
    and the Select + X top-view page, the robot from above drawn through legview
    from the relayed pose.
    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
2026-11-06 handheld: driving view and bench simulation indication
    The drive screen's second page (Select + X) draws the robot from a chase
    camera fixed behind it, looking forward and 45 degrees down in perspective
    over a ground grid at the lowest foot, in place of the top view. While
    telemetry reports bench simulation, a SIM chip leads the header on both
    pages and the output reads as simulated.
    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
2026-11-06 firmware-build-identity: robot banner confirmed on the board (5.1)
    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
2026-11-06 handheld: signal level from iw, coloured by strength
    The TrimUI has no /proc/net/wireless, so the SIGNAL chip stayed at "—".
    Read the signal: line of iw dev wlan0 link when the statistics file is
    missing, sampled at start and every second in the background with a
    500 ms bound. The header's signal chip carries a dot: ok from -67 dBm,
    warning from -80 dBm, orange below, muted while unknown.
    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
2026-11-06 Document add-handheld-gesture-overlay
    Name the gesture overlay and its on-device check in the hardware-check
    skill, and the gesture golden file in the kinematics skill and core/.
    The change stays open for its on-device task 6.1.
    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
2026-11-06 handheld: read the signal level under the lock
    Screen read signalKnown and signalDBm after releasing a.mu, while the
    background sampler (SampleSignal) writes them under it: a data race that
    go test -race reports in TestSignalFromIwOnDevice. Copy them while the
    lock is held.
    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
2026-11-06 add-gestures: keyframe pose, six foot overrides, hold fields (step 0)
    The shapes the part-two lanes share: a Pose per keyframe instead of a
    shift and twist, a foot target for any of the six legs, a per-keyframe
    foot speed limit, and hold/unfold fields on Script. Behaviour unchanged:
    the player applies the translation only and no script holds; the gesture
    fixture is unchanged.
    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
2026-11-06 Script the front-pair attack within the joint speed budget
    Brace over four planted feet, raise the front pair and strike twice. Check travel and world-frame support at both height extremes, report governed strike durations, and regenerate the handheld preview.
    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
2026-11-06 Add planted-foot dance at 120 BPM
    Script an eight-beat dance, with a height-relative front-foot tap before straightening. Check world-frame support, reach, servo travel and player/body timing at both height extremes, and regenerate the handheld preview.
    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
2026-11-06 add-gestures: test that dance rolls, nods, twists and bounces
    Review finding (dance lane): the dance tests checked the beat, the
    planted feet, the tap and the joint budget, never the moves the spec
    scenario names; they passed with the moves removed. The new test fails
    without them.
    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
2026-11-06 add-gestures: the body's underside below the pivots (task 2.3)
    Measure the body's lowest point from upstream's STLs: the coxa links'
    lower ends (Coxa Horn Connector, flush with the coxa side plates) lie
    24.2 mm below the coxa pivots, under Frame Bottom's underside at 15.75.
    body_geometry::UNDERSIDE_Z holds it, test/golden/body_geometry.txt gains
    an underside line (the desktop's legview test parses it), and
    centre_of_gravity::undersideGrounded says when the body rests on its
    frame, which the gesture support test then counts as the support.
    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
2026-11-06 add-gestures: ball's final choreography (task 2.5)
    Ball lowers the body until its underside is 3 mm above the ground, rests
    on its frame as the feet lift 8 mm, draws the feet 18 mm in (the femur's
    travel with the default calibration allows no more near the ground) and
    holds; the unfold spreads, plants, then stands. Its heights come from
    body_geometry::UNDERSIDE_Z and the standing height (Keyframe.zAboveGround,
    Lift.relativeToPlanted, gesture::keyframePose), so they hold at every
    body height.
    test_gesture's support check now knows the floor (the standing feet's
    world height at the start): a foot or the underside through it, or the
    underside off it with fewer than three feet on it, fails; a t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
2026-11-06 add-gestures: name the underside's lowest point in D3 and task 2.3
    Review finding (underside lane): the design and the task still named
    Frame Bottom.stl; the lowest point is the Coxa Horn Connectors and the
    coxa side plates. Task 2.7's robot measurement also covers the wedge's
    orientation and the unmodelled horn screw head; the legs pane's support
    while the body rests on its frame is recorded as a follow-up.
    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
2026-11-06 add-gestures: answer the ball review (Sleep lift, fold margin)
    Sleep from the ball hold lifts the body 21.8 mm (UNDERSIDE_Z - REST_POSE.z)
    onto its feet at the rest pose, which is where every Sleep ends before
    output stops; it is slower than a Sleep from Stand at the same height
    (151 vs 181 mm/s at the foot, 55 vs 89 deg/s at the joints at height 0)
    and within the joint budget. Design D1 now says so instead of "carries no
    weight", and a test_body test pins the lift and its bound.
    The 18 mm fold is 6 mm short of the first fold that leaves a servo's
    travel (24 mm), not "as far as the travel allows": the comment and the
    changelog say so, and test_gesture pins the margin. "Provisional" goes
    fro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
2026-11-07 Supply bands on the pak and the bridge
    The supply voltage and current read green, amber or orange by band
    against the protection limits the robot reports in its diagnostics
    frames: core/status/supply_band for the bridge, a Go copy in the pak,
    both run over test/golden/supply_bands.txt. The voltage warning margin
    is the brown-out-to-undervoltage gap, pending the user's decision.
    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
2026-11-07 handheld: sound feedback
    Generated tones for the bridge's rumble events plus a gesture accepted
    and a leave, with rumble's repeat guard and priorities, judged from the
    screen model in internal/feedback behind a Player interface; SDL's audio
    device plays them. Select + B switches the sound off and on, kept
    between runs beside the binary. Records the user's decisions on the
    supply bands and the sound in the OpenSpec change.
    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
2026-11-09 movement: weighed masses in the centre-of-gravity model
    One leg outward of the coxa servo weighs 303 g and the central frame with
    the six coxa servos 827 g, so BODY_G is 497 g. The links split the leg's
    mass in the old ratio; the golden file is regenerated.
    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
2026-11-09 Wave is the starting gait
    The bridge's gamepad mapping, the setup portal, the pak and the desktop
    calibrator start in Wave, the only gait the weighed robot carries at a
    150 mm stance. The gait order is unchanged. OpenSpec change
    wave-default-gait.
    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
2026-11-09 movement: the battery at the centre of the cavity under the frame
    The battery fills Frame Bottom's channel, between its sides, its front
    wall and the step in its floor, up to Frame Top's underside, so its centre
    is that box's: (0, -0.175, 1.125) mm. The golden file is regenerated and
    the measurement recorded with the other frame measurements.
    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
2026-11-09 movement: the robot starts in Wave too
    The robot reported Tri while its body was stopped (no servo supply) and
    whenever no source was in control, although every controller starts in
    Wave. One constant, gait::START_GAIT, now sets the body's starting gait
    (the field's default and body::init), MovementCommand's default (the
    no-source command and the serial keys) and the gamepad mapping's start.
    The bridge's WiFi drive without a live handheld, its first frames, the
    WiFi probe and the virtual robot's simulated bridge start at Wave as well.
    wave-default-gait design D2 is corrected and gains a usb-link delta.
2026-11-09 docs: correct the handheld's join screen and screenshot notes
    The add-handheld-controller design no longer says gabagool draws the join
    and leave screens, and names the network-name check; the hardware check
    says Menu quits the start screen too; the screenshot states list
    offnetwork; the wlan example SSID is lower-case, as the pattern requires.
2026-11-09 bench_sim: wait for USB before offering simulation
    During the 3 s window after start-up LED 5 blinked white from the first
    tick, before a host had enumerated the board, so an early press was
    refused for no USB host and closed the window. LED 5 now blinks amber
    slowly (on half of each second, distinct from the stale link's 250 ms
    amber blink) until a USB host is attached, and white only from then on.
    A press while amber is still refused, as before.
2026-11-10 parametric-reference-parts: Foundation
    The build, gates, STEP export and import checks of the parametric
    reference parts, with their unit tests and the cad-reference mise task.
2026-11-10 parametric-reference-parts: Frame group
2026-11-11 Archive parametric-reference-parts
    Sync its spec into openspec/specs/, read the chord error table from the
    part set's README instead of the change's design.md, and point the
    printed-parts skill at the reference parts.
2026-11-11 parametric-femur-parts: Femur group
    Femur Horn Side, Femur Bearing Side and Femur Support as feature-built
    solids, the side plates' shared plan and AXIS_TO_AXIS (110 mm, against
    the source README's 108) in parts/_femur.py, their STEP files, the
    femur table, and test_femur.py checking the bore axes against it.
2026-11-11 parametric-foot-parts: Foot Shaft and Foot Tip
2026-11-11 parametric-foot-parts: Foot Left and Foot Right
    The foot half in parts/_feet.py, its serpentine flexure built from its
    path (runs and turns) and named FLEXURE_ dimensions; Foot Left builds it,
    Foot Right mirrors Foot Left's solid across x = 124.4452 and moves it
    -1.0691 mm along y. Both pass the global gates; their rows join the feet
    group's table. Codex review: the flexure is built along its path rather
    than as cuts from a block, and the channel slope and chamfer angle are
    named constants.
2026-11-11 parametric-foot-parts: Export and documentation
    No foot needs an exception (chord error 0.003 mm each, all gates pass);
    the feet group's README section gains the flexure's named dimensions and
    how Foot Right is made, test_feet.py checks the group, the retuned
    flexure, the exceptions against the chord error and the README amounts,
    and the four STEP files are exported and pass the FreeCAD and solidcraft
    import checks.
2026-11-14 docs: bill of materials and wiring
